haggis-aerospace/HaggisAero2021-22/renders/cbf.JPG

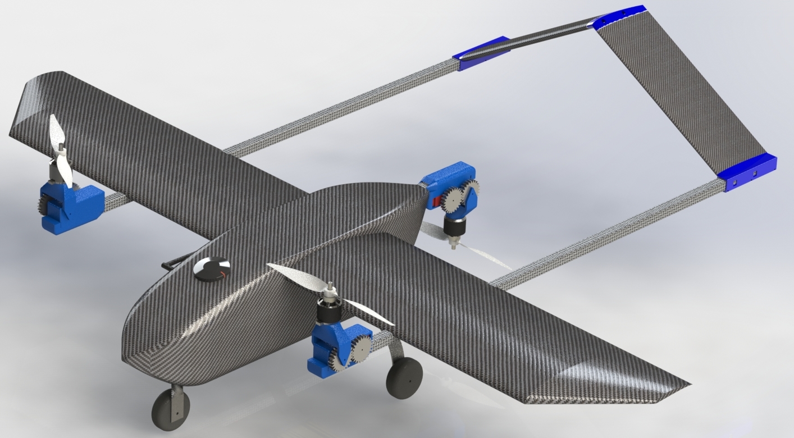
renders/cbf.JPG
