haggis-aerospace/HaggisAero2021-22/README.md

# HaggisAero2021-22
Haggis aerospace drone design repo used to share solidworks and other files

when moddeling create a new branch and when you think its good, tell the admin to check it and try to merge it with the main. DO NOT PUSH STRAIGHT TO MAIN if your not sure its not gonna break stuff.
