haggis-aerospace/HaggisAero2021-22/Finalised challenge documents/team 25-pdr-submission-form.pdf

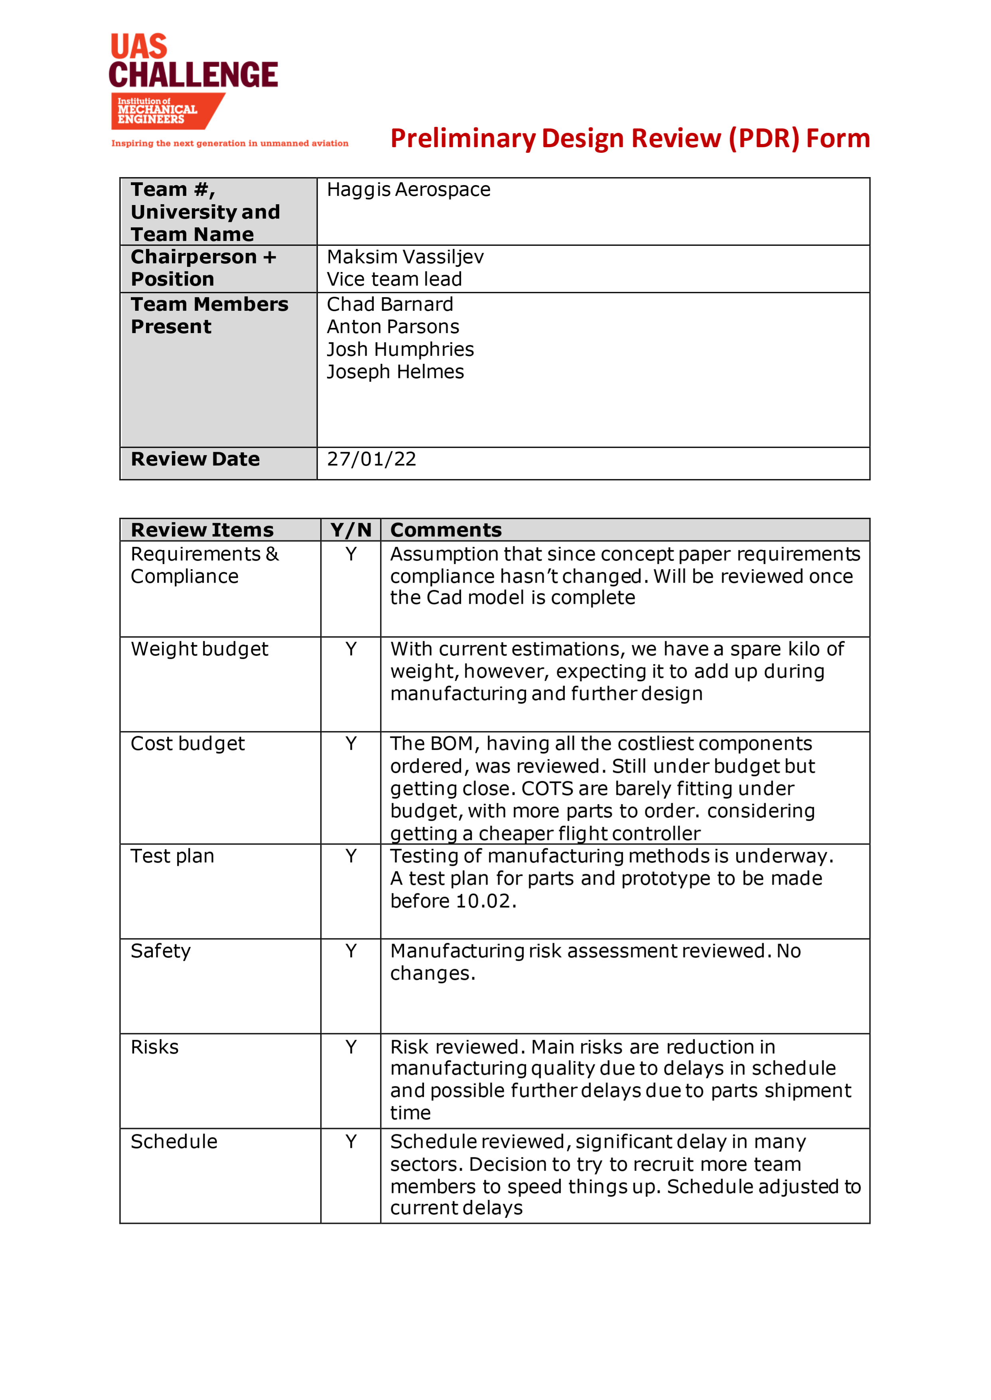
[picture p17: page 1]
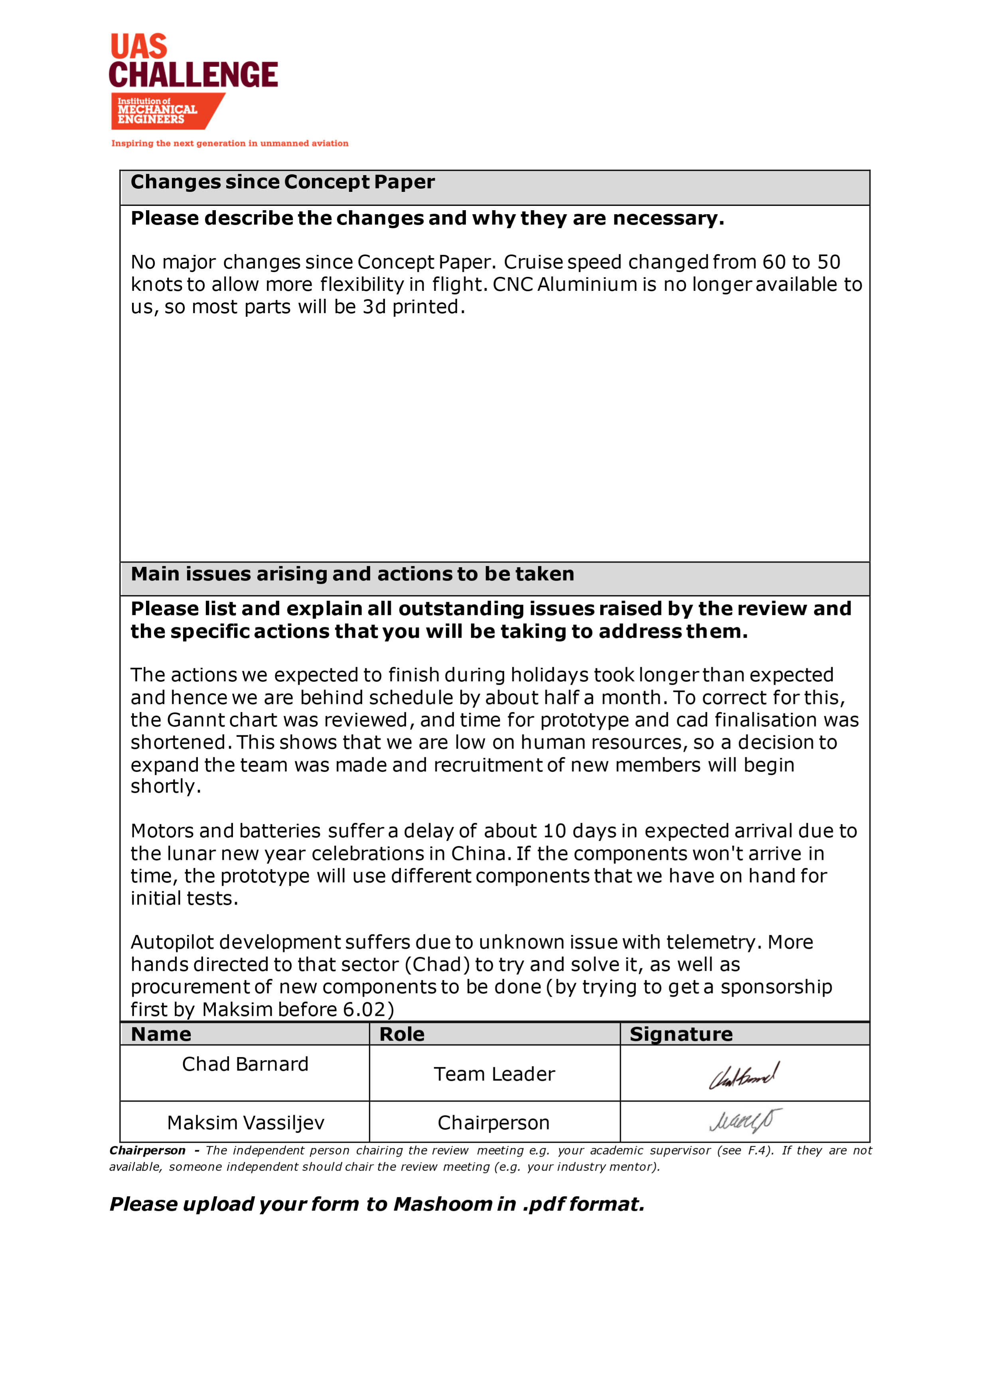
[picture p18: page 2]
