haggis-aerospace/HaggisAero2021-22/CAD/Tail/side.pdf

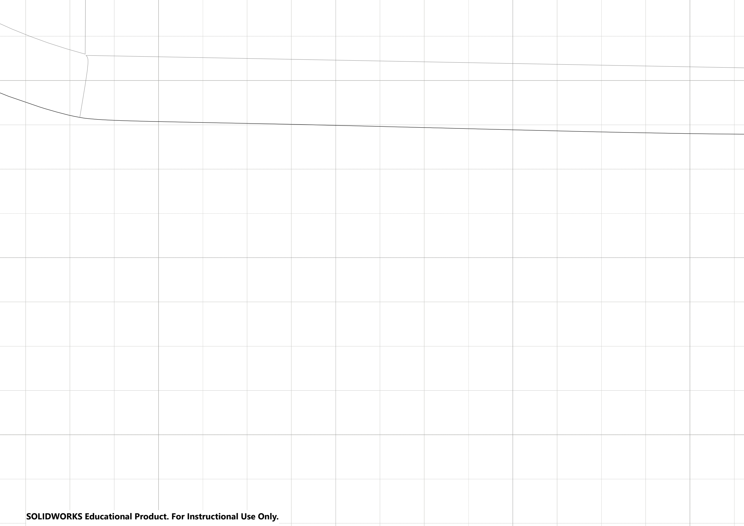
[picture p19: figure]

SOLIDWORKS Educational Product. For Instructional Use Only.
