haggis-aerospace/HaggisAero2021-22/renders/drawn.JPG

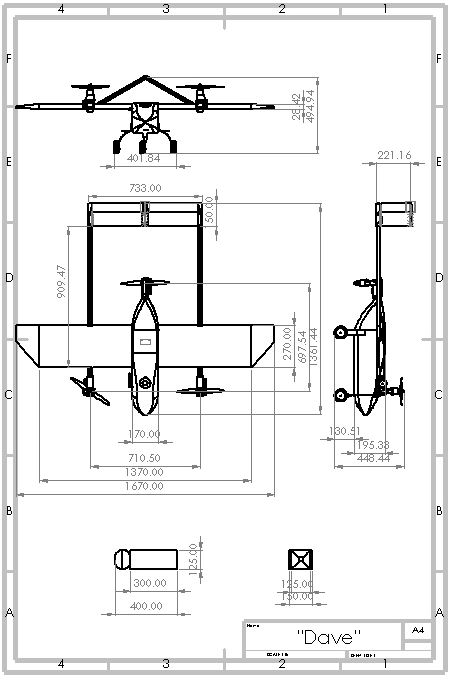
renders/drawn.JPG
