haggis-aerospace/HaggisAero2021-22/simulations/wing.png

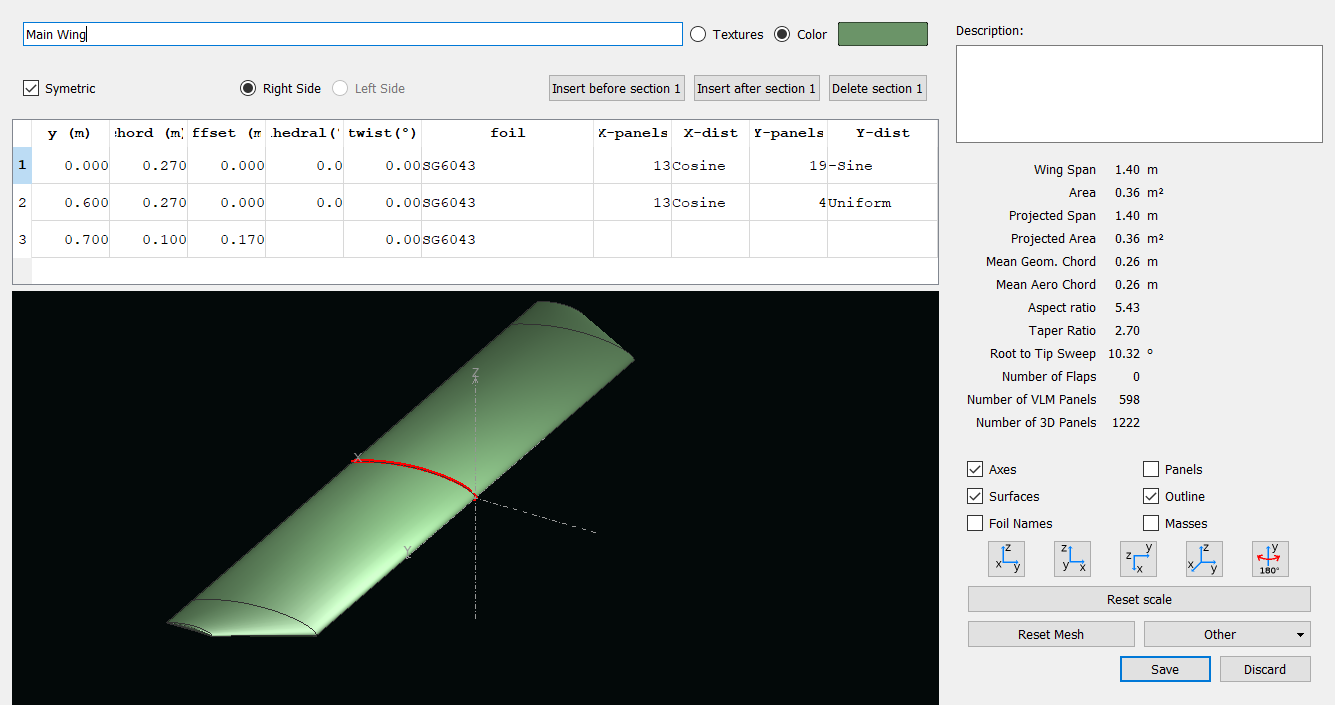
simulations/wing.png
