haggis-aerospace/HaggisAero2021-22/CAD/Motor rotator 2/Motor rotator assembly 3.SLDASM

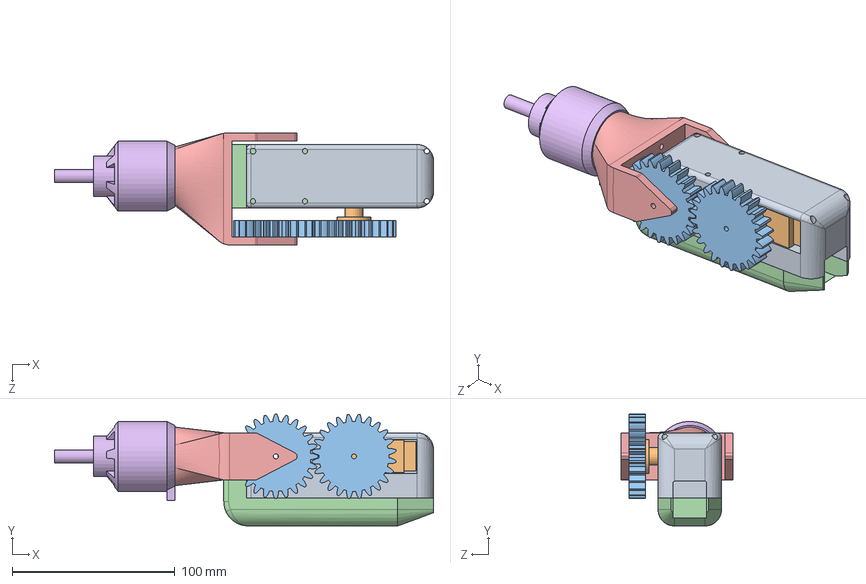
[picture p22: CAD file, 2022-06-10]
CAD/Motor rotator 2/Motor rotator assembly 3.SLDASM
232.9 x 68.7 x 68.7 mm
Rotator Base 2
Servo futaba
spur gear_iso x 2
Rotator bottom
Fork 3
Motor Tmotor mn3520-11 400kv
