haggis-aerospace/HaggisAero2021-22/CAD/Motor rotator/Motor Rotator Assembly.SLDASM

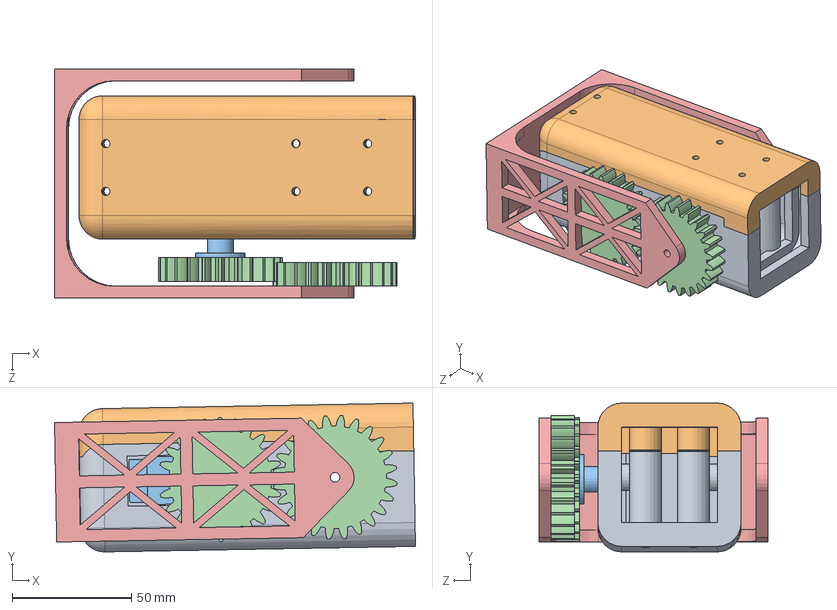
[picture p23: CAD file, 2022-03-11]
CAD/Motor rotator/Motor Rotator Assembly.SLDASM
151.1 x 62.3 x 96.0 mm
Rotator Base
Rotator Lid
Servo futaba
spur gear_iso x 2
Fork
