haggis-aerospace/HaggisAero2021-22/manufacturing/Wing/main wing stencil.SLDPRT

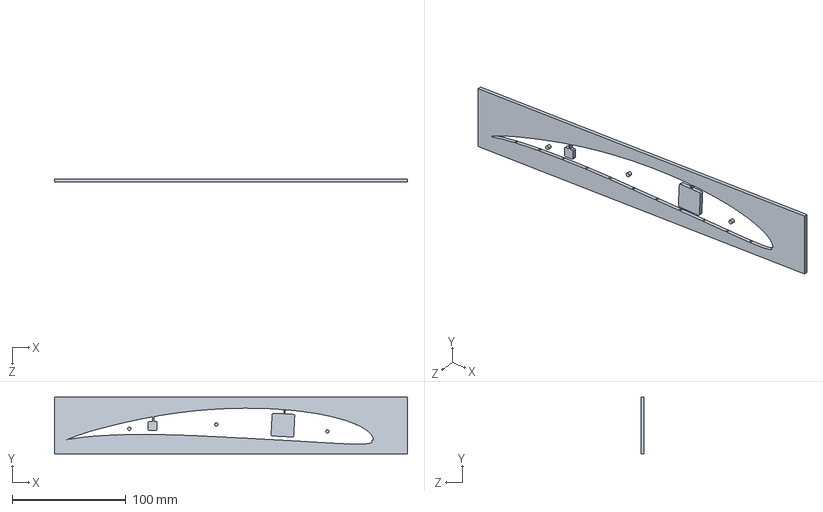
[picture p24: CAD file, 2022-06-06]
manufacturing/Wing/main wing stencil.SLDPRT
310.0 x 50.0 x 3.00 mm
