haggis-aerospace/HaggisAero2021-22/CAD/Fuselage/3dp parts/main spar side holder.SLDPRT

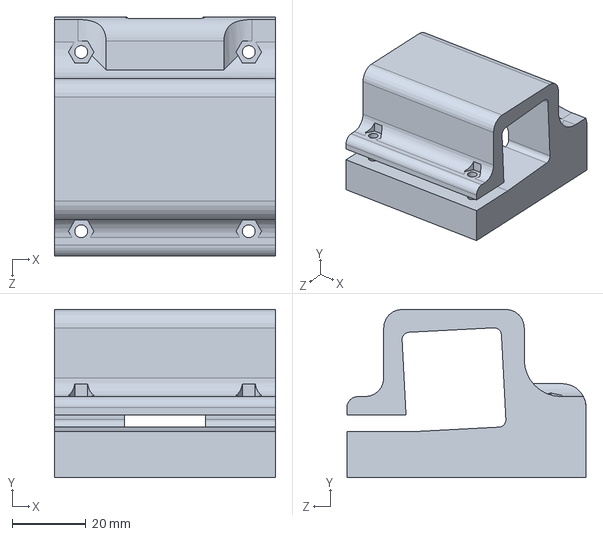
[picture p25: CAD file, 2022-04-14]
CAD/Fuselage/3dp parts/main spar side holder.SLDPRT
60.0 x 45.7 x 65.0 mm
