haggis-aerospace/HaggisAero2021-22/CAD/Fuselage_Payload/Payload assy.SLDASM

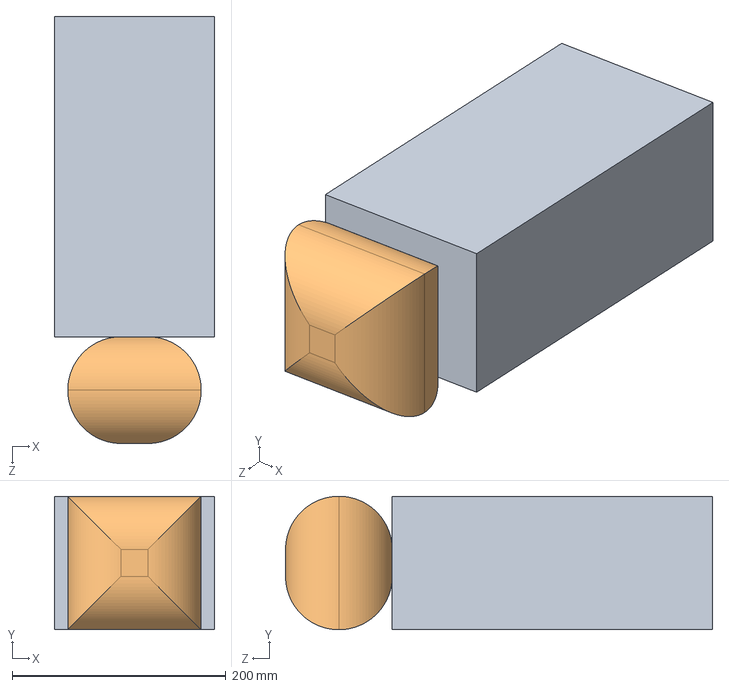
[picture p26: CAD file, 2022-04-14]
CAD/Fuselage_Payload/Payload assy.SLDASM
150.0 x 125.0 x 400.0 mm
Payload
PParachute
