haggis-aerospace/HaggisAero2021-22/CAD/landing gear/rear assy.SLDASM

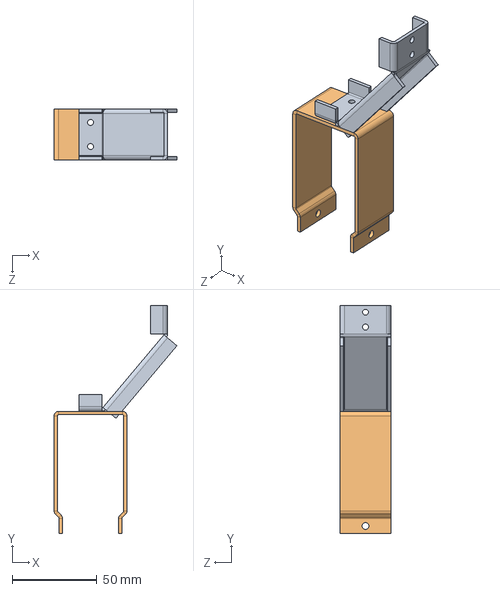
[picture p27: CAD file, 2022-06-29]
CAD/landing gear/rear assy.SLDASM
72.4 x 134.3 x 30.0 mm
rear gear base
rear U bracket
