haggis-aerospace/HaggisAero2021-22/CAD/Tail.SLDASM

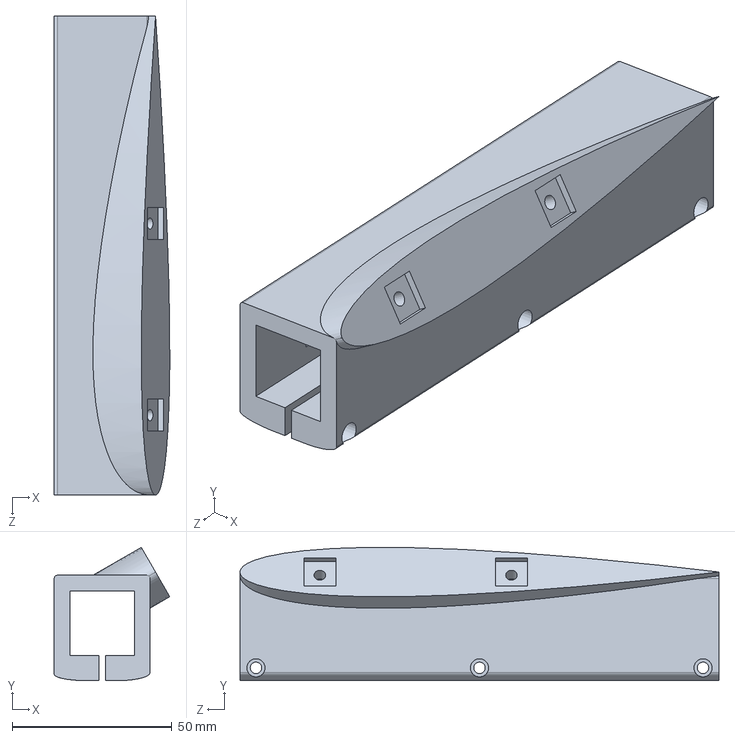
[picture p28: CAD file, 2022-04-14]
CAD/Tail.SLDASM
36.2 x 41.7 x 150.0 mm
