haggis-aerospace/HaggisAero2021-22/CAD/Wing/wing assembly.SLDASM

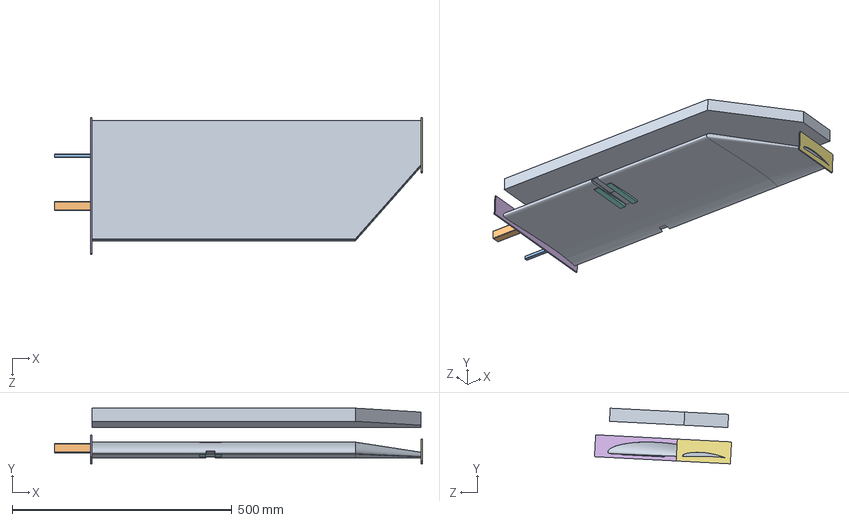
[picture p29: CAD file, 2022-06-21]
CAD/Wing/wing assembly.SLDASM
838.0 x 126.8 x 312.2 mm
wing spar large
wing spar small
MainFoil
battery 4s 2p
tail wing conector
