haggis-aerospace/HaggisAero2021-22/manufacturing/Endplates/Main Wing Endplate.SLDPRT

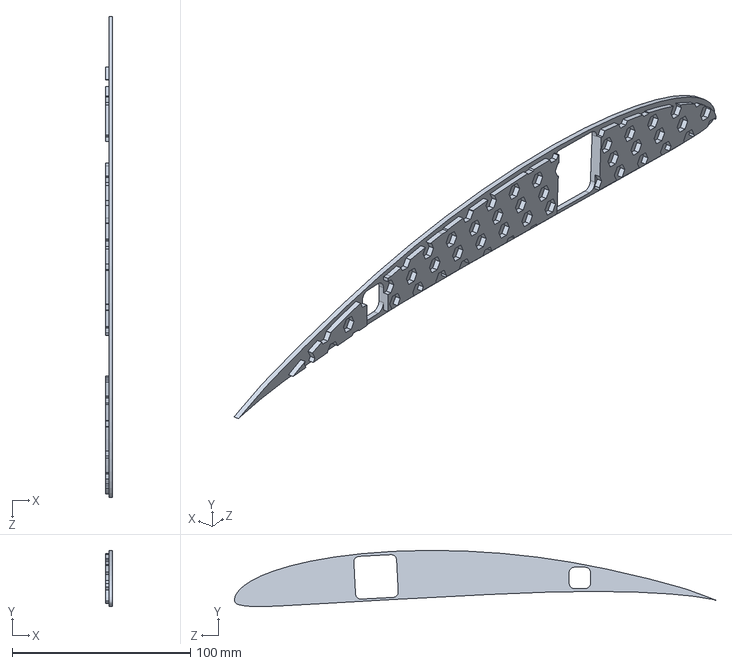
[picture p30: CAD file, 2022-06-18]
manufacturing/Endplates/Main Wing Endplate.SLDPRT
4.00 x 31.6 x 270.0 mm
