haggis-aerospace/HaggisAero2021-22/manufacturing/Wing/FAT main wing stencilS 3.DXF

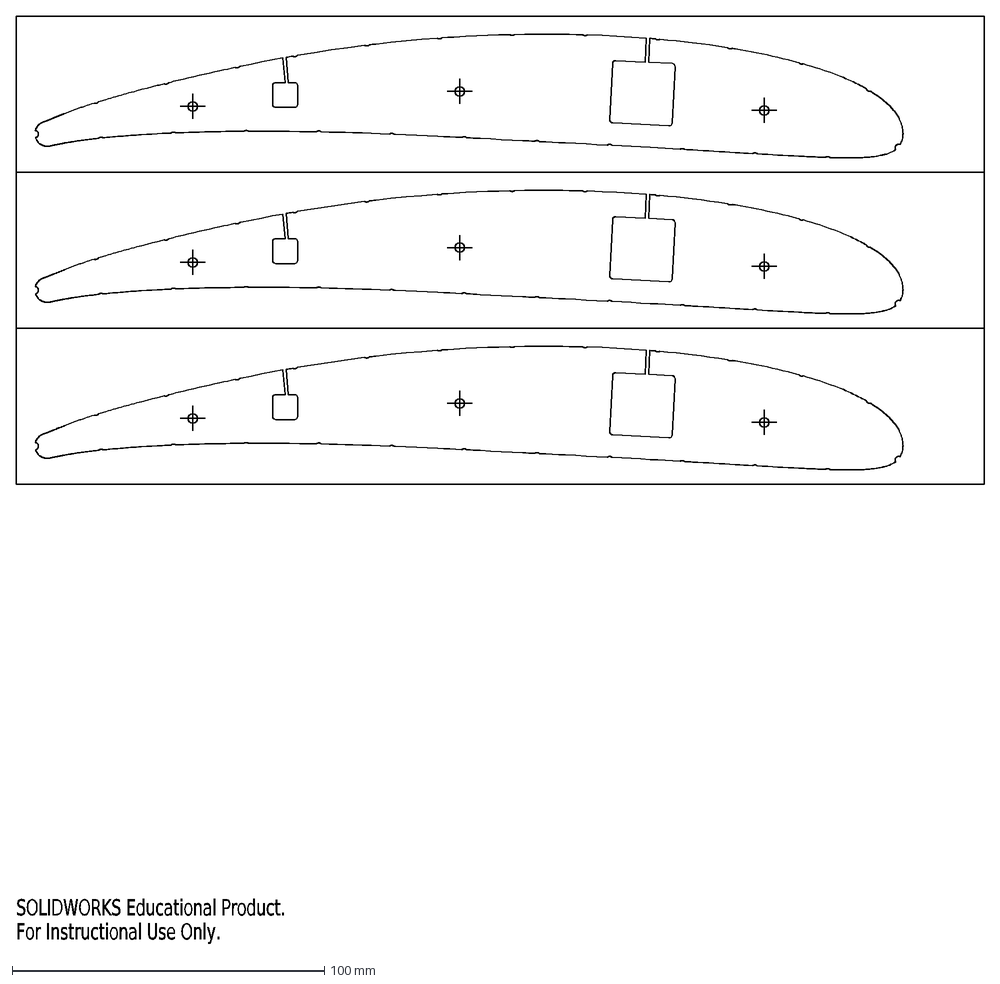
[picture p31: CAD file, 2022-06-06]
manufacturing/Wing/FAT main wing stencilS 3.DXF
SOLIDWORKS Educational Product.
For Instructional Use Only.
