haggis-aerospace/HaggisAero2021-22/Tail/tail assy.SLDASM

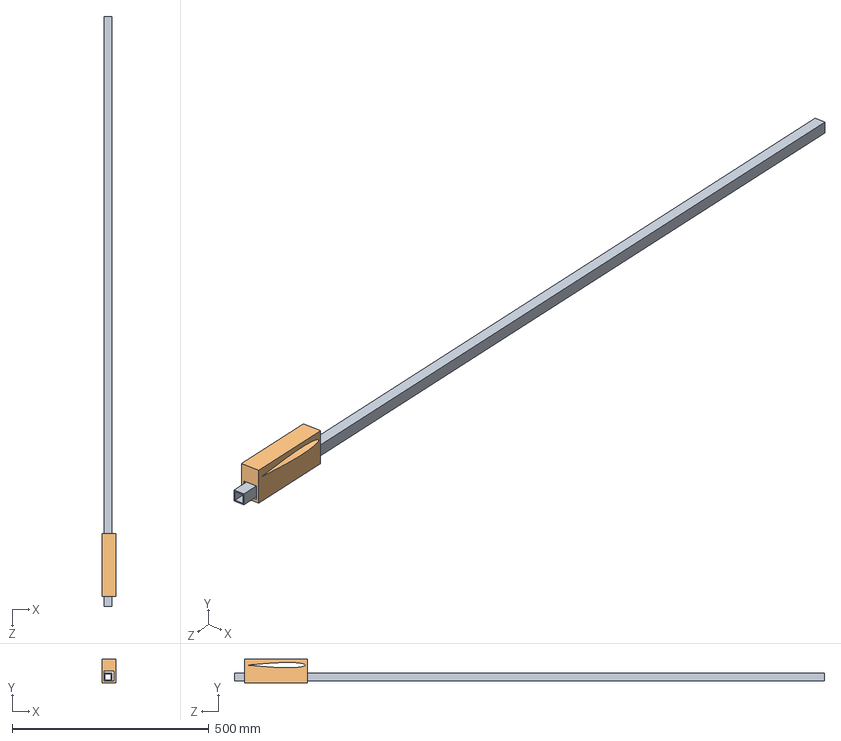
[picture p32: CAD file, 2023-02-27]
Tail/tail assy.SLDASM
35.0 x 60.3 x 1500.0 mm
tail spar
bracket^TAIL2023
