haggis-aerospace/HaggisAero2021-22/CAD/Motor mount/static motor mount assembly.SLDASM

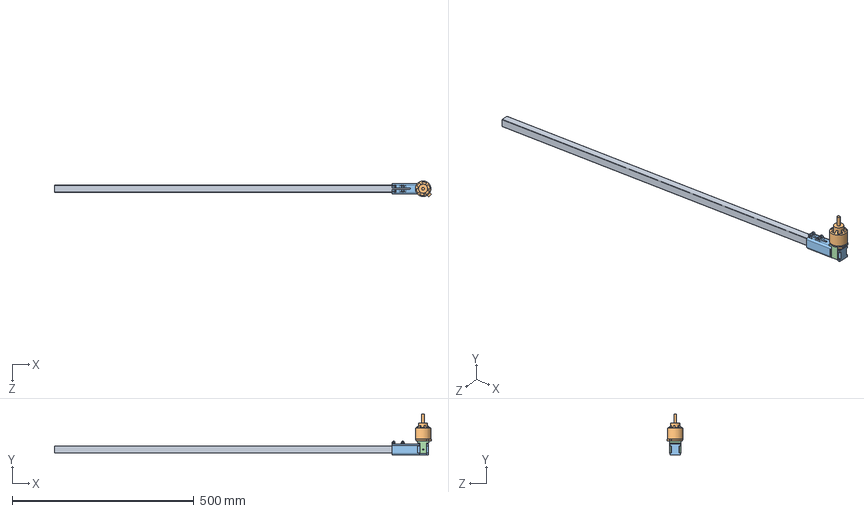
[picture p33: CAD file, 2022-06-07]
CAD/Motor mount/static motor mount assembly.SLDASM
1036.0 x 112.5 x 44.5 mm
tail booom
Motor Tmotor mn3520-11 400kv
base
motor plate
