haggis-aerospace/HaggisAero2021-22/CAD/Motor rotator 2/MirrorMotor rotator assembly 3.SLDASM

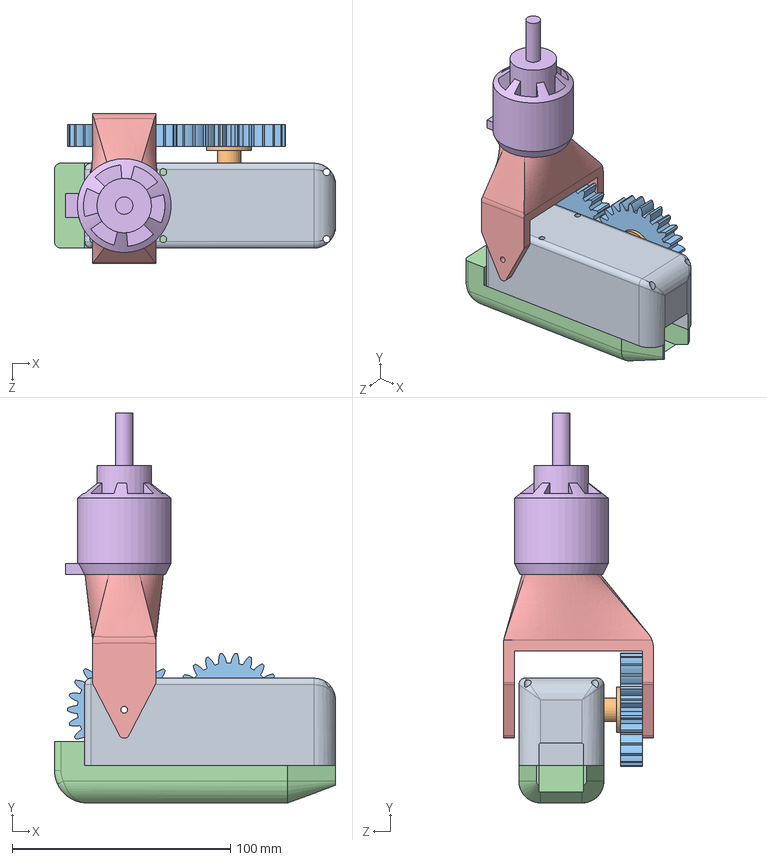
[picture p34: CAD file, 2022-04-14]
CAD/Motor rotator 2/MirrorMotor rotator assembly 3.SLDASM
128.9 x 178.8 x 68.7 mm
MirrorRotator Base 2
MirrorServo futaba
spur gear_iso x 2
MirrorRotator bottom
MirrorFork 3
MirrorMotor Tmotor mn3520-11 400kv
