haggis-aerospace/HaggisAero2021-22/manufacturing/stl's for 3 print/main spar side holder.STL

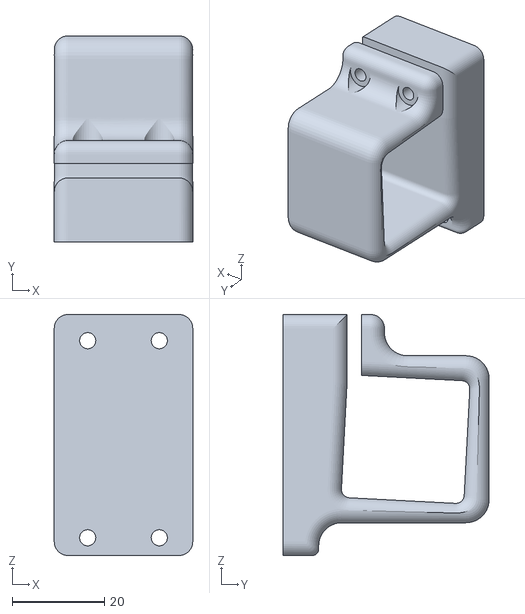
[picture p35: CAD file, 2022-03-09]
manufacturing/stl's for 3 print/main spar side holder.STL
30.0 x 44.7 x 52.2
