haggis-aerospace/HaggisAero2021-22/Tail/TAIL2023.SLDASM

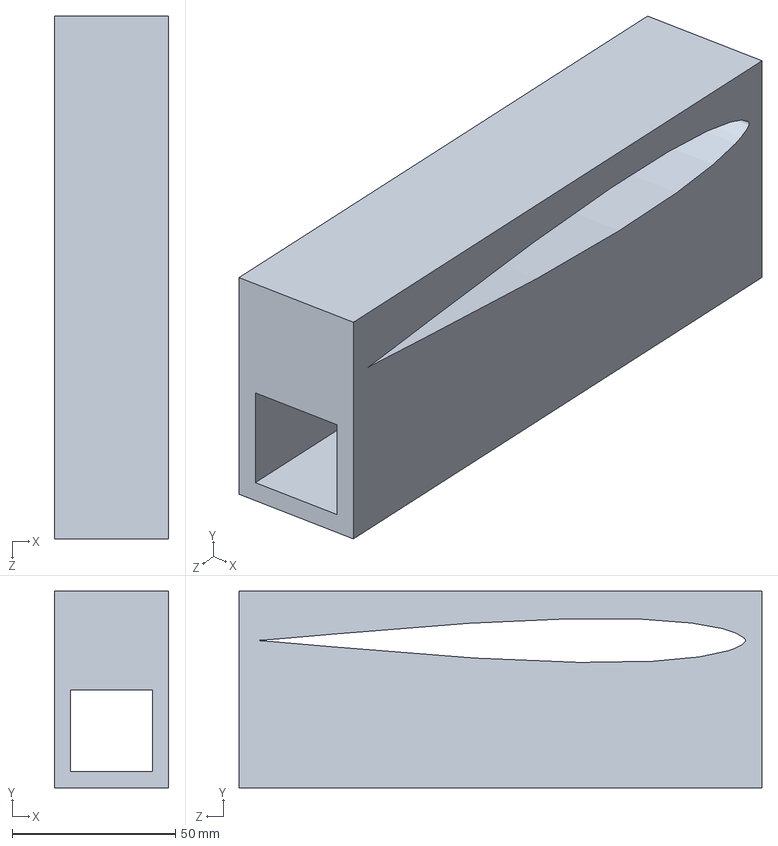
[picture p36: CAD file, 2023-02-27]
Tail/TAIL2023.SLDASM
35.0 x 60.3 x 160.0 mm
