haggis-aerospace/HaggisAero2021-22/CAD/Masterr assembly.SLDASM

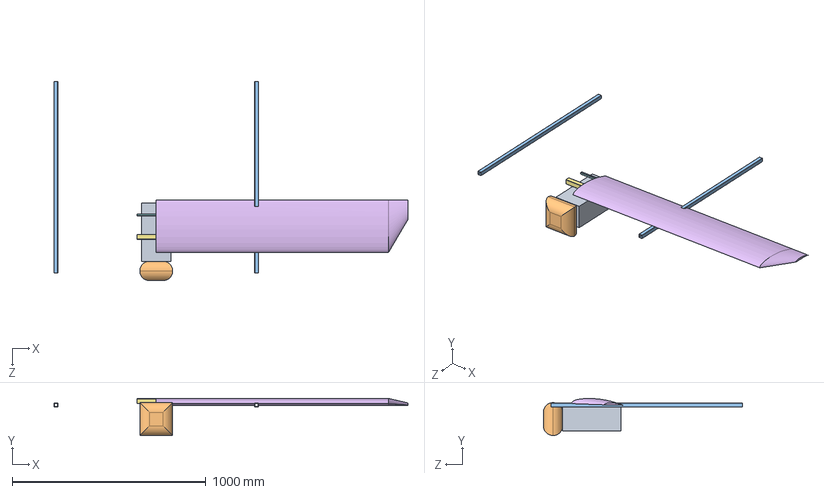
[picture p37: CAD file, 2022-01-28]
CAD/Masterr assembly.SLDASM
1828.0 x 191.2 x 1029.0 mm
Payload
PParachute
tail booom x 2
wing spar large
wing spar small
MainFoil
center spar connector
small center sparr connector
