haggis-aerospace/HaggisAero2021-22/CAD/Wing/MainFoil.SLDPRT

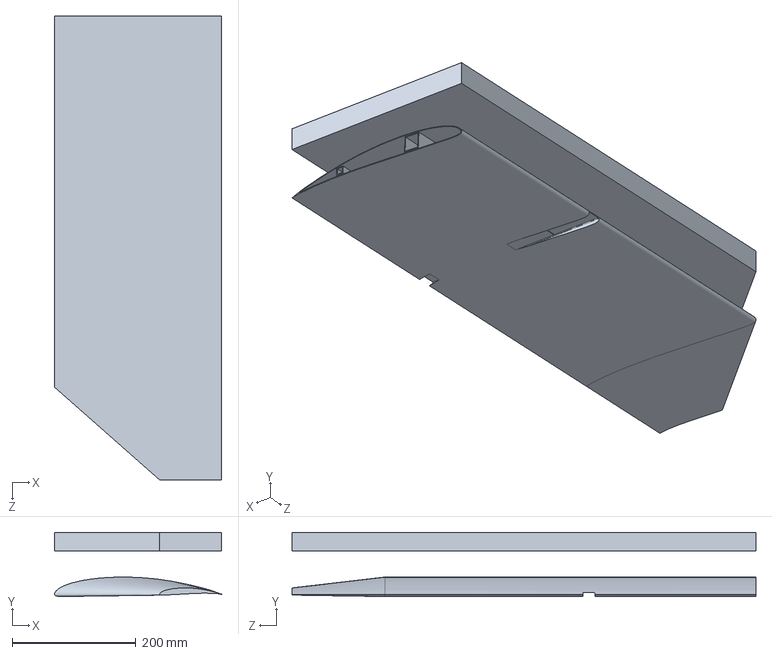
[picture p38: CAD file, 2022-06-21]
CAD/Wing/MainFoil.SLDPRT
270.0 x 103.7 x 750.0 mm
