haggis-aerospace/HaggisAero2021-22/manufacturing/Endplates/Assem1.SLDASM

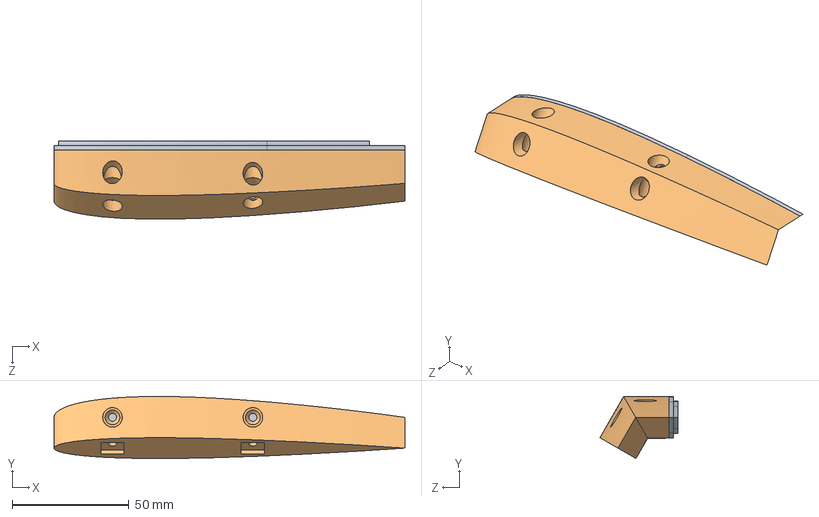
[picture p39: CAD file, 2022-06-18]
manufacturing/Endplates/Assem1.SLDASM
150.0 x 26.5 x 33.5 mm
Tail wing endplate
Tail_Top_Piece_V2
