haggis-aerospace/HaggisAero2021-22/manufacturing/fuselage mold/mould assy.SLDASM

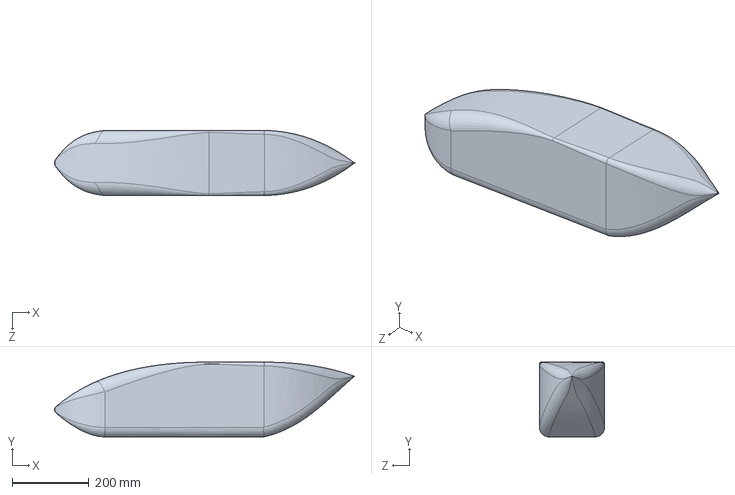
[picture p40: CAD file, 2022-02-09]
manufacturing/fuselage mold/mould assy.SLDASM
783.9 x 195.3 x 170.0 mm
