haggis-aerospace/HaggisAero2021-22/CAD/Electronics/rasbery pi/RaspberryPi.SLDASM

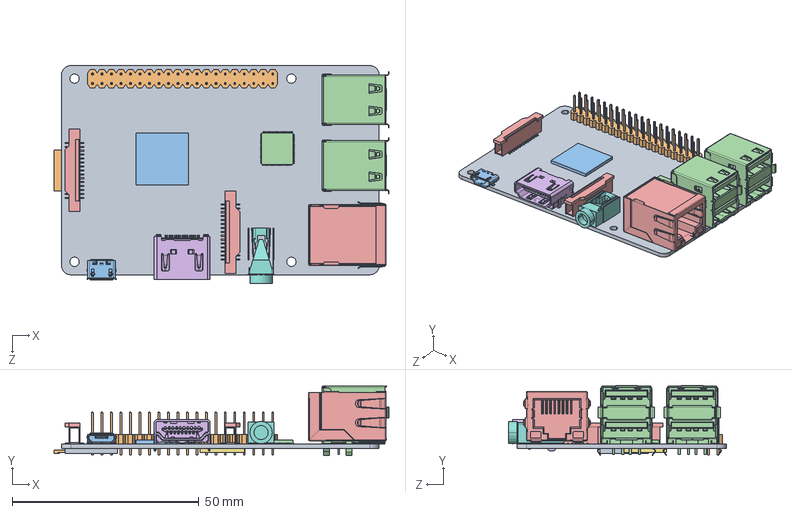
[picture p42: CAD file, 2022-02-02]
CAD/Electronics/rasbery pi/RaspberryPi.SLDASM
89.6 x 18.7 x 58.3 mm
Mainboard2
GPIO
Processor
GPU
CameraAssembly x 2
HDMI
RAM
Audio
MicroSDSocket
MicroSD
micro USB2
usb double x 2
RJ45-LED
