haggis-aerospace/HaggisAero2021-22/CAD/landing gear/assy of LG.SLDASM

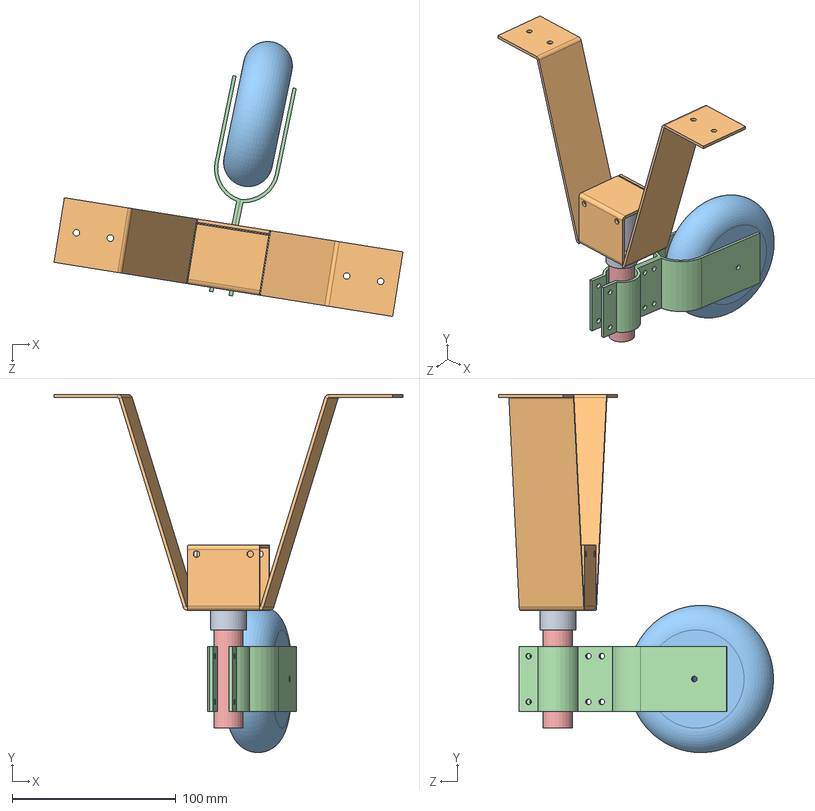
[picture p43: CAD file, 2022-06-29]
CAD/landing gear/assy of LG.SLDASM
213.4 x 219.0 x 168.1 mm
thick cf tube
front landing gear frame
wheel forn
lower part x 2
thin CF tube
