haggis-aerospace/HaggisAero2021-22/manufacturing/Wing/main wing stencil x1.DXF

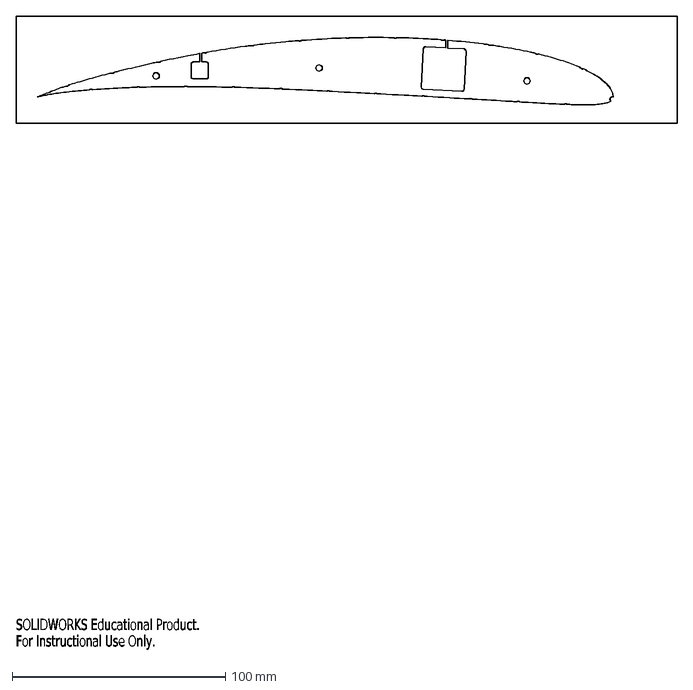
[picture p44: CAD file, 2022-06-06]
manufacturing/Wing/main wing stencil x1.DXF
SOLIDWORKS Educational Product.
For Instructional Use Only.
