haggis-aerospace/HaggisAero2021-22/CAD/rotating mtr mount/S45 ONYX STANDARD METAL GEAR SERVO.stp.SLDASM

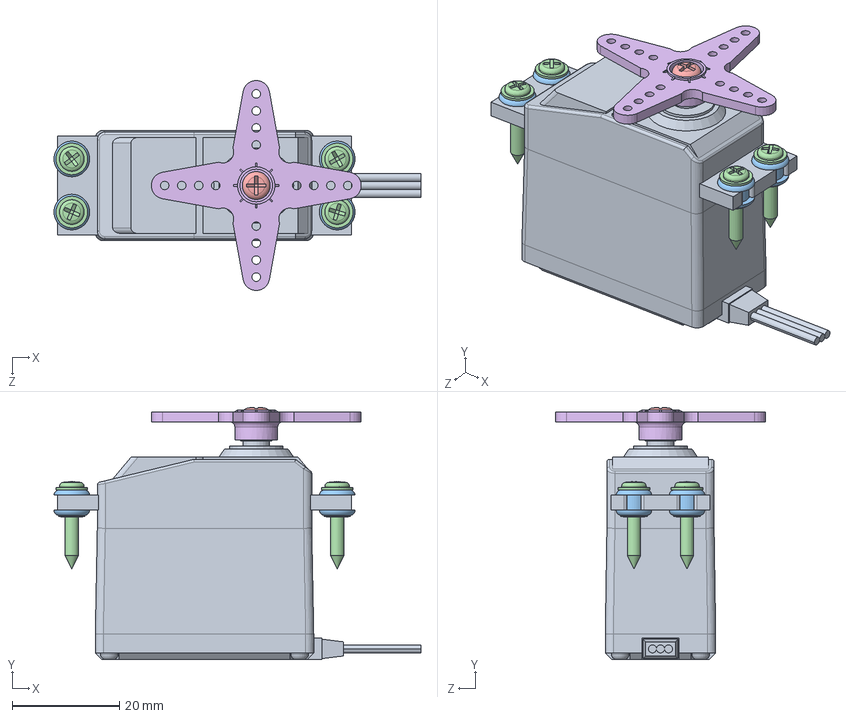
[picture p45: CAD file, 2022-06-10]
CAD/rotating mtr mount/S45 ONYX STANDARD METAL GEAR SERVO.stp.SLDASM
68.4 x 47.0 x 39.1 mm
S45 ONYX STANDARD METAL GEAR SERVO.stp
S45 ONYX STANDARD METAL GEAR SERVO (EYELET).stp x 4
S45 ONYX STANDARD METAL GEAR SERVO (GROMMET).stp x 4
S45 ONYX STANDARD METAL GEAR SERVO (SCREW).stp x 4
S45 ONYX STANDARD METAL GEAR SERVO (M3 SCREW).stp
4-PRONG SERVO ARM ONYX.stp
