haggis-aerospace/HaggisAero2021-22/manufacturing/Wing/FAT main and back wing stencils.DXF

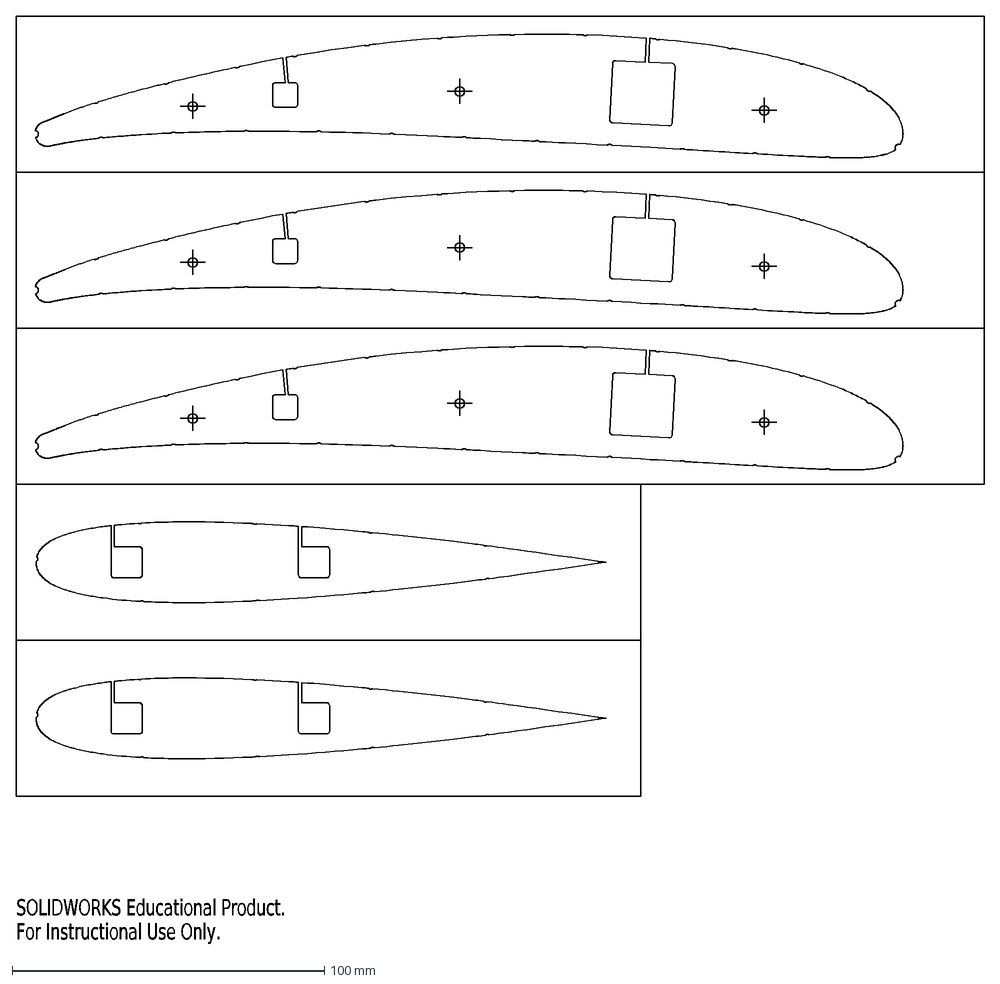
[picture p46: CAD file, 2022-06-06]
manufacturing/Wing/FAT main and back wing stencils.DXF
SOLIDWORKS Educational Product.
For Instructional Use Only.
