haggis-aerospace/HaggisAero2021-22/CAD/landing gear/assy lg v2.SLDASM

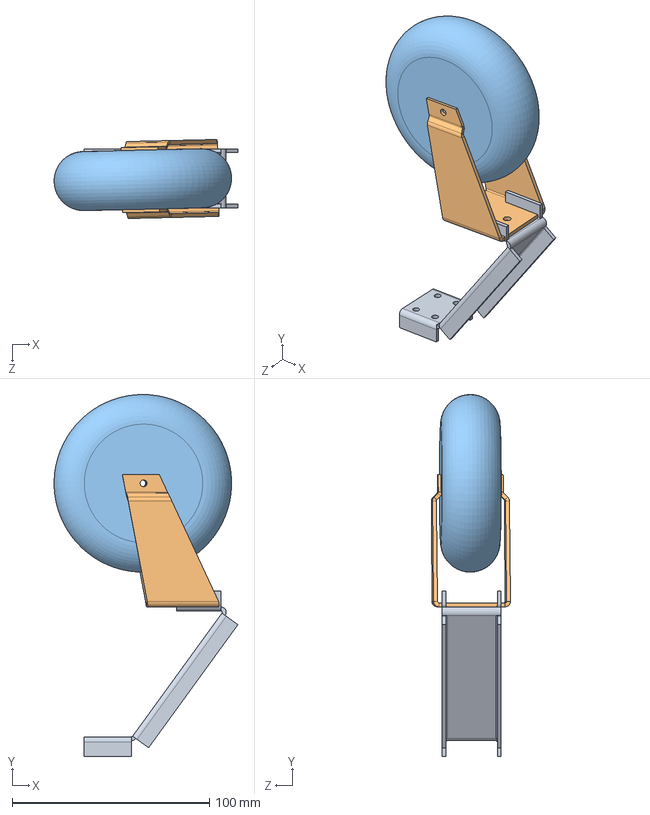
[picture p47: CAD file, 2022-06-29]
CAD/landing gear/assy lg v2.SLDASM
93.1 x 183.4 x 40.0 mm
base v2
v2 u bracket
wheel forn
