haggis-aerospace/HaggisAero2021-22/CAD/Fuselage/door assemblyV2.SLDASM

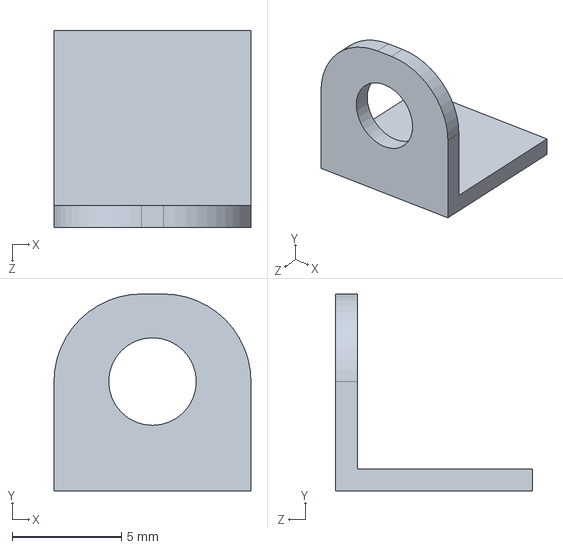
[picture p48: CAD file, 2022-02-09]
CAD/Fuselage/door assemblyV2.SLDASM
9.00 x 9.00 x 9.00 mm
