haggis-aerospace/HaggisAero2021-22/CAD/rotating mtr mount/motor mount assembly.SLDASM

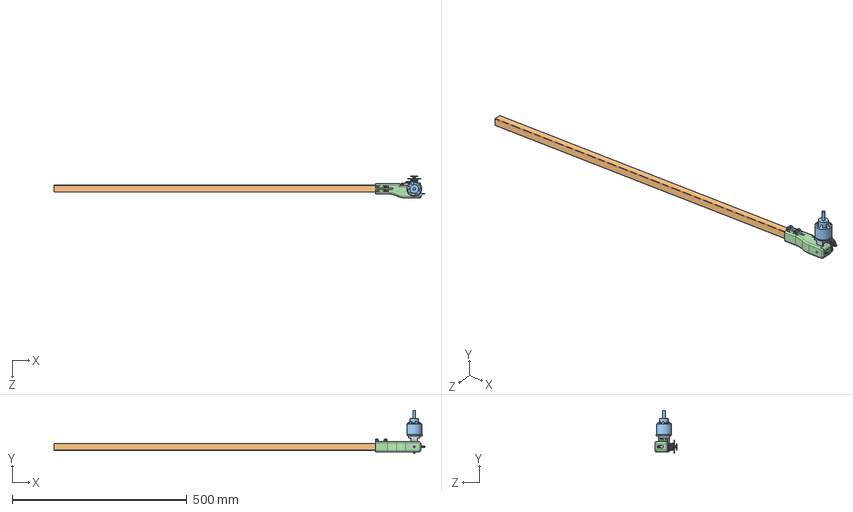
[picture p49: CAD file, 2022-06-10]
CAD/rotating mtr mount/motor mount assembly.SLDASM
1061.8 x 124.1 x 63.4 mm
tail booom
Motor Tmotor mn3520-11 400kv
rotaty base 2
motor plate
Servo futaba
S45 ONYX STANDARD METAL GEAR SERVO.stp
S45 ONYX STANDARD METAL GEAR SERVO (EYELET).stp x 4
S45 ONYX STANDARD METAL GEAR SERVO (GROMMET).stp x 4
S45 ONYX STANDARD METAL GEAR SERVO (SCREW).stp x 4
S45 ONYX STANDARD METAL GEAR SERVO (M3 SCREW).stp
4-PRONG SERVO ARM ONYX.stp
bolt m3 16mm
ROUND SERVO ARM ONYX 2
