haggis-aerospace/HaggisAero2021-22/CAD/Electronics/HERE GPS.SLDASM

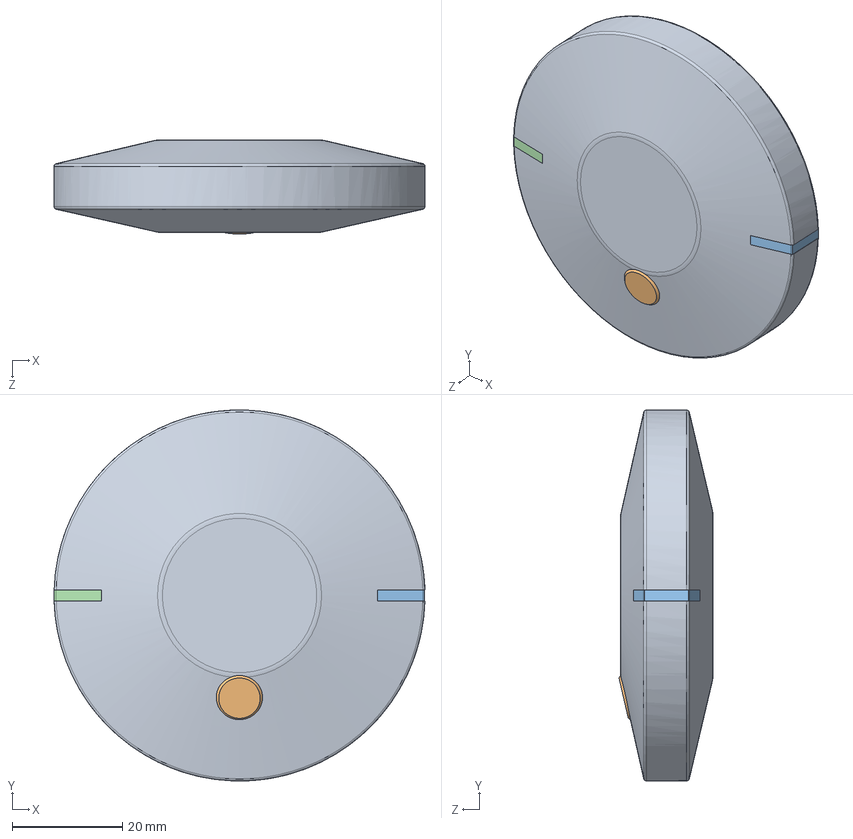
[picture p50: CAD file, 2022-02-02]
CAD/Electronics/HERE GPS.SLDASM
67.2 x 67.2 x 17.0 mm
Component1.iges
Component2.iges
Component3.iges
Component5.iges
