haggis-aerospace/HaggisAero2021-22/CAD/Electronics/rasbery pi/Raspberry Pi Enclosure - 10MSW.SLDASM

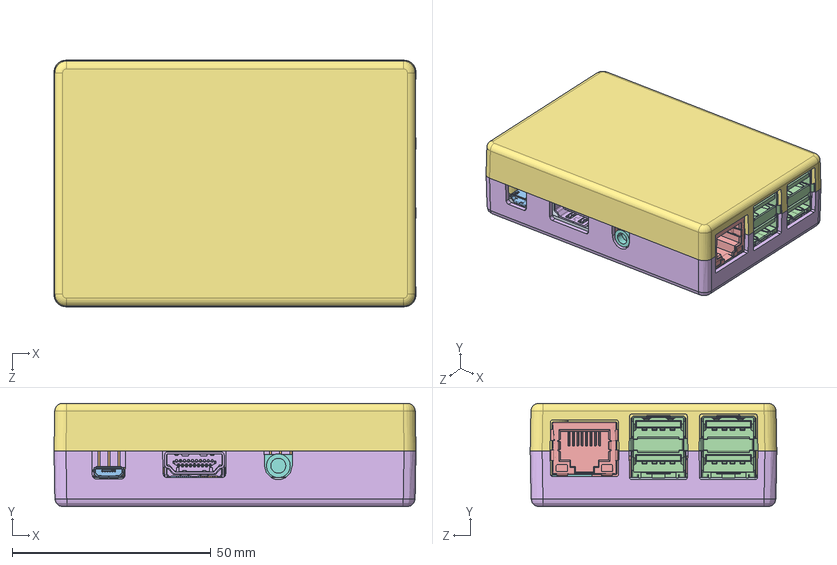
[picture p51: CAD file, 2022-02-02]
CAD/Electronics/rasbery pi/Raspberry Pi Enclosure - 10MSW.SLDASM
91.0 x 26.0 x 62.0 mm
Mainboard2^RaspberryPi(2)_RaspberryPi
GPIO^RaspberryPi(2)_RaspberryPi
Processor^RaspberryPi(2)_RaspberryPi
GPU^RaspberryPi(2)_RaspberryPi
CameraAssembly^RaspberryPi(2)_RaspberryPi x 2
HDMI^RaspberryPi(2)_RaspberryPi
RAM^RaspberryPi(2)_RaspberryPi
Audio^RaspberryPi(2)_RaspberryPi
MicroSDSocket^RaspberryPi(2)_RaspberryPi
MicroSD^RaspberryPi(2)_RaspberryPi
micro USB2^RaspberryPi(2)_RaspberryPi
usb double^RaspberryPi(2)_RaspberryPi x 2
RJ45-LED^RaspberryPi(2)_RaspberryPi
Enclosure Base
Enclosure Top
pan cross head_am x 4
