haggis-aerospace/HaggisAero2021-22/CAD/Electronics/Transmitter.SLDASM

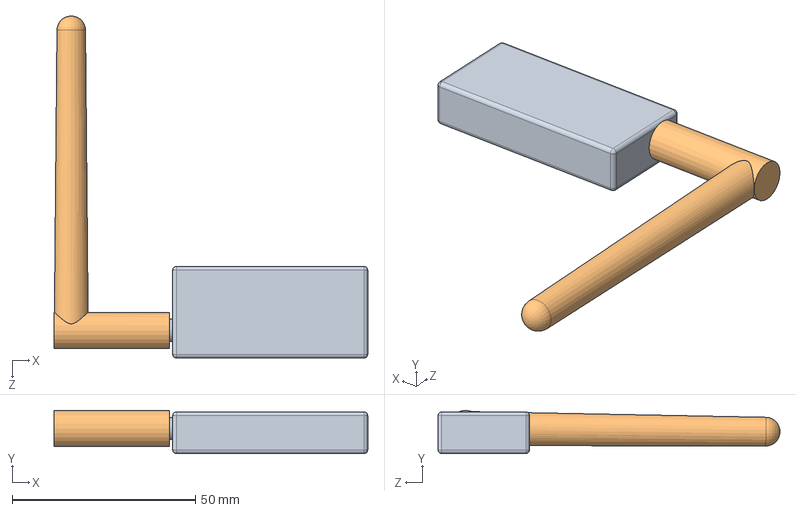
[picture p52: CAD file, 2022-02-02]
CAD/Electronics/Transmitter.SLDASM
85.7 x 11.8 x 93.4 mm
Transmitter Body
Transmitter Antenna
