haggis-aerospace/HaggisAero2021-22/CAD/Motor rotator 2/Motor rotator assembly 2.SLDASM

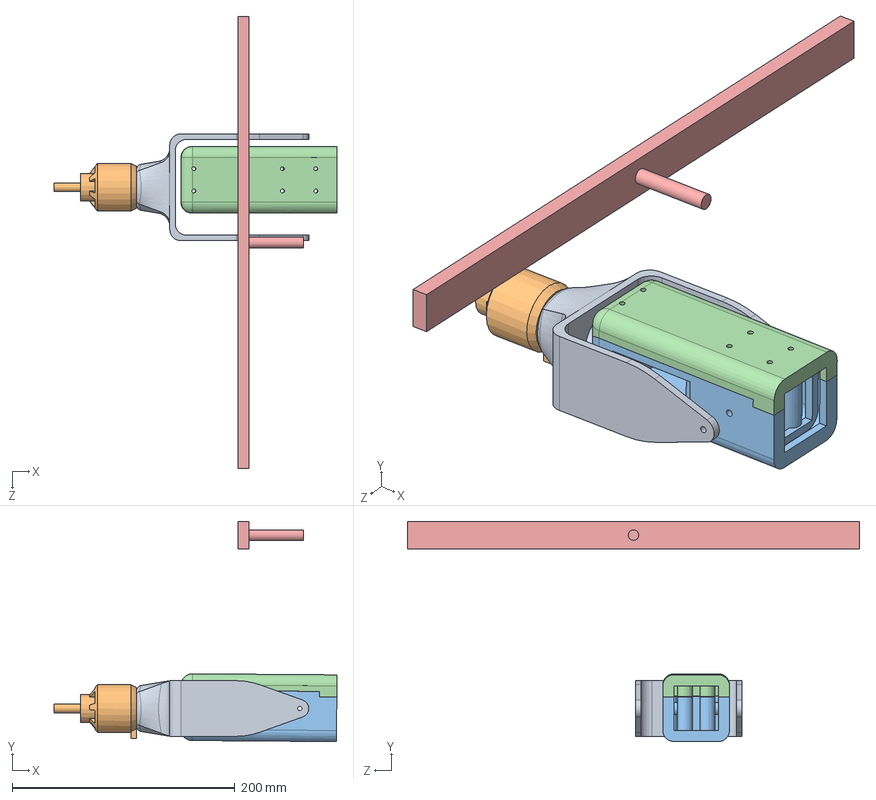
[picture p53: CAD file, 2022-03-11]
CAD/Motor rotator 2/Motor rotator assembly 2.SLDASM
254.4 x 197.9 x 406.4 mm
Fork 2
Motor Tmotor mn3520-11 400kv
Rotator Base
Rotator Lid
Mock Prop
