haggis-aerospace/HaggisAero2021-22/CAD/Fuselage/Fuselage assy.SLDASM

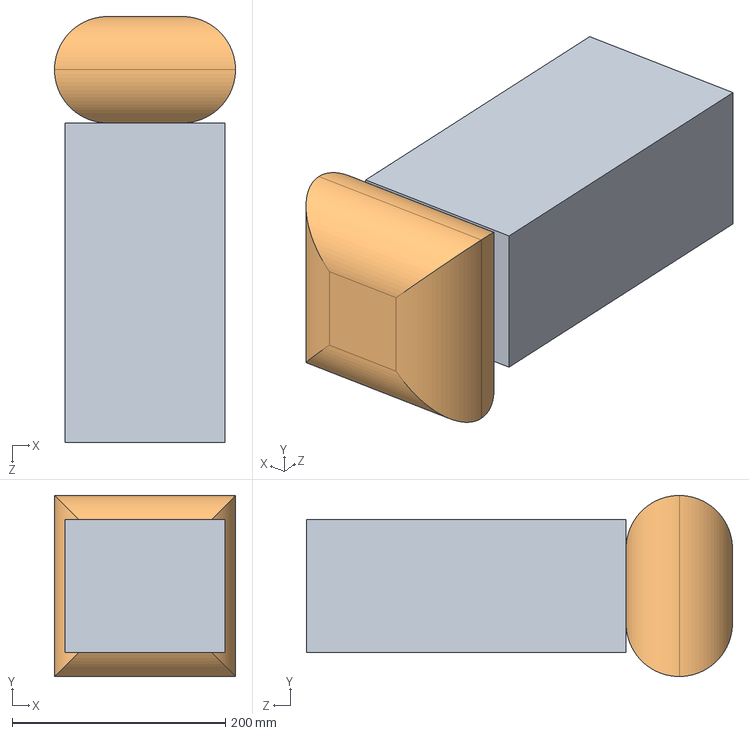
[picture p54: CAD file, 2022-01-03]
CAD/Fuselage/Fuselage assy.SLDASM
170.0 x 170.0 x 400.0 mm
payload
PParachute
