haggis-aerospace/HaggisAero2021-22/CAD/Electronics/battery 4s 2p.SLDPRT

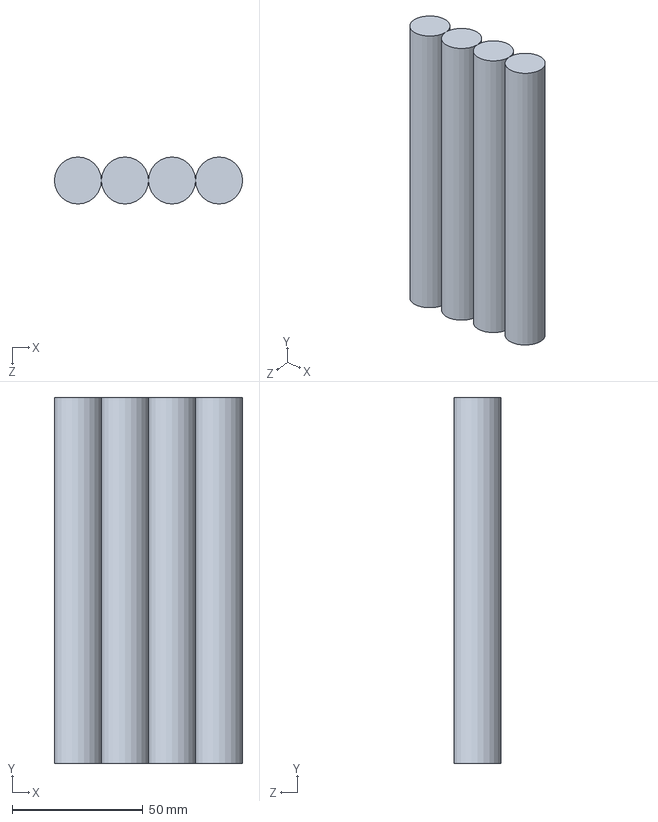
[picture p55: CAD file, 2022-04-14]
CAD/Electronics/battery 4s 2p.SLDPRT
72.0 x 140.0 x 18.0 mm
