haggis-aerospace/HaggisAero2021-22/CAD/Fuselage_Payload/Payload.SLDPRT

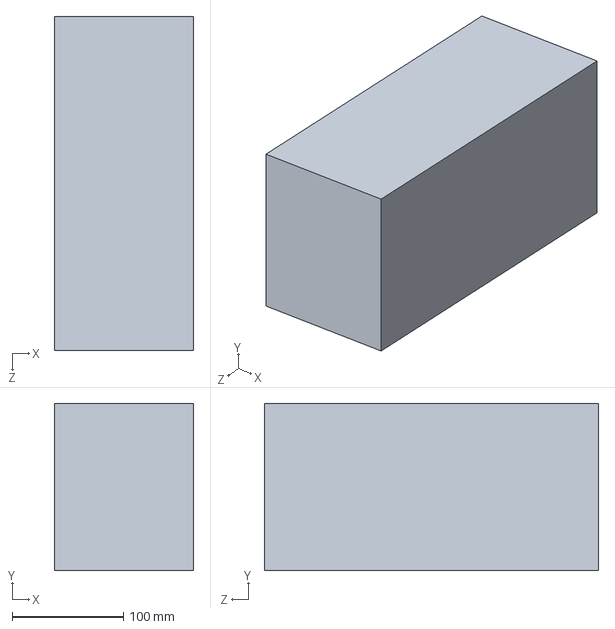
[picture p56: CAD file, 2022-04-14]
CAD/Fuselage_Payload/Payload.SLDPRT
125.0 x 150.0 x 300.0 mm
