haggis-aerospace/HaggisAero2021-22/CAD/general/tail booom.SLDPRT

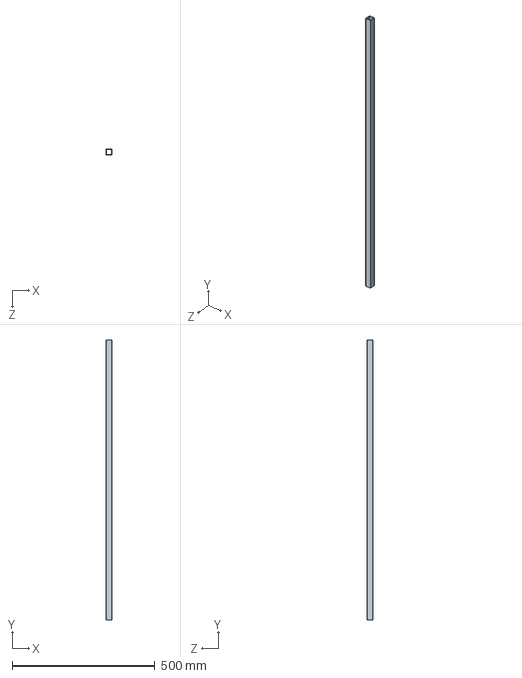
[picture p57: CAD file, 2022-02-02]
CAD/general/tail booom.SLDPRT
20.0 x 980.0 x 20.0 mm
