haggis-aerospace/HaggisAero2021-22/CAD/landing gear/lower part.SLDPRT

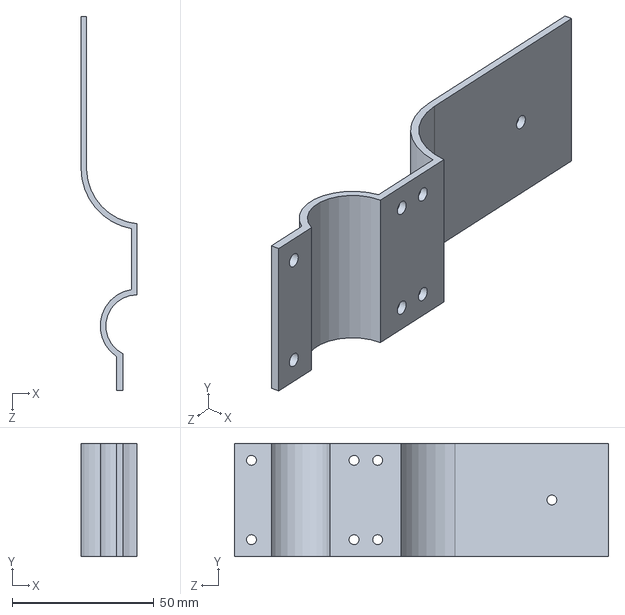
[picture p58: CAD file, 2022-06-29]
CAD/landing gear/lower part.SLDPRT
19.8 x 40.0 x 132.1 mm
