haggis-aerospace/HaggisAero2021-22/CAD/Motor mount/base.SLDPRT

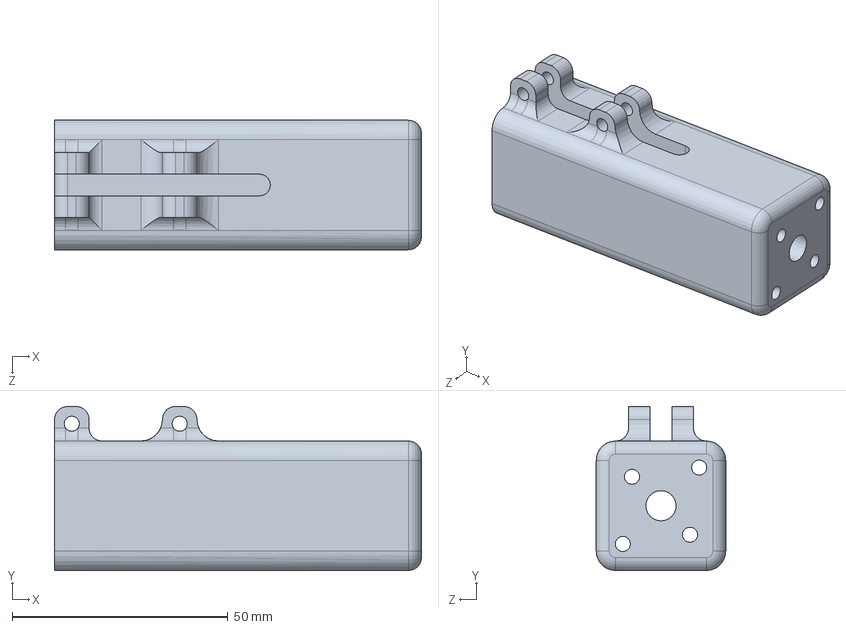
[picture p59: CAD file, 2022-06-29]
CAD/Motor mount/base.SLDPRT
85.0 x 38.0 x 30.0 mm
