haggis-aerospace/HaggisAero2021-22/CAD/Part3.SLDPRT

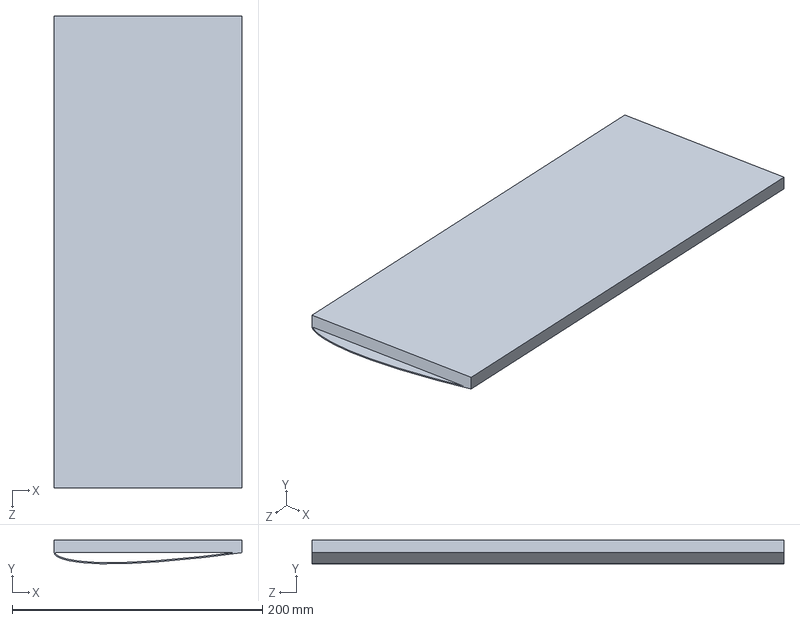
[picture p60: CAD file, 2022-06-21]
CAD/Part3.SLDPRT
150.0 x 18.8 x 377.3 mm
