haggis-aerospace/HaggisAero2021-22/CAD/rotating mtr mount/ROUND SERVO ARM ONYX.stp

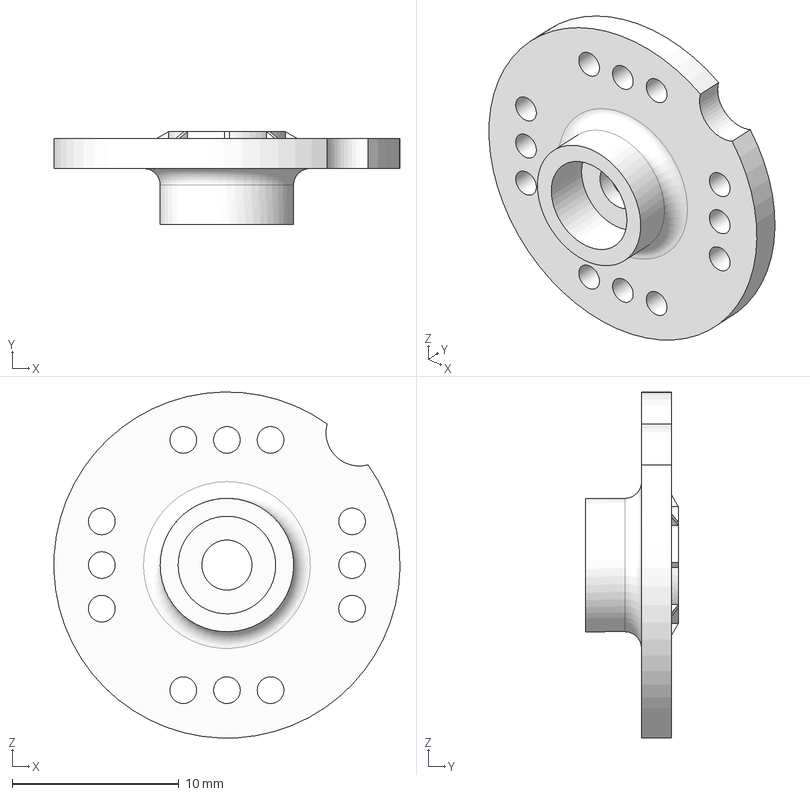
[picture p61: CAD file, 2022-06-10]
CAD/rotating mtr mount/ROUND SERVO ARM ONYX.stp
20.7 x 5.56 x 20.7 mm
