haggis-aerospace/HaggisAero2021-22/CAD/simulations/drag estimate.SLDPRT

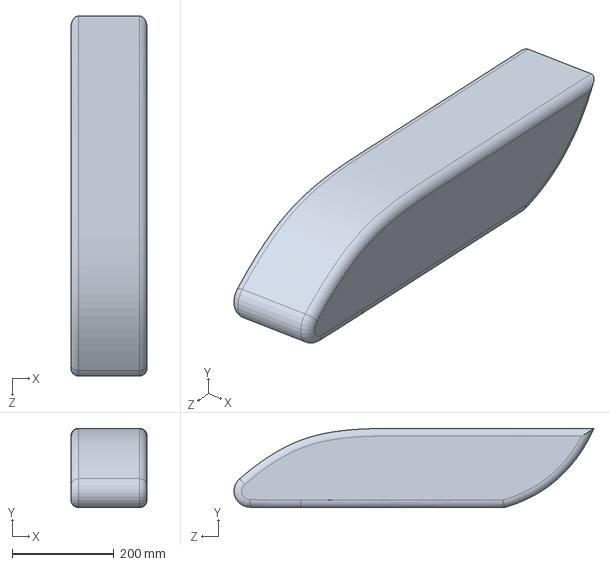
[picture p62: CAD file, 2022-02-02]
CAD/simulations/drag estimate.SLDPRT
150.0 x 156.0 x 708.9 mm
