haggis-aerospace/HaggisAero2021-22/CAD/STLFiles/Fork 3.STL

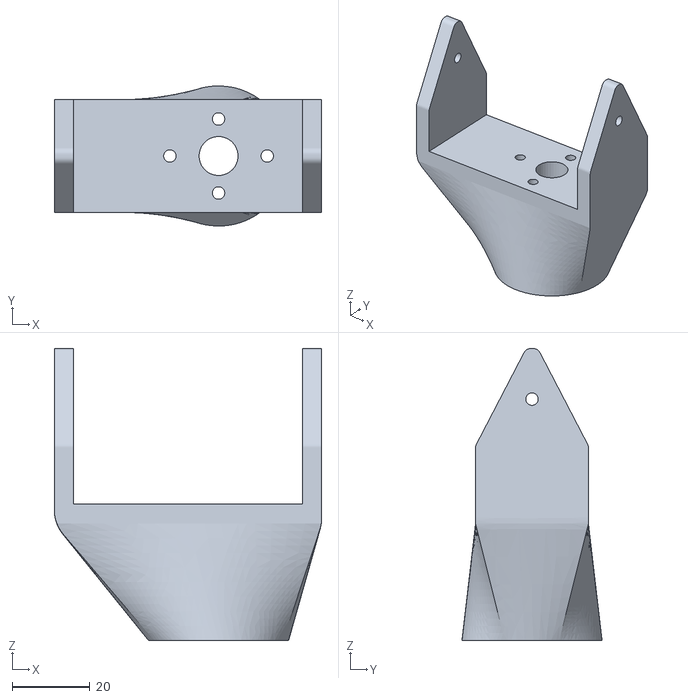
[picture p63: CAD file, 2022-04-07]
CAD/STLFiles/Fork 3.STL
68.7 x 36.0 x 75.0
