haggis-aerospace/HaggisAero2021-22/CAD/Wing/Small spar tail connector.SLDPRT

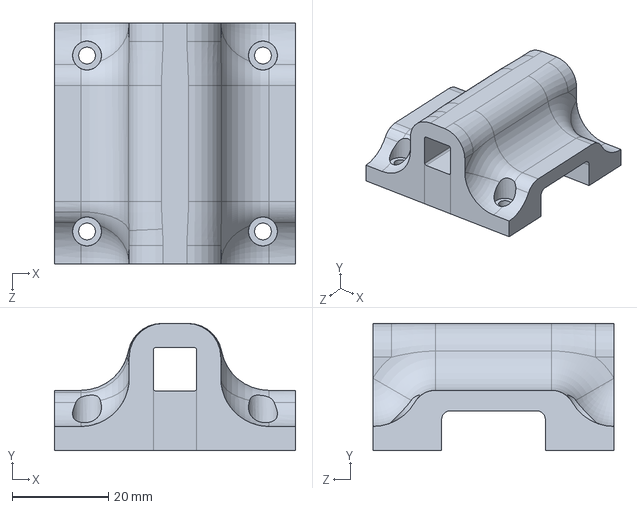
[picture p64: CAD file, 2022-06-21]
CAD/Wing/Small spar tail connector.SLDPRT
50.0 x 26.4 x 50.0 mm
