haggis-aerospace/HaggisAero2021-22/drone concept.SLDPRT

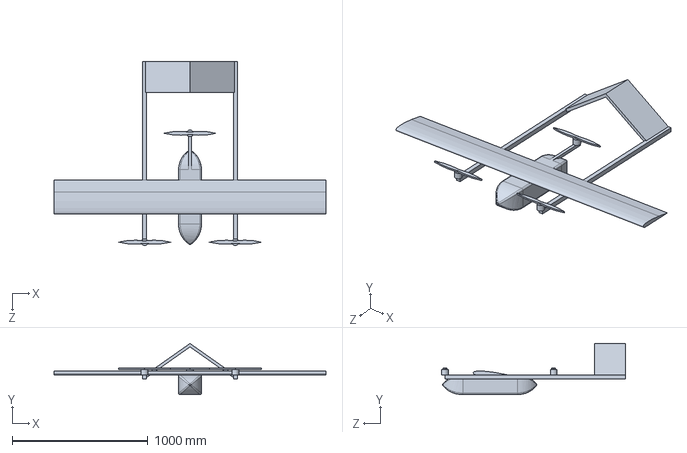
[picture p65: CAD file, 2022-02-02]
drone concept.SLDPRT
2000.0 x 375.6 x 1353.6 mm
