haggis-aerospace/HaggisAero2021-22/manufacturing/Endplates/Wing-Tip connector.SLDPRT

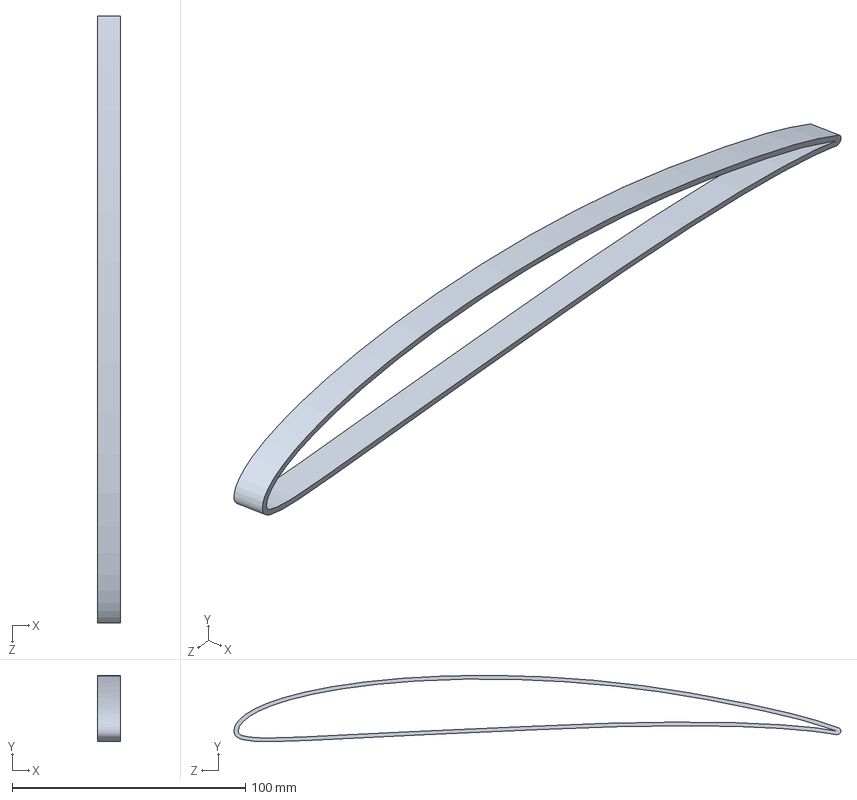
[picture p66: CAD file, 2022-06-19]
manufacturing/Endplates/Wing-Tip connector.SLDPRT
10.00 x 28.4 x 260.3 mm
