haggis-aerospace/HaggisAero2021-22/manufacturing/fuselage mold/fuselage Mould.SLDPRT

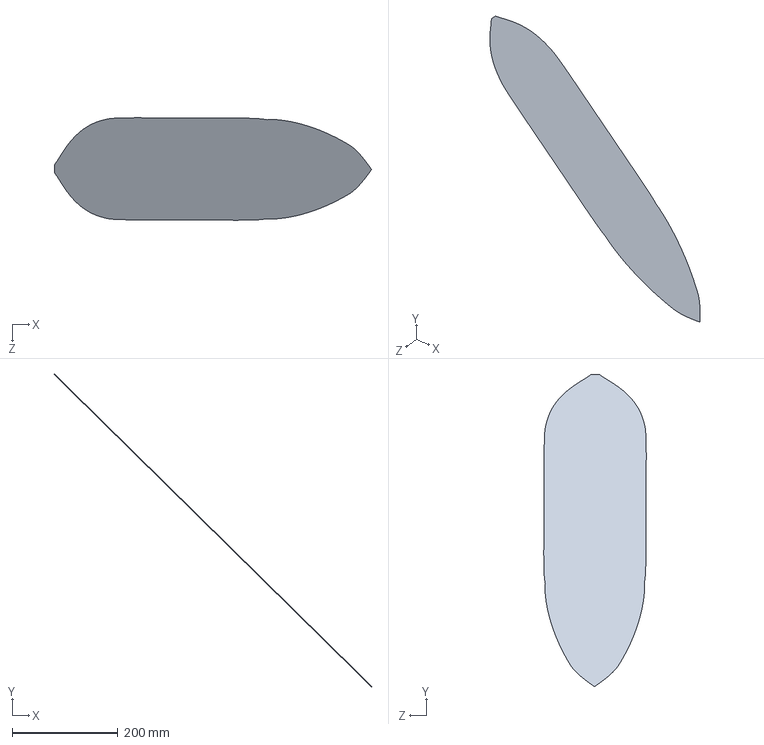
[picture p67: CAD file, 2022-06-14]
manufacturing/fuselage mold/fuselage Mould.SLDPRT
599.2 x 589.9 x 193.8 mm
