haggis-aerospace/HaggisAero2021-22/manufacturing/stl's for 3 print/rotaty mtr mount/rotaty base 2.SLDPRT

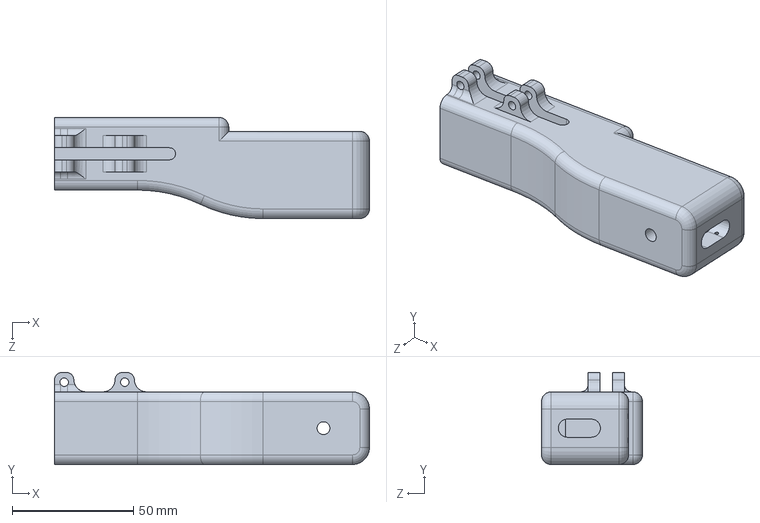
[picture p68: CAD file, 2022-06-10]
manufacturing/stl's for 3 print/rotaty mtr mount/rotaty base 2.SLDPRT
130.1 x 38.0 x 41.8 mm
