haggis-aerospace/HaggisAero2021-22/manufacturing/stl's for 3 print/static mtr mount/base.STL

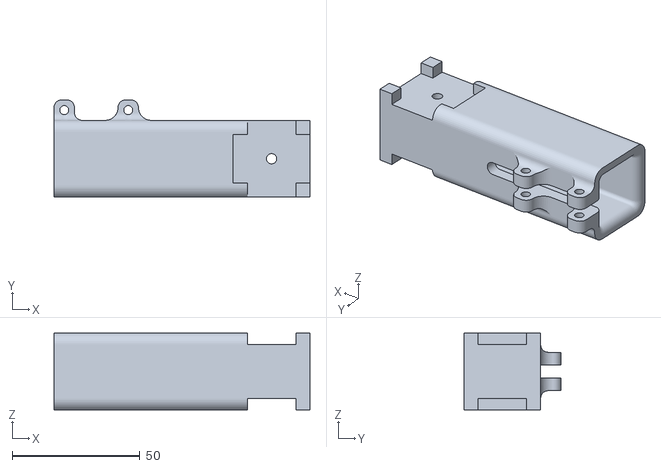
[picture p69: CAD file, 2022-06-07]
manufacturing/stl's for 3 print/static mtr mount/base.STL
100.0 x 38.0 x 30.0
