haggis-aerospace/HaggisAero2021-22/manufacturing/stl's for 3 print/Wing plates.3mf

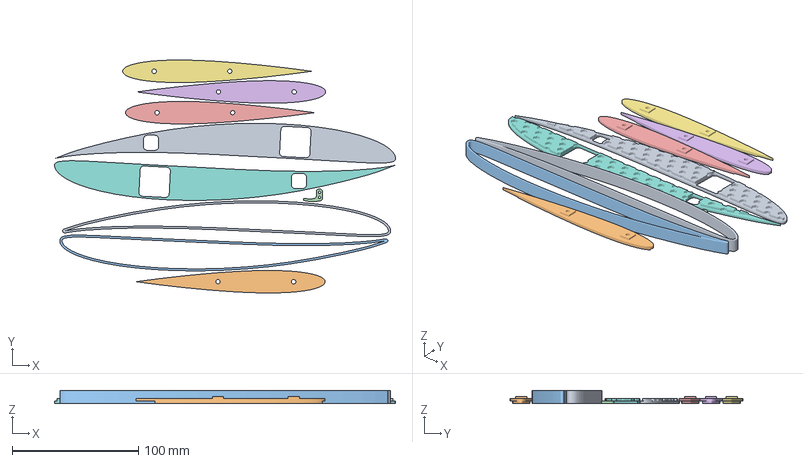
[picture p70: CAD file, 2022-06-20]
manufacturing/stl's for 3 print/Wing plates.3mf
270.5 x 184.8 x 10.00 mm
Main Wing Endplate.STL
Tail wing endplate.STL
Wing-Tip connector.STL
release mech hook.STL
Tail wing endplate.STL(1)
Tail wing endplate.STL(2)
Tail wing endplate.STL(3)
Main Wing Endplate.STL(1)
Wing-Tip connector.STL(1)
