haggis-aerospace/HaggisAero2021-22/manufacturing/stl's for 3 print/wing-tail connector/tail wing conector top.STL

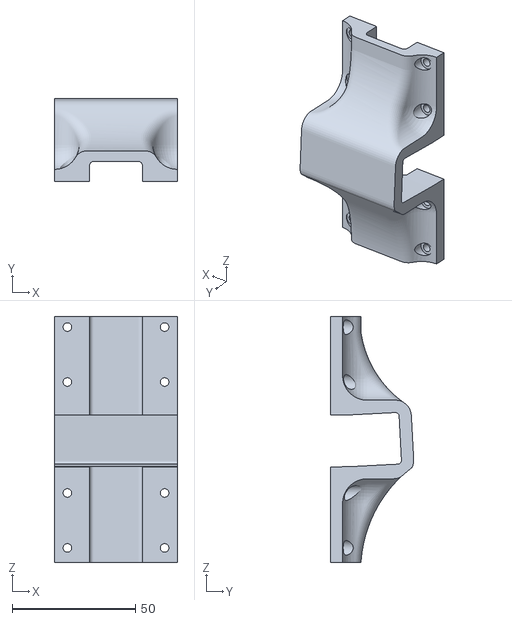
[picture p71: CAD file, 2022-06-14]
manufacturing/stl's for 3 print/wing-tail connector/tail wing conector top.STL
50.0 x 33.9 x 100.0
