haggis-aerospace/HaggisAero2021-22/Tail/tail spar.SLDPRT

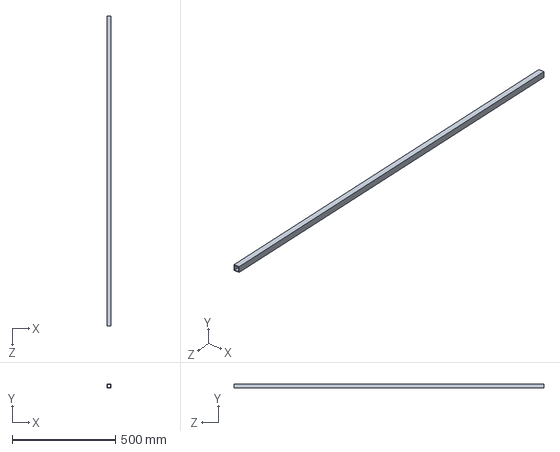
[picture p72: CAD file, 2023-02-27]
Tail/tail spar.SLDPRT
20.0 x 20.0 x 1500.0 mm
