haggis-aerospace/HaggisAero2021-22/CAD/Electronics/battery 2s 4p llooong.SLDPRT

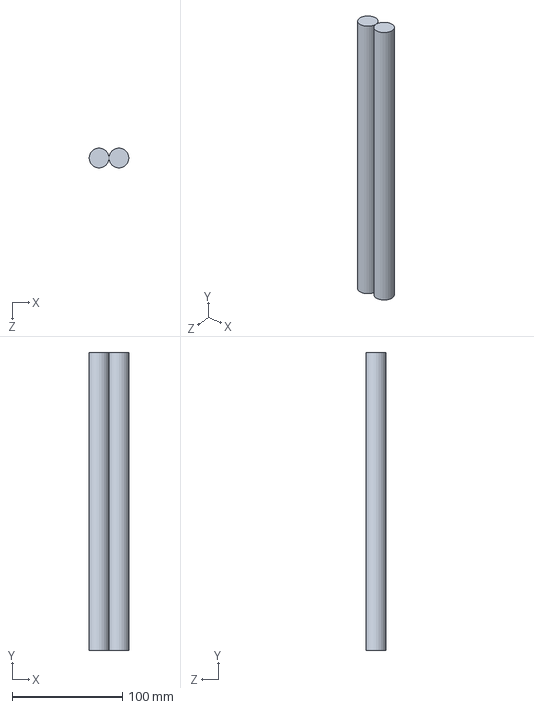
[picture p73: CAD file, 2022-04-07]
CAD/Electronics/battery 2s 4p llooong.SLDPRT
36.0 x 270.0 x 18.0 mm
