haggis-aerospace/HaggisAero2021-22/CAD/Motor mount/motor plate.SLDPRT

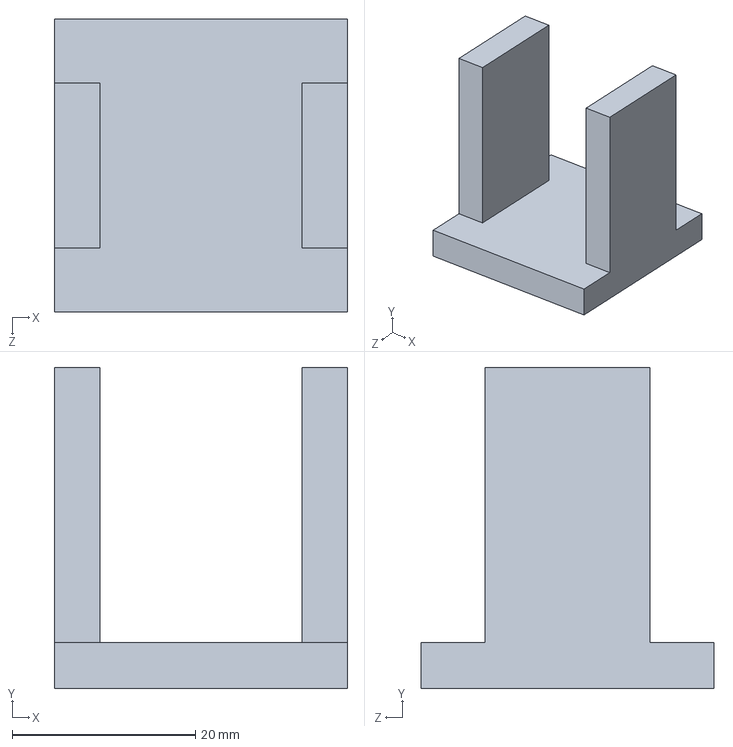
[picture p74: CAD file, 2022-06-10]
CAD/Motor mount/motor plate.SLDPRT
32.0 x 35.0 x 32.0 mm
