haggis-aerospace/HaggisAero2021-22/CAD/Motor rotator/Mock Prop.SLDPRT

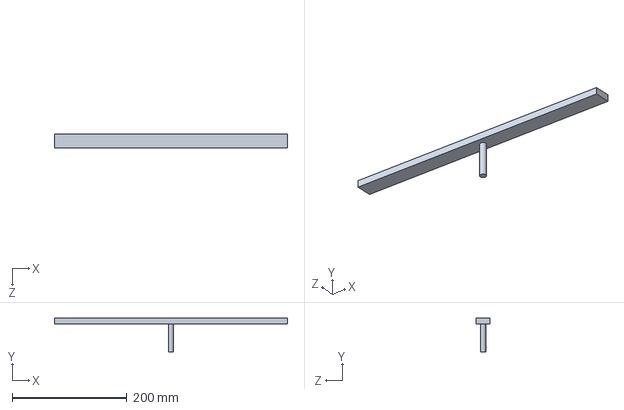
[picture p75: CAD file, 2022-03-11]
CAD/Motor rotator/Mock Prop.SLDPRT
406.4 x 59.0 x 25.0 mm
