haggis-aerospace/HaggisAero2021-22/manufacturing/fuselage mold/rear left 4of4.SLDPRT

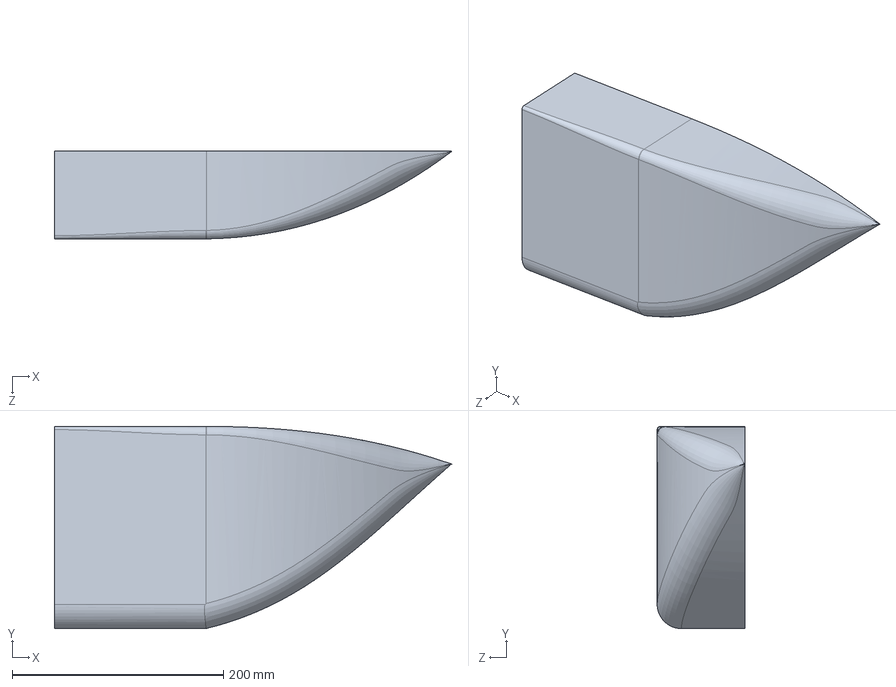
[picture p76: CAD file, 2022-02-09]
manufacturing/fuselage mold/rear left 4of4.SLDPRT
375.7 x 191.3 x 83.0 mm
