haggis-aerospace/HaggisAero2021-22/manufacturing/stl's for 3 print/release mech hook.STL

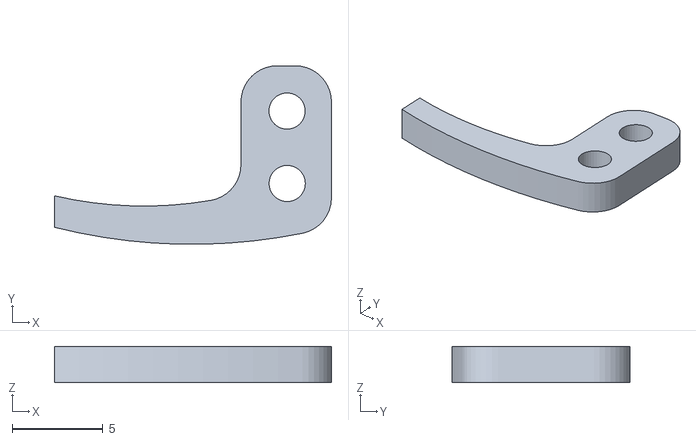
[picture p77: CAD file, 2022-06-20]
manufacturing/stl's for 3 print/release mech hook.STL
15.3 x 9.85 x 2.00
