haggis-aerospace/HaggisAero2021-22/manufacturing/stl's for 3 print/rotaty mtr mount/motor plate.STL

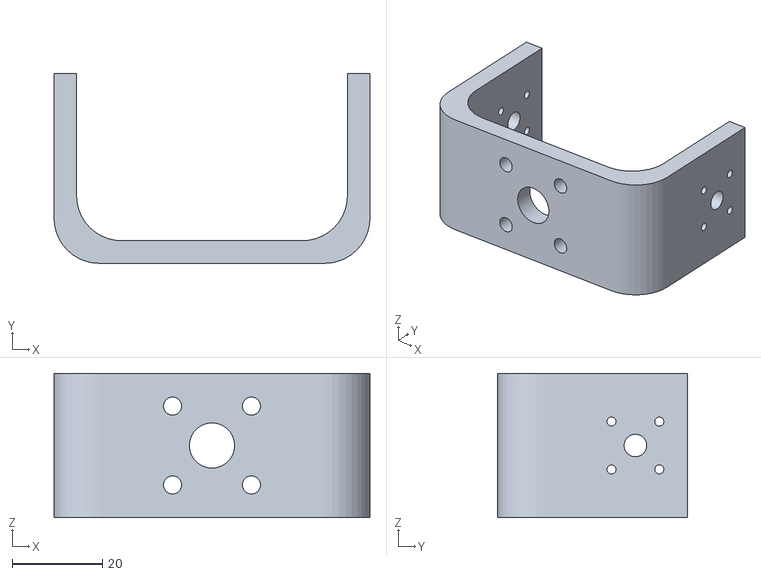
[picture p78: CAD file, 2022-06-10]
manufacturing/stl's for 3 print/rotaty mtr mount/motor plate.STL
70.0 x 42.0 x 32.0
