haggis-aerospace/HaggisAero2021-22/manufacturing/stl's for 3 print/static mtr mount/motor plate.STL

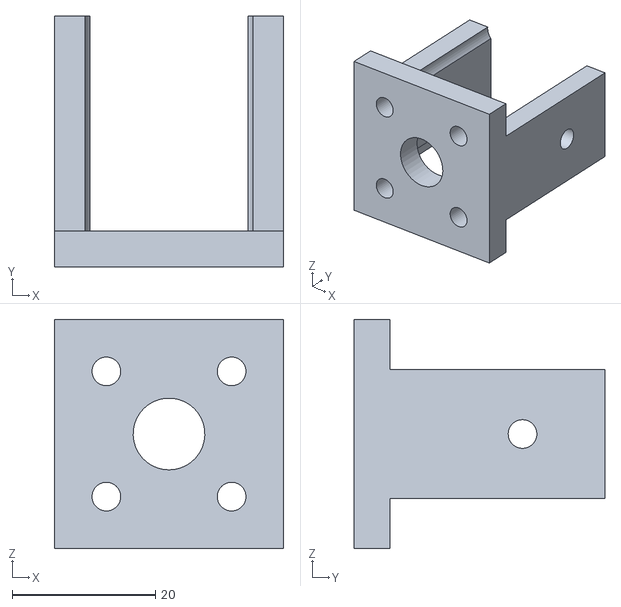
[picture p79: CAD file, 2022-06-06]
manufacturing/stl's for 3 print/static mtr mount/motor plate.STL
32.0 x 35.0 x 32.0
