haggis-aerospace/HaggisAero2021-22/manufacturing/stl's for 3 print/wing-tail connector/tail-wing connector bottom.STL

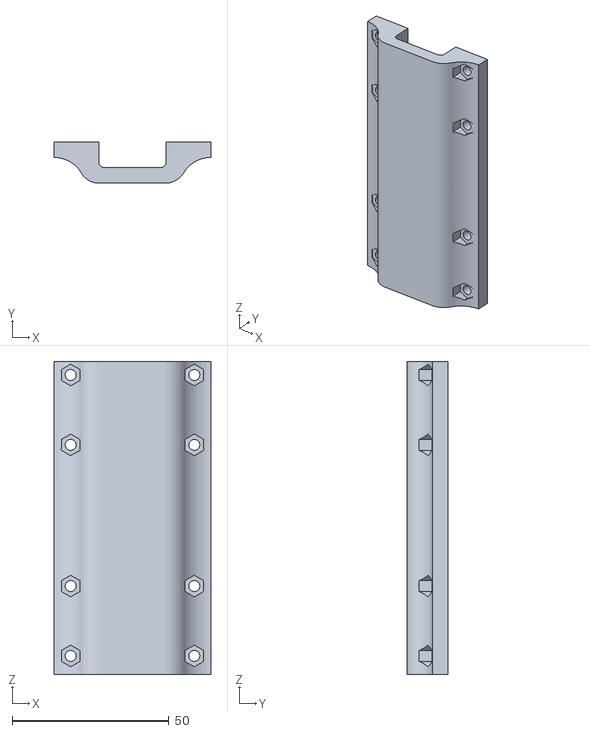
[picture p80: CAD file, 2022-06-14]
manufacturing/stl's for 3 print/wing-tail connector/tail-wing connector bottom.STL
50.0 x 13.2 x 100.0
