haggis-aerospace/HaggisAero2021-22/CAD/Fuselage_Payload/PParachute.SLDPRT

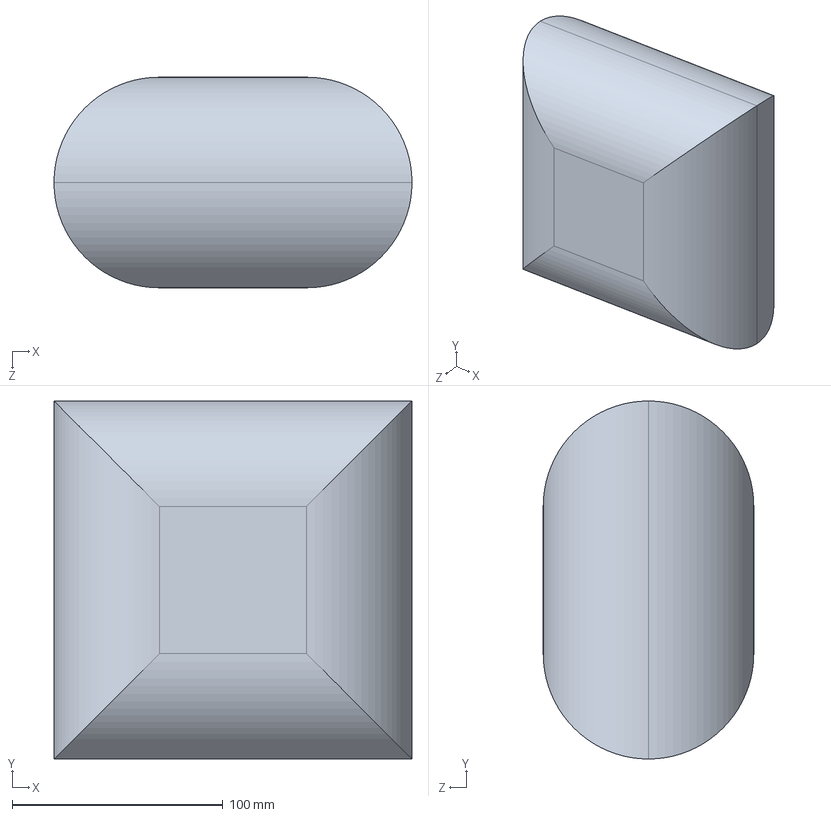
[picture p81: CAD file, 2022-02-02]
CAD/Fuselage_Payload/PParachute.SLDPRT
170.0 x 170.0 x 100.0 mm
