haggis-aerospace/HaggisAero2021-22/CAD/landing gear/v2 u bracket.SLDPRT

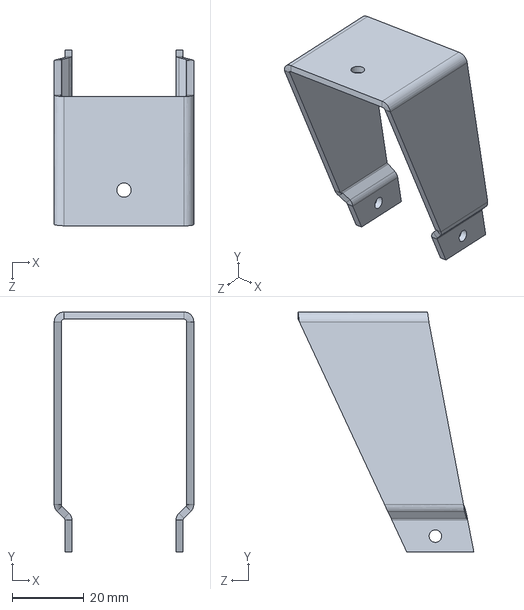
[picture p82: CAD file, 2022-06-29]
CAD/landing gear/v2 u bracket.SLDPRT
39.0 x 67.0 x 49.1 mm
