haggis-aerospace/HaggisAero2021-22/CAD/Motor rotator/Rotator Base.SLDPRT

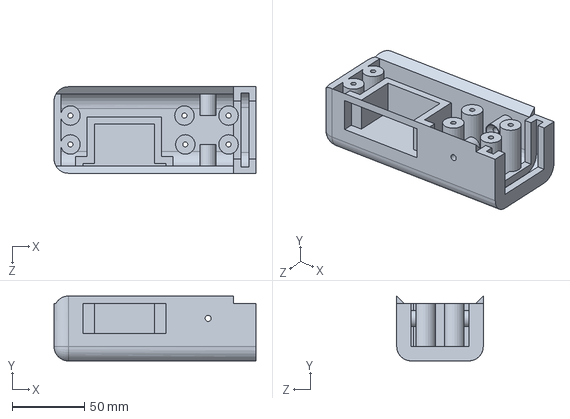
[picture p83: CAD file, 2022-03-11]
CAD/Motor rotator/Rotator Base.SLDPRT
140.0 x 45.0 x 60.0 mm
