haggis-aerospace/HaggisAero2021-22/CAD/STLFiles/Tail_Top_Piece_V2.STL

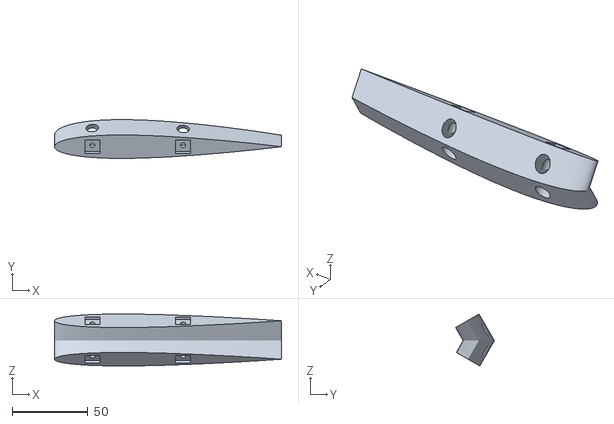
[picture p84: CAD file, 2022-04-07]
CAD/STLFiles/Tail_Top_Piece_V2.STL
150.0 x 25.6 x 34.3
