haggis-aerospace/HaggisAero2021-22/CAD/Tail/small spar tail-wing connector insert upper.SLDPRT

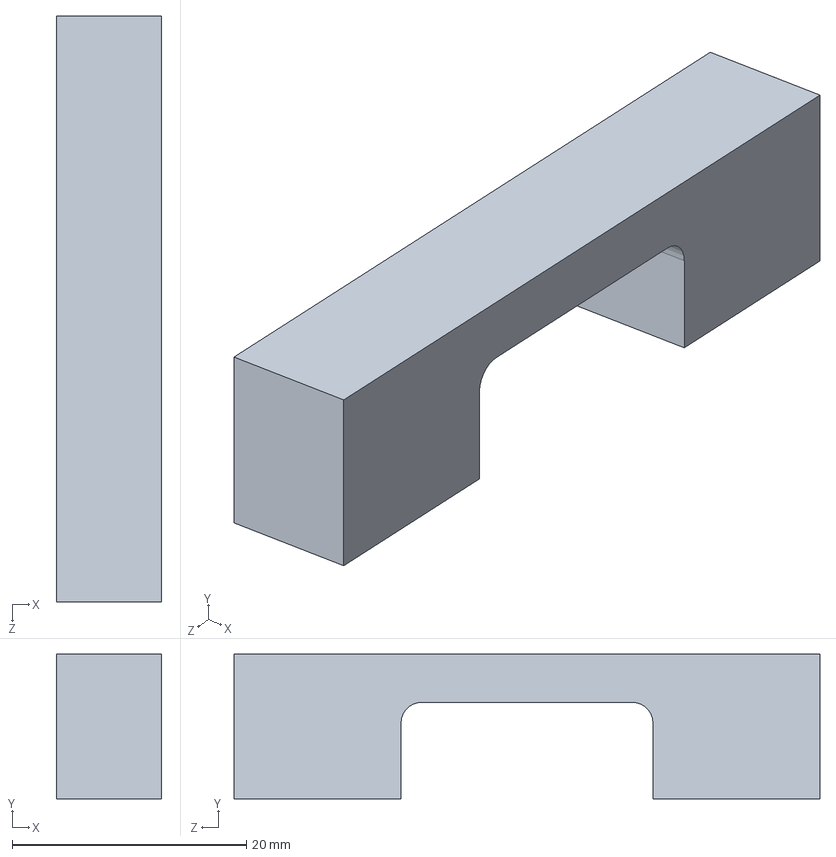
[picture p85: CAD file, 2022-06-21]
CAD/Tail/small spar tail-wing connector insert upper.SLDPRT
9.00 x 12.4 x 50.0 mm
