haggis-aerospace/HaggisAero2021-22/manufacturing/Endplates/Tail wing endplate.SLDPRT

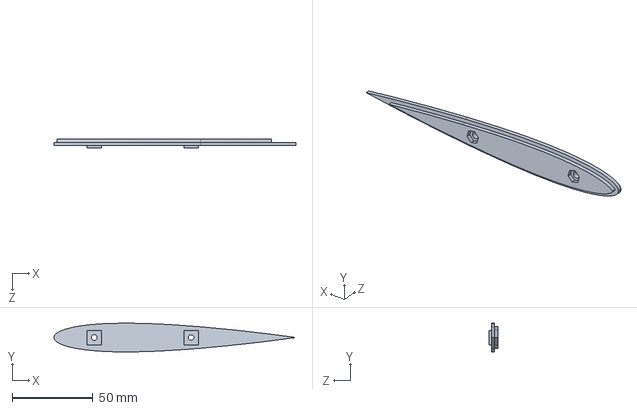
[picture p86: CAD file, 2022-06-18]
manufacturing/Endplates/Tail wing endplate.SLDPRT
150.0 x 17.9 x 5.50 mm
