haggis-aerospace/HaggisAero2021-22/CAD/Electronics/VGA.SLDPRT

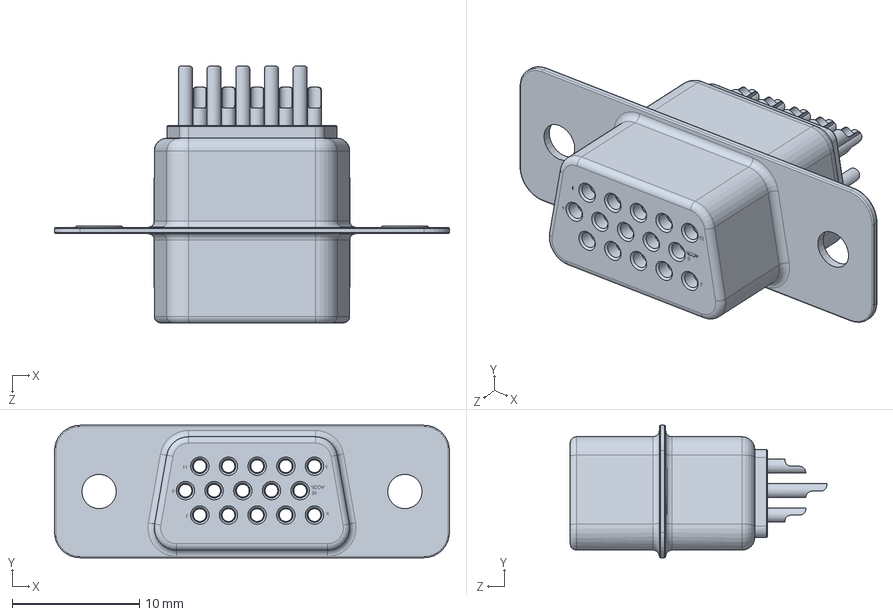
[picture p87: CAD file, 2022-03-15]
CAD/Electronics/VGA.SLDPRT
31.0 x 10.4 x 20.1 mm
