haggis-aerospace/HaggisAero2021-22/CAD/Fuselage_Payload/fuselage - Copy.SLDPRT

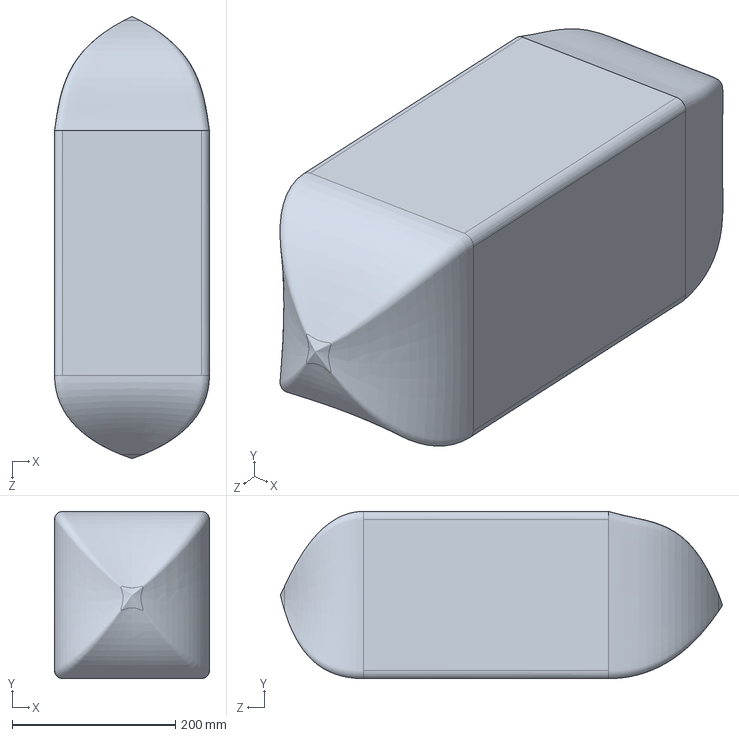
[picture p88: CAD file, 2021-11-09]
CAD/Fuselage_Payload/fuselage - Copy.SLDPRT
190.0 x 205.0 x 542.0 mm
