haggis-aerospace/HaggisAero2021-22/CAD/landing gear/thick cf tube.SLDPRT

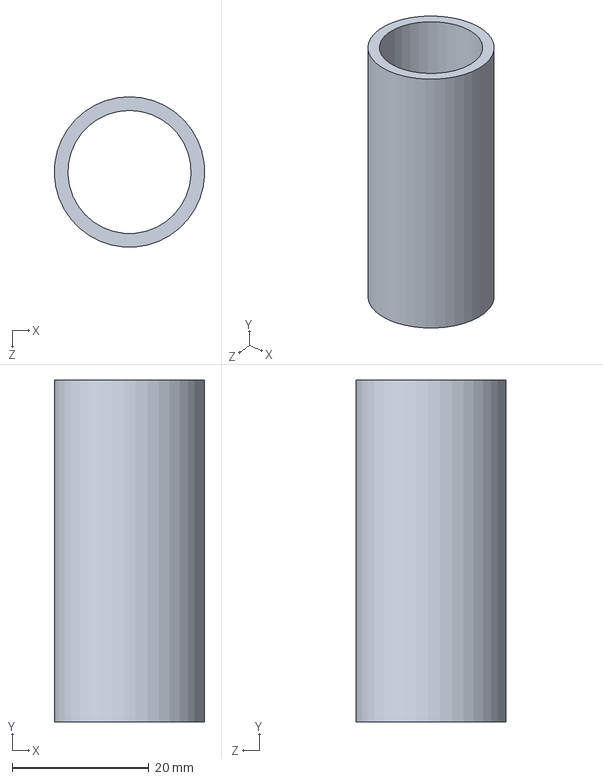
[picture p89: CAD file, 2022-06-29]
CAD/landing gear/thick cf tube.SLDPRT
22.0 x 50.0 x 22.0 mm
