haggis-aerospace/HaggisAero2021-22/CAD/Motor rotator/Rotator Lid.SLDPRT

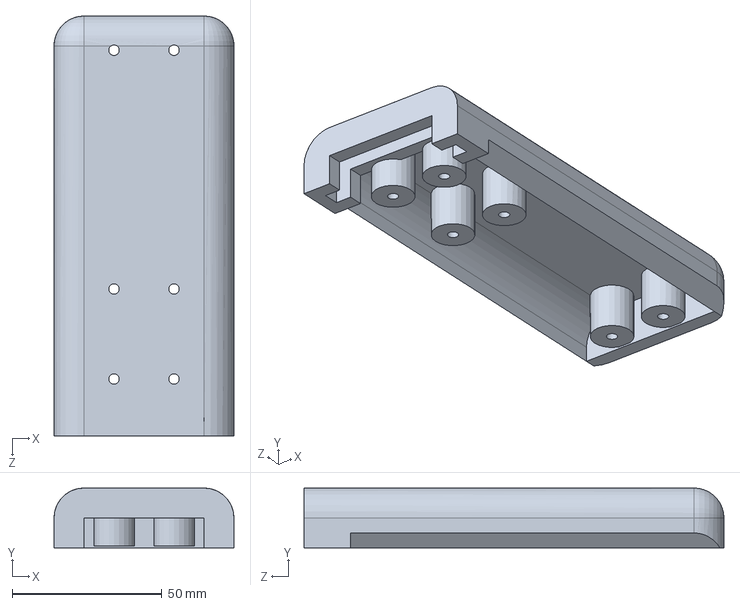
[picture p90: CAD file, 2022-03-11]
CAD/Motor rotator/Rotator Lid.SLDPRT
60.0 x 20.0 x 140.0 mm
