haggis-aerospace/HaggisAero2021-22/CAD/STLFiles/spur gear_iso.STL

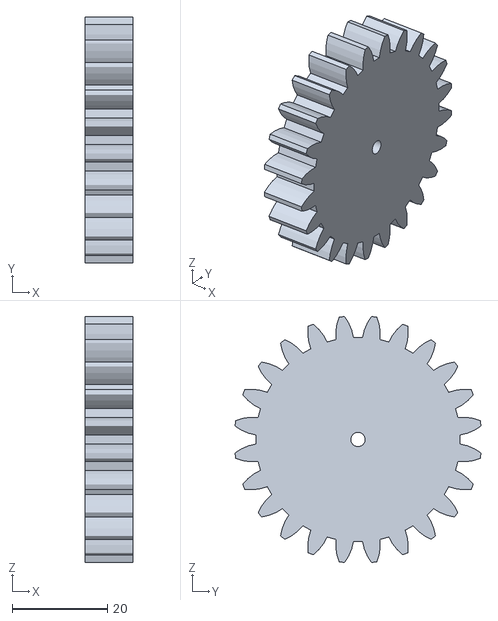
[picture p91: CAD file, 2022-04-07]
CAD/STLFiles/spur gear_iso.STL
10.0 x 51.7 x 51.7
