haggis-aerospace/HaggisAero2021-22/CAD/Tail/small spar tail-wing connector lower.SLDPRT

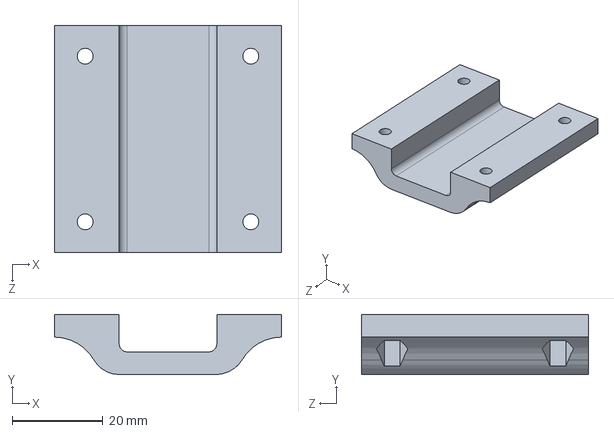
[picture p92: CAD file, 2022-06-21]
CAD/Tail/small spar tail-wing connector lower.SLDPRT
50.0 x 13.2 x 50.0 mm
