haggis-aerospace/HaggisAero2021-22/CAD/Electronics/Transmitter Antenna.SLDPRT

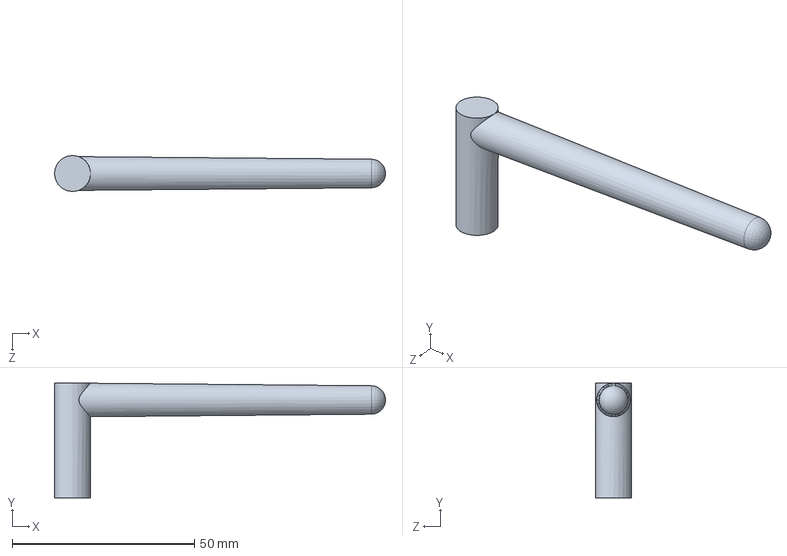
[picture p93: CAD file, 2022-03-15]
CAD/Electronics/Transmitter Antenna.SLDPRT
90.8 x 31.6 x 9.90 mm
