haggis-aerospace/HaggisAero2021-22/CAD/Fuselage/3dp parts/Tail plus Secondary spar midle holder.SLDPRT

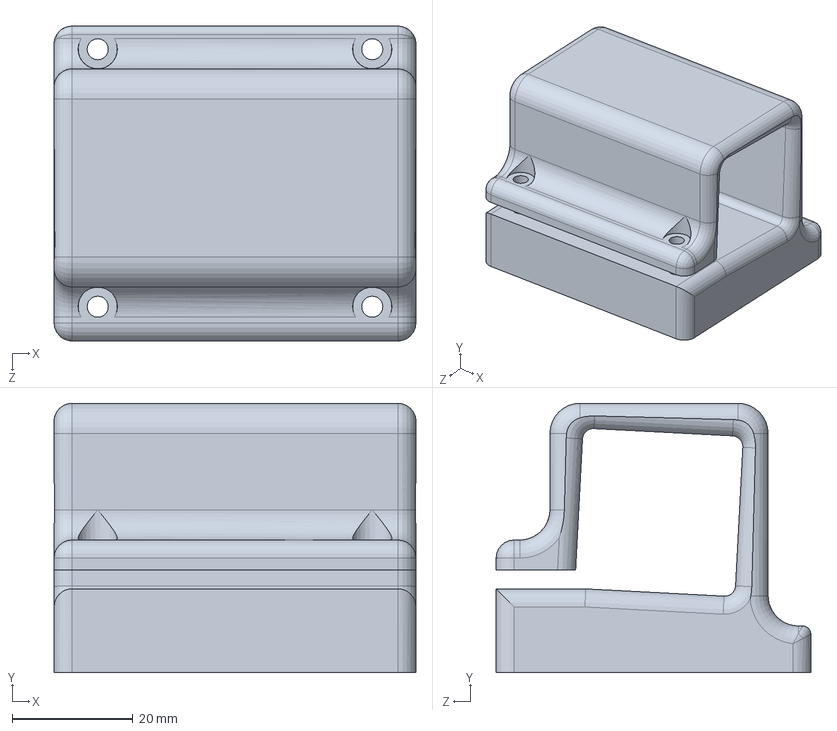
[picture p94: CAD file, 2022-03-09]
CAD/Fuselage/3dp parts/Tail plus Secondary spar midle holder.SLDPRT
60.0 x 44.7 x 52.2 mm
