haggis-aerospace/HaggisAero2021-22/CAD/Fuselage/Tail motor spar.SLDPRT

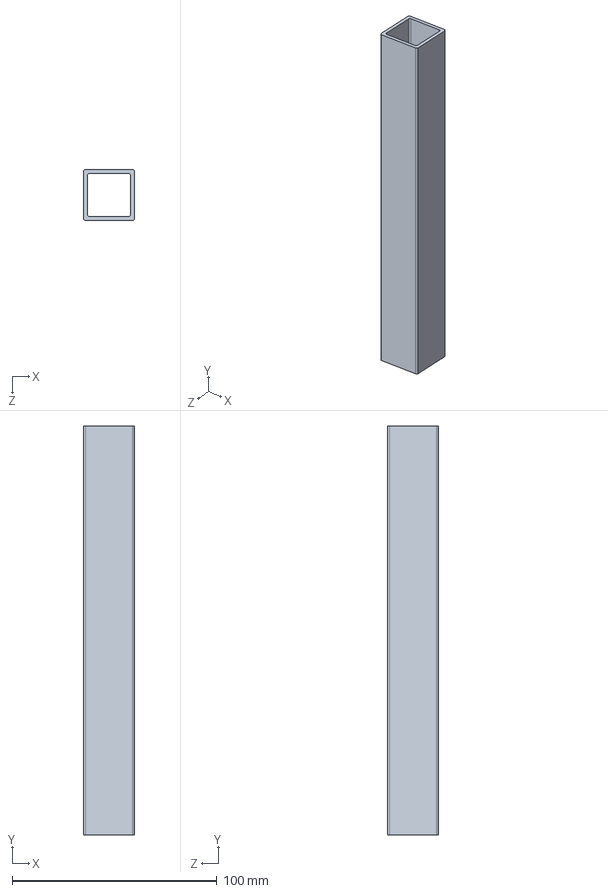
[picture p95: CAD file, 2022-03-15]
CAD/Fuselage/Tail motor spar.SLDPRT
25.0 x 200.0 x 25.0 mm
