haggis-aerospace/HaggisAero2021-22/CAD/Motor rotator 2/Rotator bottom.SLDPRT

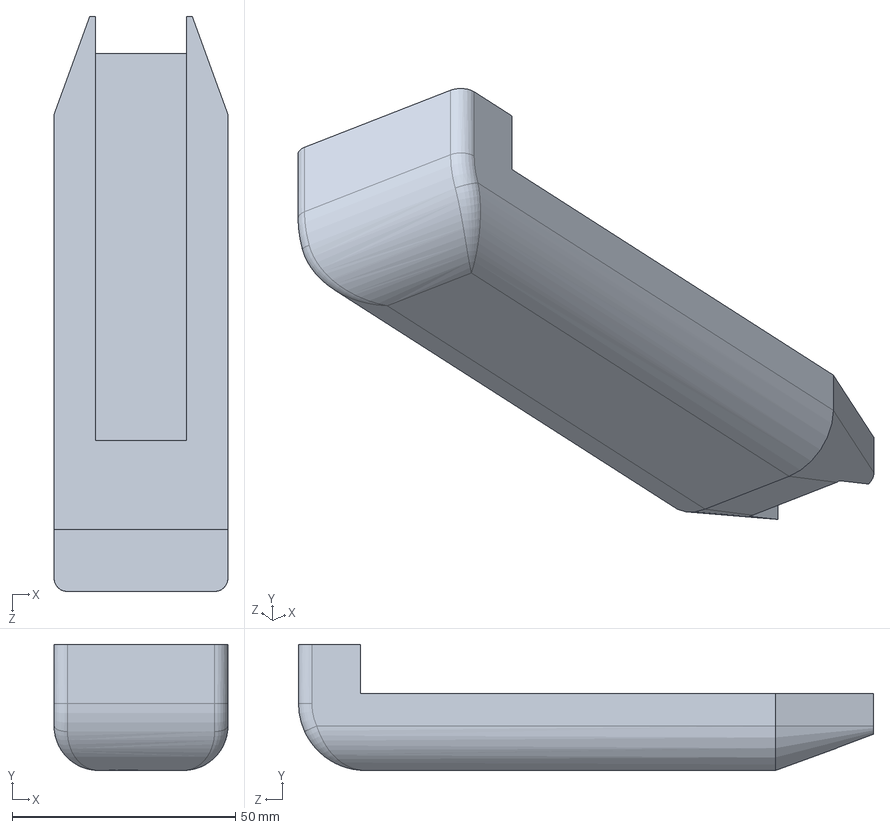
[picture p96: CAD file, 2022-04-14]
CAD/Motor rotator 2/Rotator bottom.SLDPRT
39.0 x 28.2 x 128.9 mm
