haggis-aerospace/HaggisAero2021-22/CAD/Motor rotator/Fork.SLDPRT

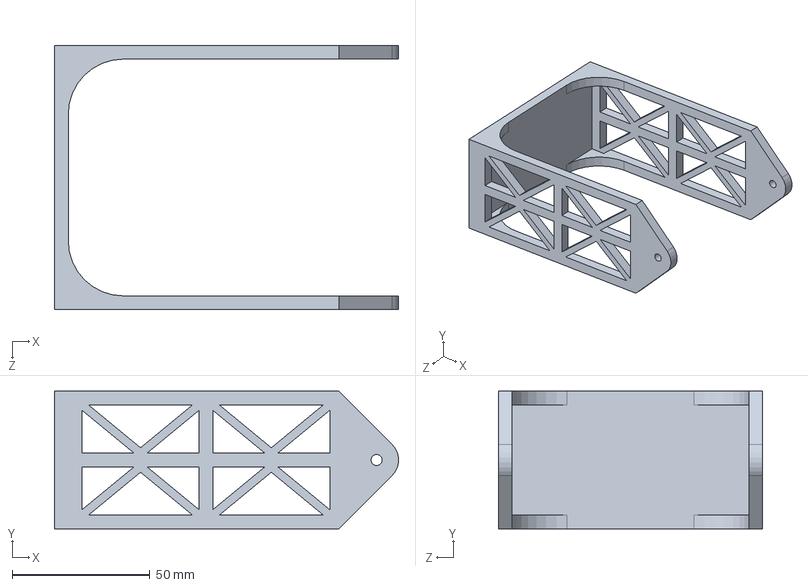
[picture p97: CAD file, 2022-03-11]
CAD/Motor rotator/Fork.SLDPRT
124.9 x 50.0 x 96.0 mm
