haggis-aerospace/HaggisAero2021-22/CAD/Tail/small spar tail-wing connector upper.SLDPRT

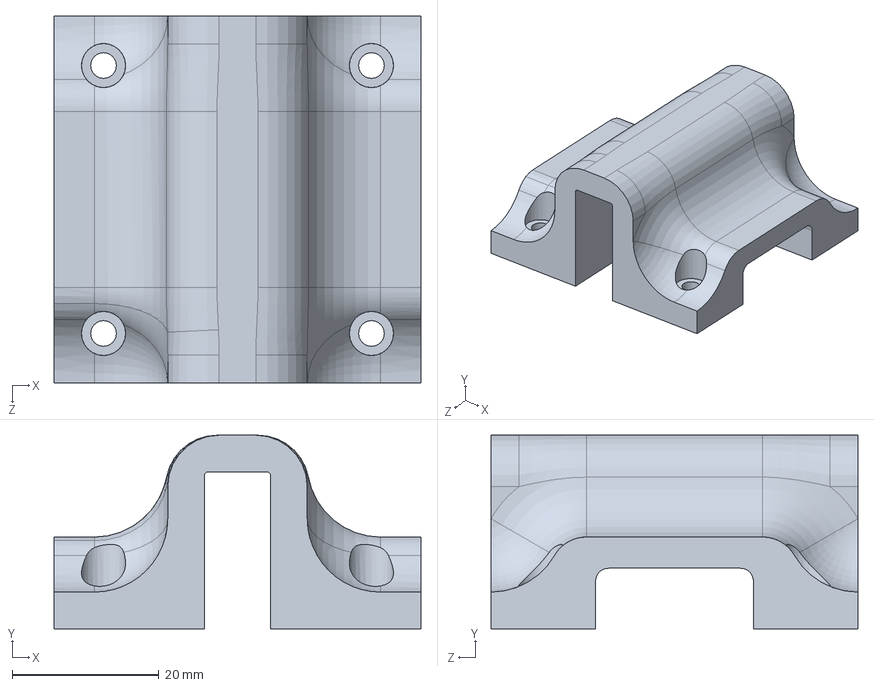
[picture p98: CAD file, 2022-06-21]
CAD/Tail/small spar tail-wing connector upper.SLDPRT
50.0 x 26.4 x 50.0 mm
