haggis-aerospace/HaggisAero2021-22/manufacturing/Endplates/UMS5_Wing face plate.3mf

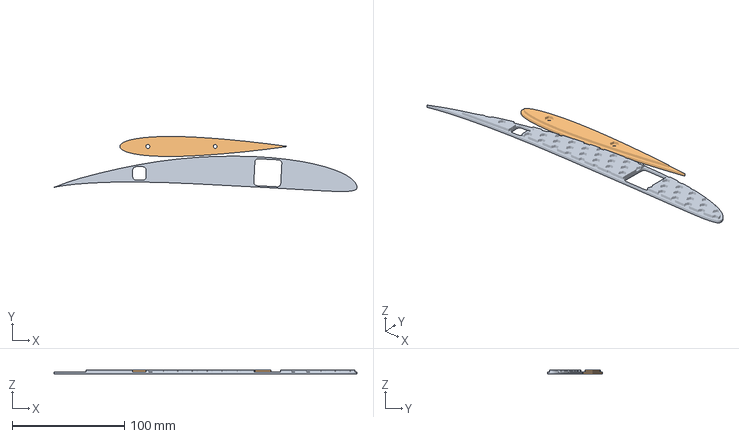
[picture p99: CAD file, 2022-06-18]
manufacturing/Endplates/UMS5_Wing face plate.3mf
270.0 x 49.1 x 4.00 mm
Part1^Masterr assembly.STL
Tail wing endplate.STL
