haggis-aerospace/HaggisAero2021-22/manufacturing/fuselage mold/Mould die.SLDPRT

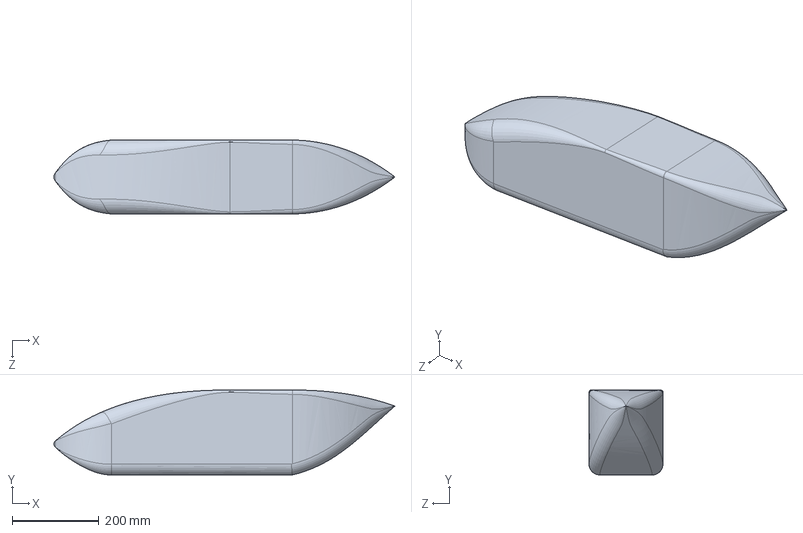
[picture p100: CAD file, 2022-02-09]
manufacturing/fuselage mold/Mould die.SLDPRT
783.9 x 195.3 x 170.0 mm
