haggis-aerospace/HaggisAero2021-22/CAD/Electronics/XT60E-M.SLDPRT

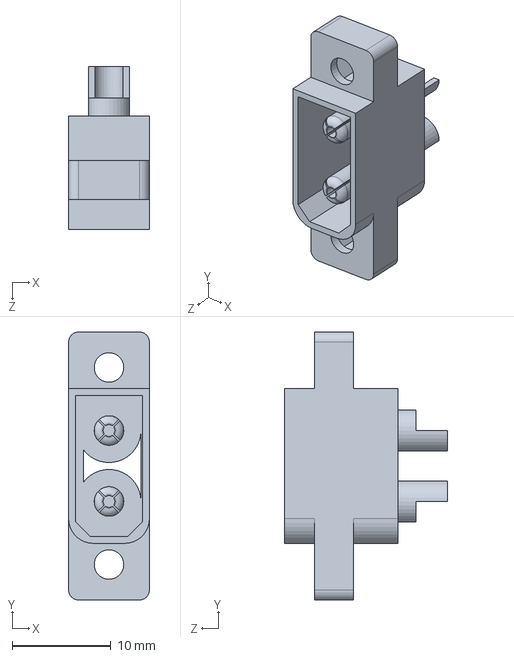
[picture p101: CAD file, 2022-03-15]
CAD/Electronics/XT60E-M.SLDPRT
8.20 x 27.2 x 16.5 mm
