haggis-aerospace/HaggisAero2021-22/CAD/landing gear/rear gear base.SLDPRT

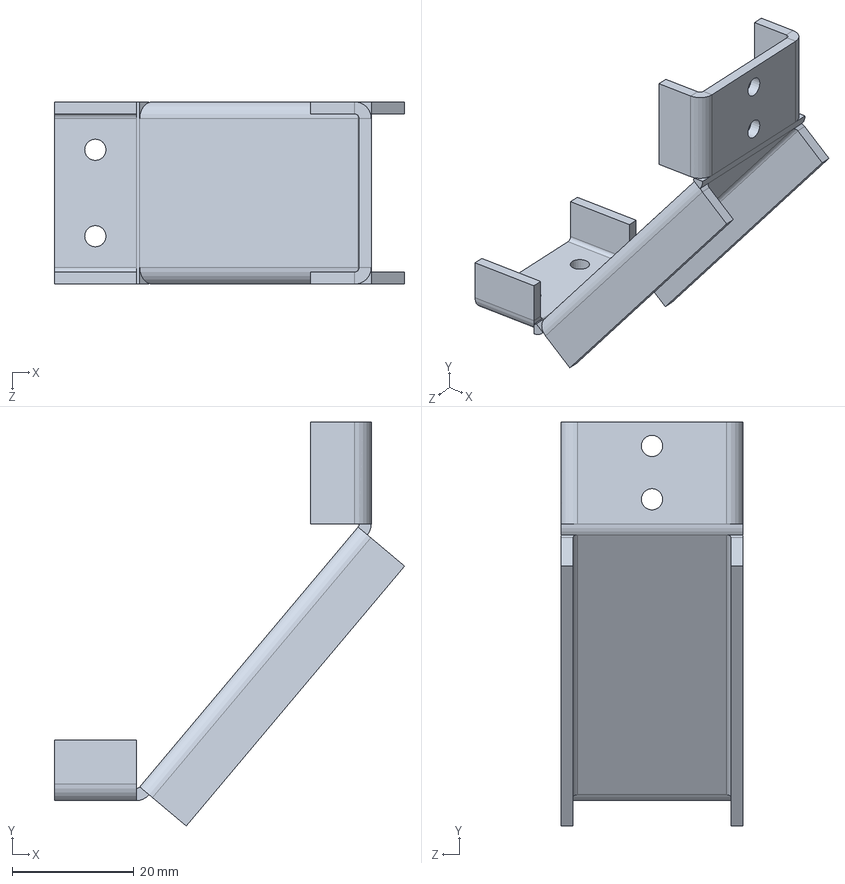
[picture p102: CAD file, 2022-06-29]
CAD/landing gear/rear gear base.SLDPRT
57.6 x 66.5 x 30.0 mm
