haggis-aerospace/HaggisAero2021-22/CAD/STLFiles/secondary spar side holder.STL

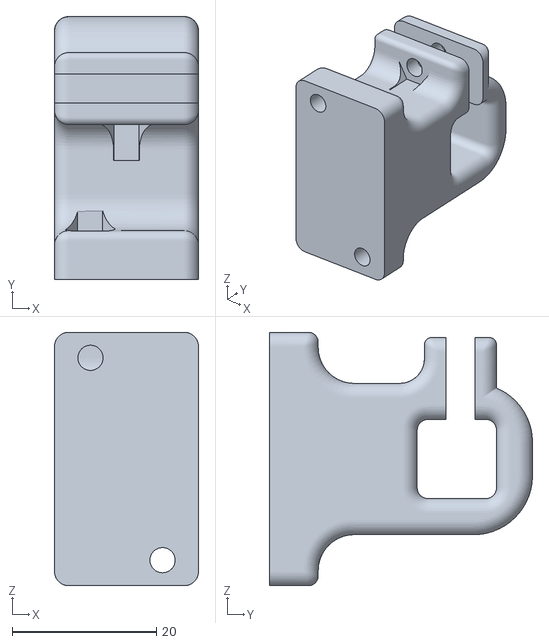
[picture p103: CAD file, 2022-04-07]
CAD/STLFiles/secondary spar side holder.STL
20.0 x 36.5 x 35.2
