haggis-aerospace/HaggisAero2021-22/manufacturing/fuselage mold/front right 2of4.SLDPRT

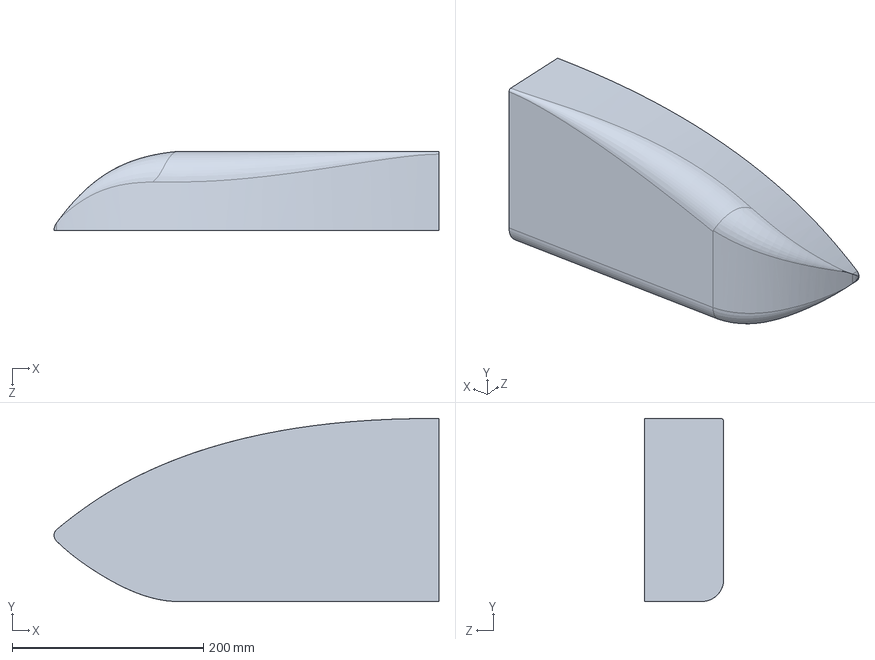
[picture p104: CAD file, 2022-02-09]
manufacturing/fuselage mold/front right 2of4.SLDPRT
402.4 x 191.3 x 83.0 mm
