haggis-aerospace/HaggisAero2021-22/manufacturing/Wing/FAT back stencil.SLDPRT

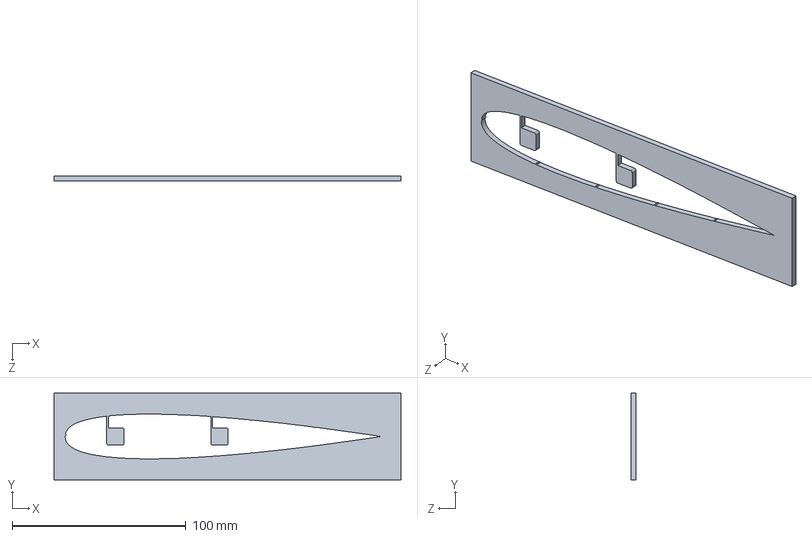
[picture p105: CAD file, 2022-06-06]
manufacturing/Wing/FAT back stencil.SLDPRT
200.0 x 50.0 x 3.00 mm
