haggis-aerospace/HaggisAero2021-22/CAD/Electronics/rasbery pi/Enclosure Top .sldprt

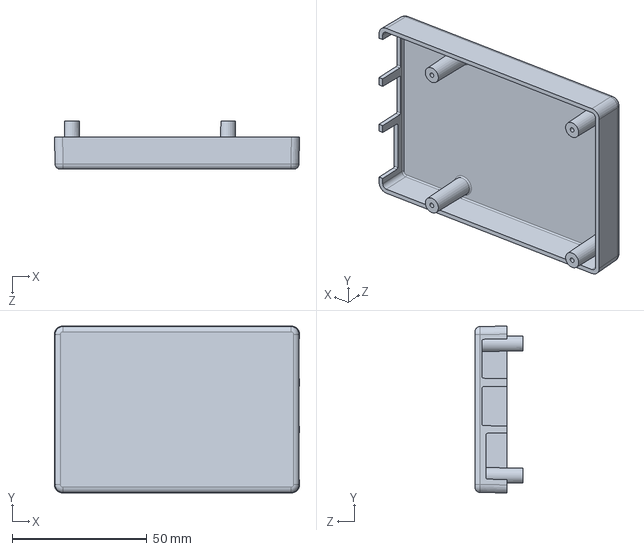
[picture p106: CAD file, 2022-02-02]
CAD/Electronics/rasbery pi/Enclosure Top .sldprt
91.0 x 62.0 x 18.0 mm
