haggis-aerospace/HaggisAero2021-22/CAD/Electronics/release mech hook.SLDPRT

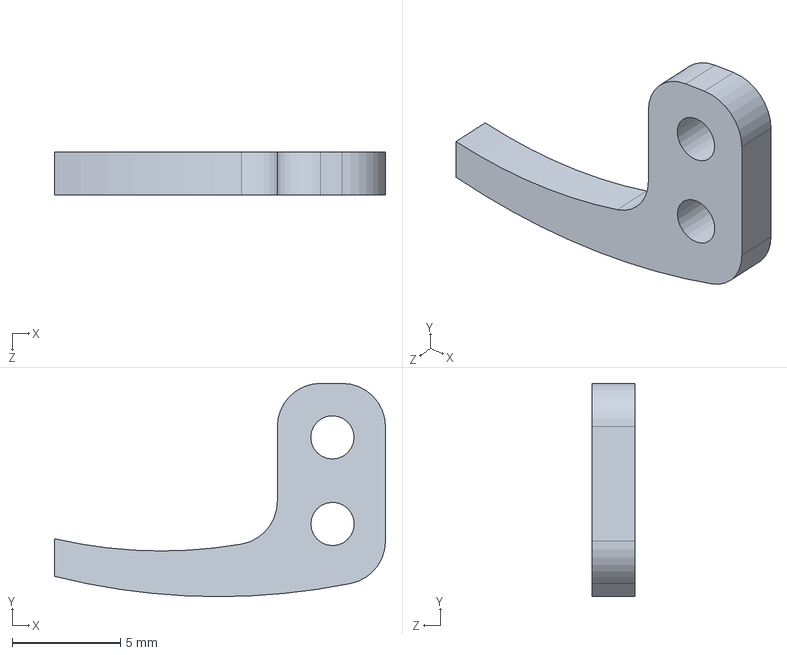
[picture p107: CAD file, 2022-02-02]
CAD/Electronics/release mech hook.SLDPRT
15.3 x 9.85 x 2.00 mm
