haggis-aerospace/HaggisAero2021-22/CAD/Fuselage/fuselage shell.SLDPRT

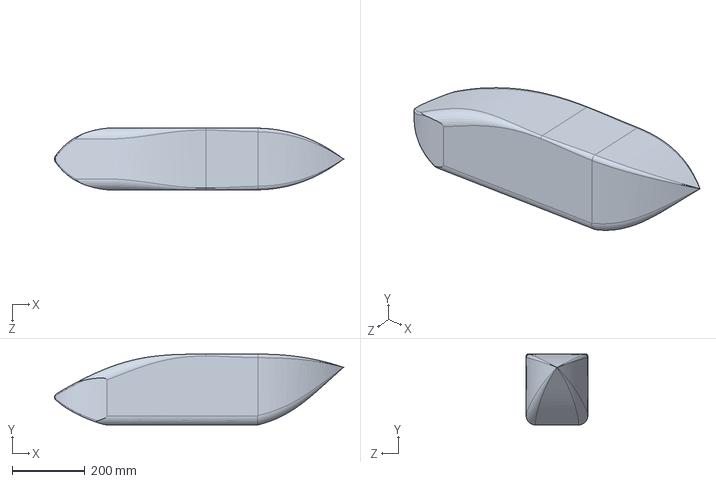
[picture p108: CAD file, 2022-03-15]
CAD/Fuselage/fuselage shell.SLDPRT
796.8 x 195.3 x 170.0 mm
