haggis-aerospace/HaggisAero2021-22/CAD/landing gear/rear U bracket.SLDPRT

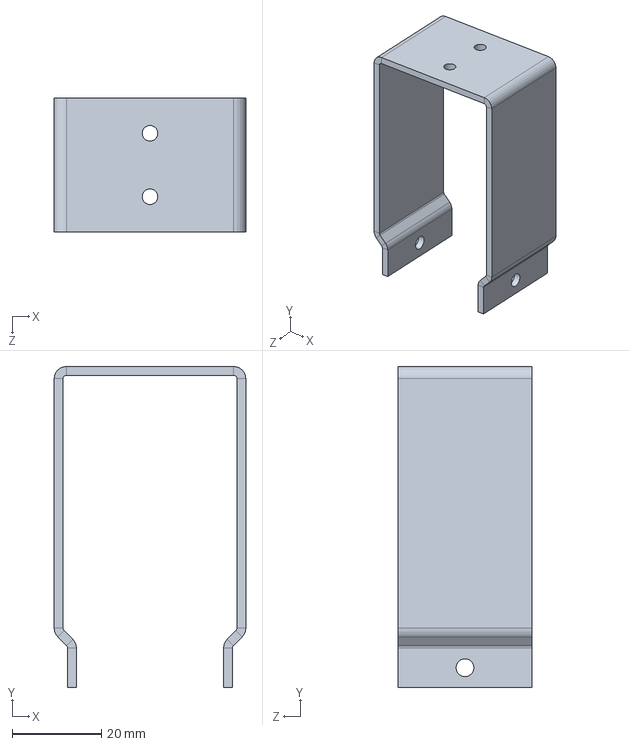
[picture p109: CAD file, 2022-06-29]
CAD/landing gear/rear U bracket.SLDPRT
43.0 x 72.0 x 30.0 mm
