haggis-aerospace/HaggisAero2021-22/CAD/Electronics/Pixhawk2.1 CUBE with Edison carrier.SLDPRT

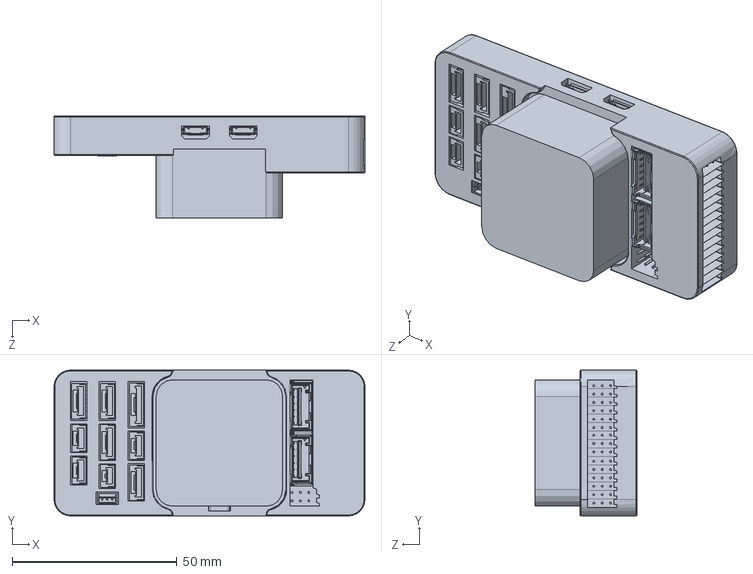
[picture p110: CAD file, 2022-02-02]
CAD/Electronics/Pixhawk2.1 CUBE with Edison carrier.SLDPRT
94.2 x 44.2 x 30.9 mm
