haggis-aerospace/HaggisAero2021-22/CAD/Fuselage/reference latch.SLDPRT

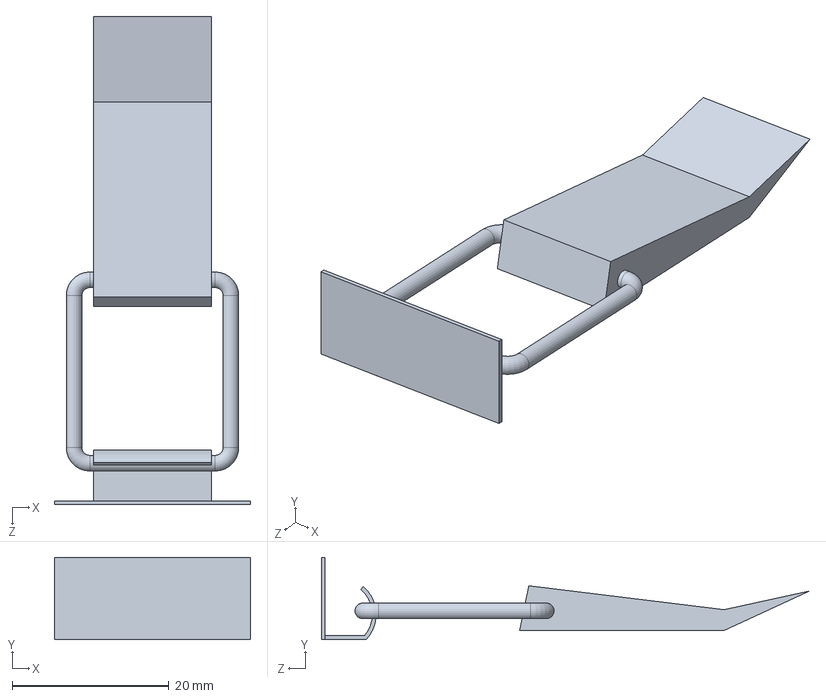
[picture p111: CAD file, 2022-03-15]
CAD/Fuselage/reference latch.SLDPRT
25.0 x 10.5 x 62.3 mm
