haggis-aerospace/HaggisAero2021-22/CAD/landing gear/useless part.SLDPRT

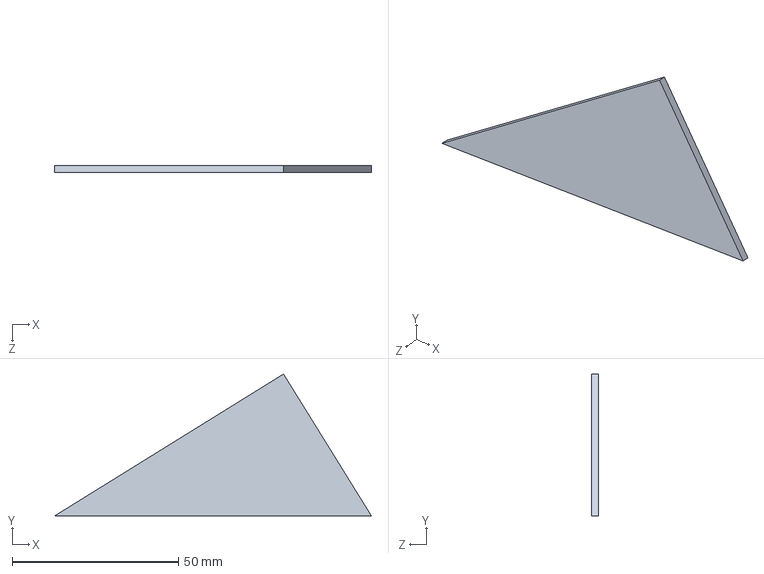
[picture p112: CAD file, 2022-06-29]
CAD/landing gear/useless part.SLDPRT
95.3 x 42.7 x 2.00 mm
