haggis-aerospace/HaggisAero2021-22/CAD/Motor rotator 2/Motor Tmotor mn3520-11 400kv.SLDPRT

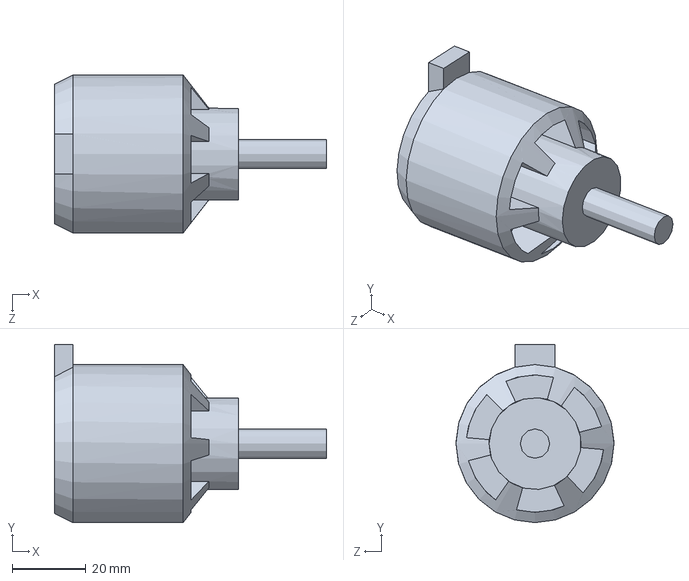
[picture p113: CAD file, 2022-04-14]
CAD/Motor rotator 2/Motor Tmotor mn3520-11 400kv.SLDPRT
74.0 x 48.5 x 43.0 mm
