haggis-aerospace/HaggisAero2021-22/CAD/STLFiles/Rotator Base 2.STL

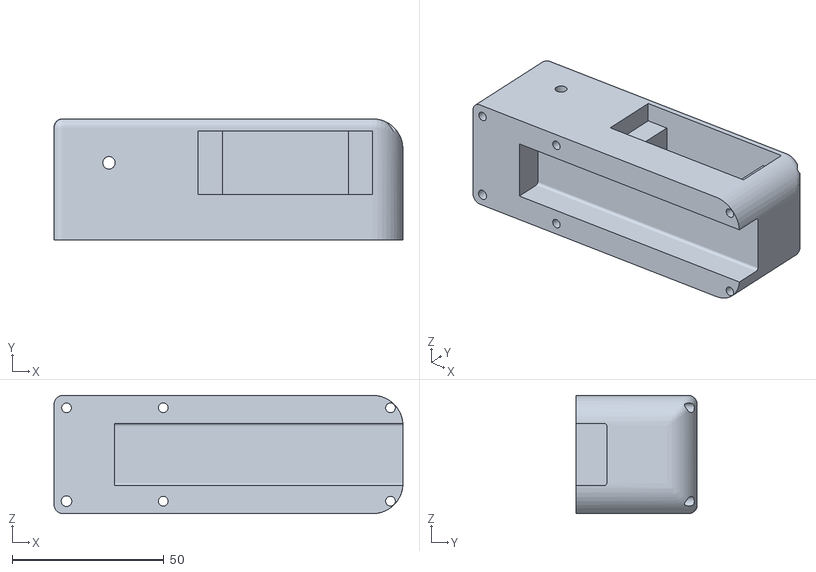
[picture p114: CAD file, 2022-04-07]
CAD/STLFiles/Rotator Base 2.STL
115.0 x 40.0 x 39.0
