haggis-aerospace/HaggisAero2021-22/CAD/Tail/Tail airfoil.SLDPRT

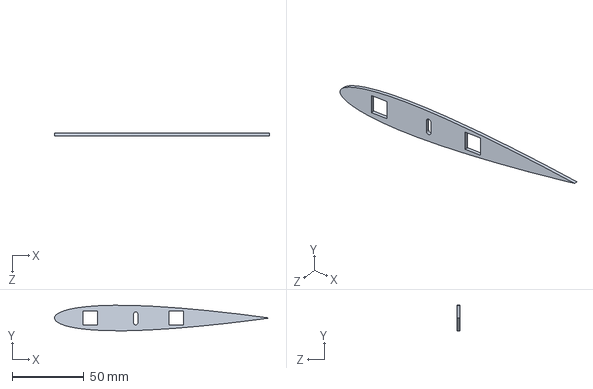
[picture p115: CAD file, 2022-03-10]
CAD/Tail/Tail airfoil.SLDPRT
150.0 x 17.8 x 2.00 mm
