haggis-aerospace/HaggisAero2021-22/manufacturing/Wing/2nd sheet.DXF

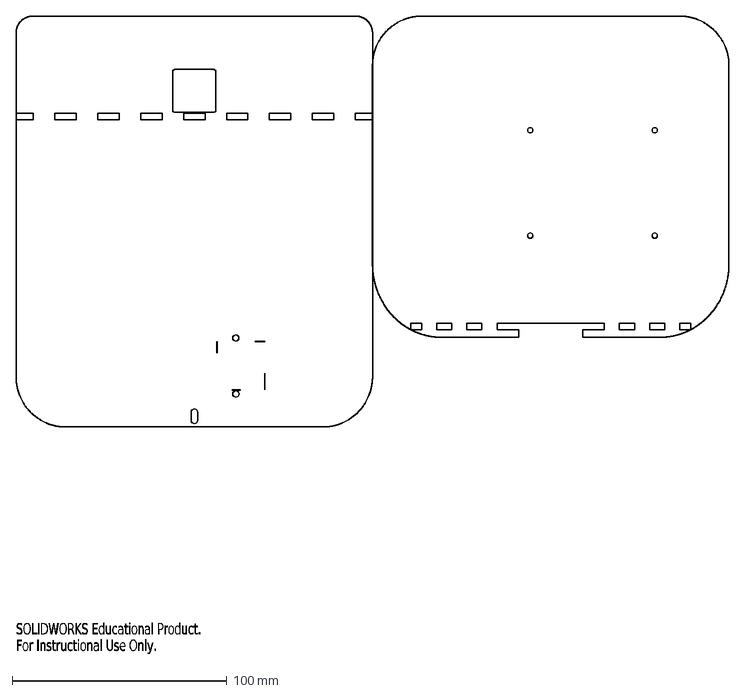
[picture p116: CAD file, 2022-04-07]
manufacturing/Wing/2nd sheet.DXF
SOLIDWORKS Educational Product.
For Instructional Use Only.
