haggis-aerospace/HaggisAero2021-22/CAD/Electronics/rasbery pi/Enclosure Base - 10MSW.sldprt

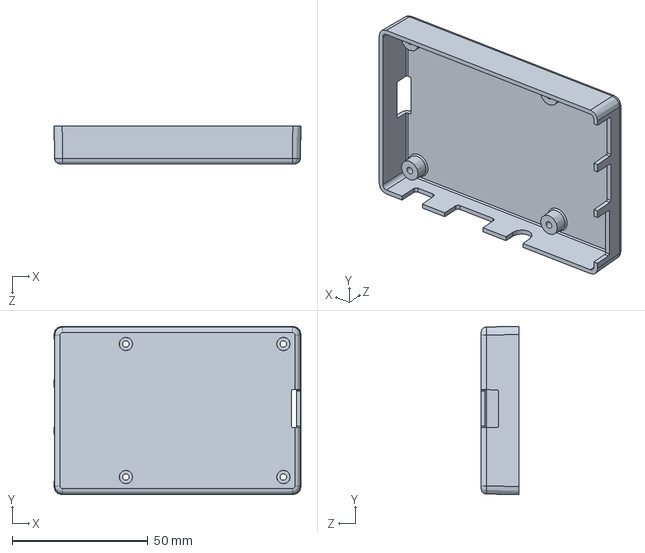
[picture p117: CAD file, 2022-02-02]
CAD/Electronics/rasbery pi/Enclosure Base - 10MSW.sldprt
91.0 x 62.0 x 14.0 mm
