haggis-aerospace/HaggisAero2021-22/CAD/Electronics/release mech connecting rod.SLDPRT

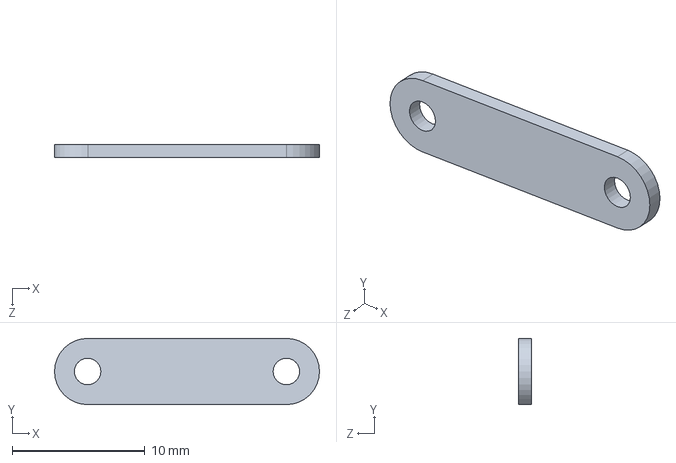
[picture p118: CAD file, 2022-02-02]
CAD/Electronics/release mech connecting rod.SLDPRT
20.0 x 5.00 x 1.00 mm
