haggis-aerospace/HaggisAero2021-22/CAD/Fuselage/temporary front landing gear.SLDPRT

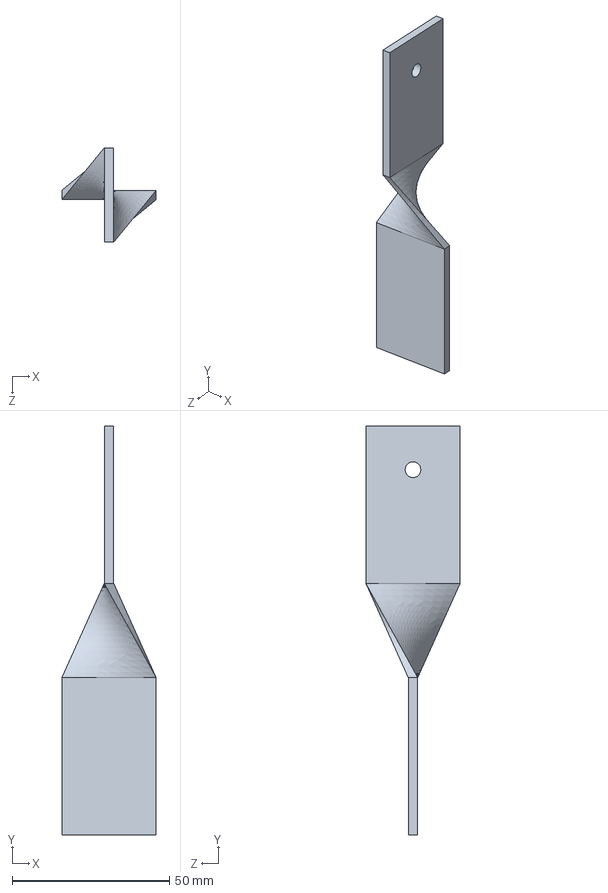
[picture p119: CAD file, 2022-03-15]
CAD/Fuselage/temporary front landing gear.SLDPRT
30.0 x 130.0 x 30.0 mm
