haggis-aerospace/HaggisAero2021-22/CAD/rotating mtr mount/rotaty base.SLDPRT

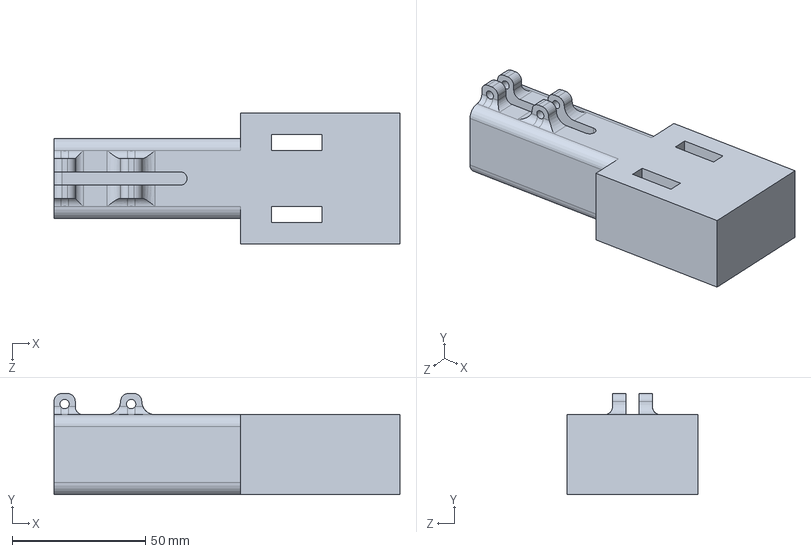
[picture p120: CAD file, 2022-06-10]
CAD/rotating mtr mount/rotaty base.SLDPRT
130.0 x 38.0 x 49.4 mm
