haggis-aerospace/HaggisAero2021-22/CAD/STLFiles/MirrorTail_Mount_M3_Recessions_Added.STL

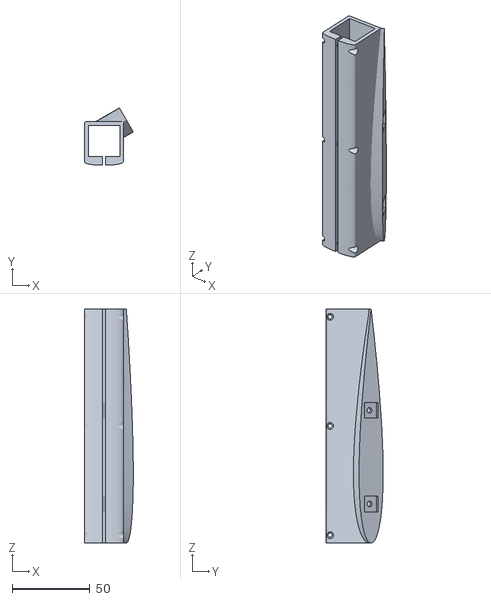
[picture p121: CAD file, 2022-04-07]
CAD/STLFiles/MirrorTail_Mount_M3_Recessions_Added.STL
31.2 x 36.7 x 150.0
