haggis-aerospace/HaggisAero2021-22/CAD/Tail/Spar_inserts.SLDPRT

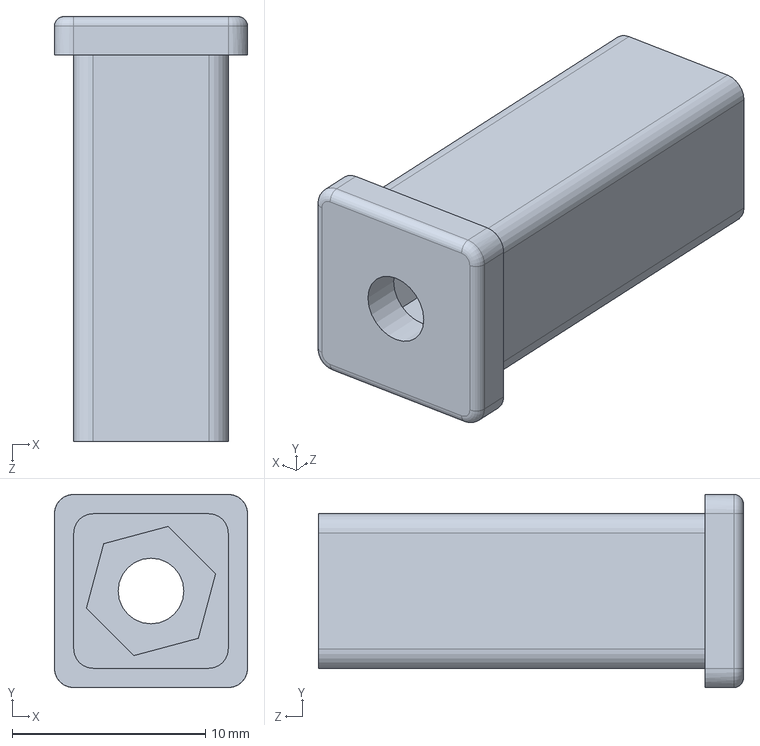
[picture p122: CAD file, 2022-03-10]
CAD/Tail/Spar_inserts.SLDPRT
10.0 x 10.0 x 22.0 mm
