haggis-aerospace/HaggisAero2021-22/manufacturing/Wing/1st sheet.DXF

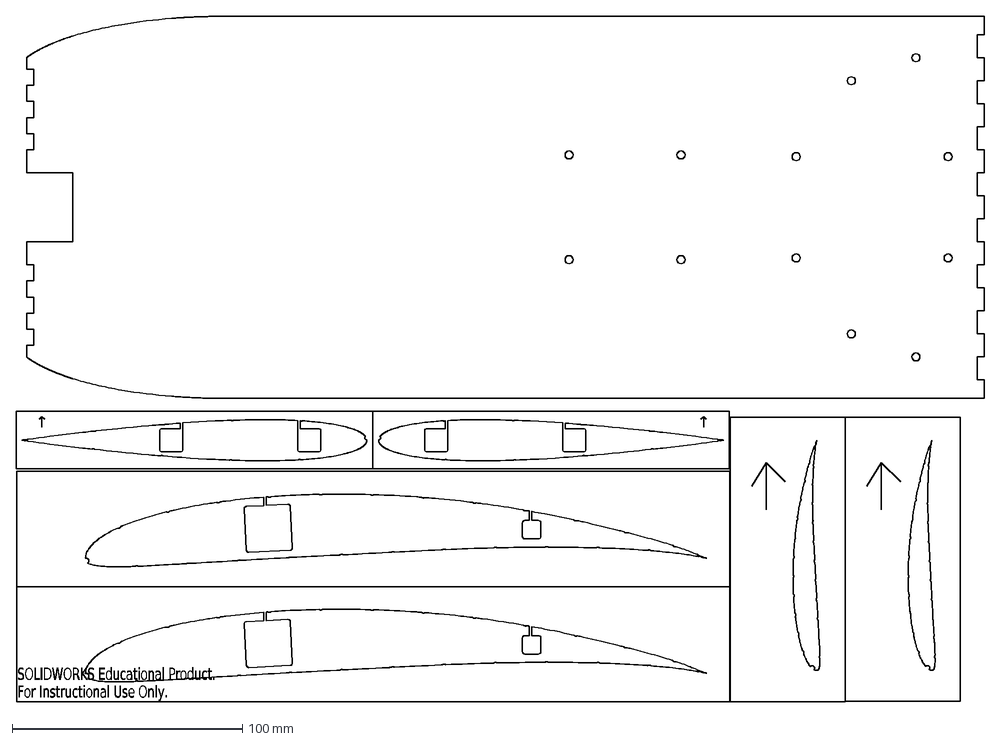
[picture p123: CAD file, 2022-04-07]
manufacturing/Wing/1st sheet.DXF
SOLIDWORKS Educational Product.
For Instructional Use Only.
