haggis-aerospace/HaggisAero2021-22/CAD/Electronics/Transmitter Body.SLDPRT

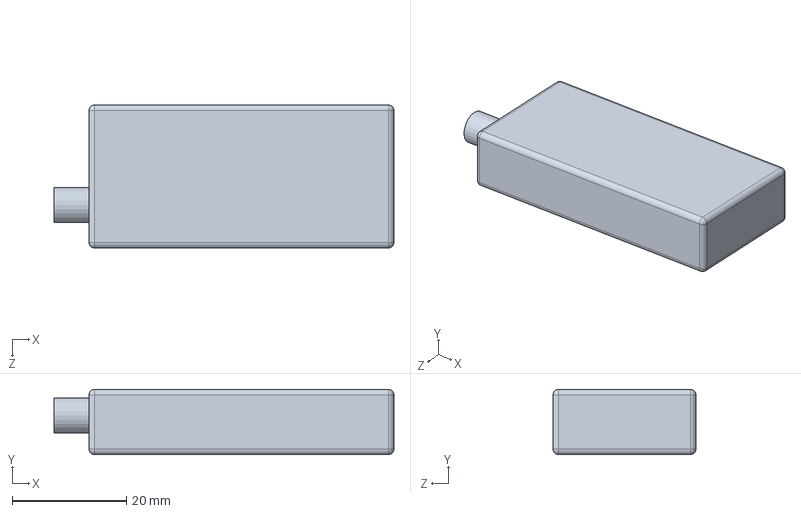
[picture p124: CAD file, 2022-02-02]
CAD/Electronics/Transmitter Body.SLDPRT
59.4 x 11.4 x 25.0 mm
