haggis-aerospace/HaggisAero2021-22/CAD/landing gear/thin CF tube.SLDPRT

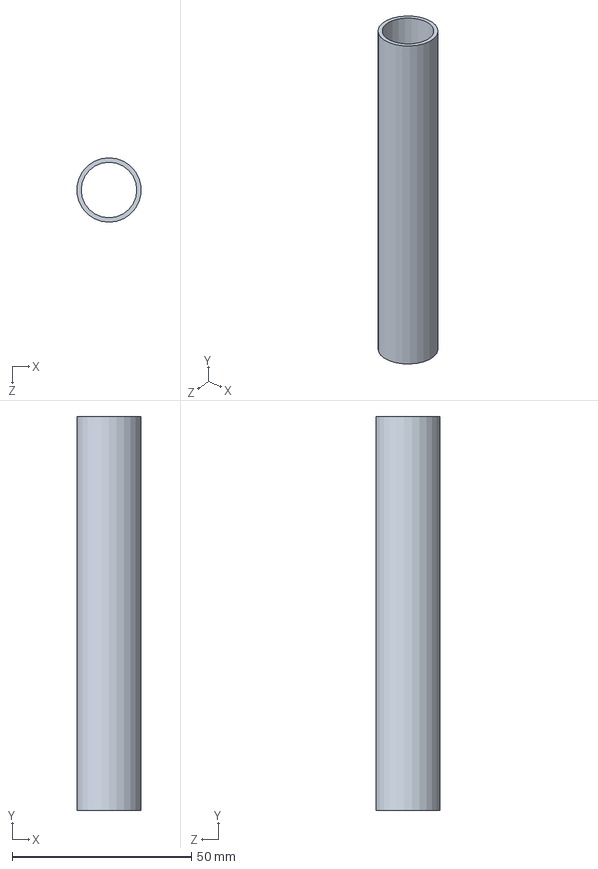
[picture p125: CAD file, 2022-06-29]
CAD/landing gear/thin CF tube.SLDPRT
17.9 x 110.0 x 18.0 mm
