haggis-aerospace/HaggisAero2021-22/CAD/Tail/Tail airfoil cutout.SLDPRT

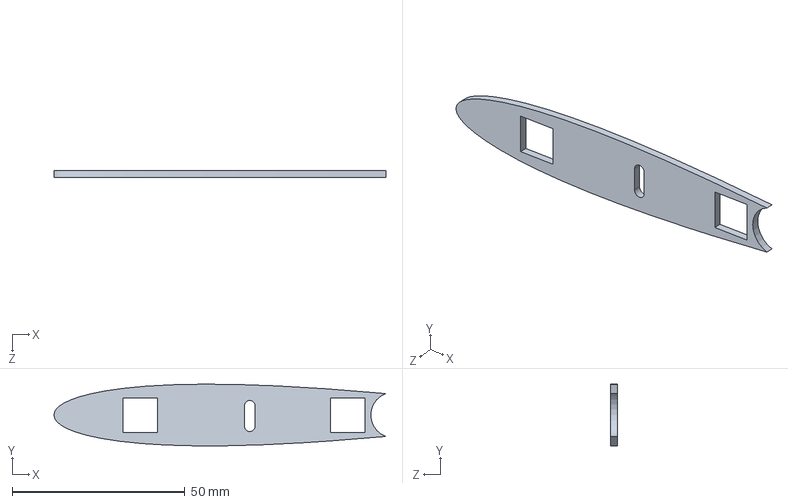
[picture p126: CAD file, 2022-03-10]
CAD/Tail/Tail airfoil cutout.SLDPRT
96.1 x 17.9 x 2.00 mm
