haggis-aerospace/HaggisAero2021-22/(list of files, cad)

Other CAD files:
CAD/Motor rotator 2/MirroredMotor rotator assembly 3.SLDASM
CAD/Electronics/rasbery pi/CameraAssembly.sldprt
CAD/MirrorTail.SLDASM
CAD/Wing/Mirrored wing assembly.SLDASM
manufacturing/Wing/main wing stencil x3.DWG
CAD/STLFiles/main spar side holder.STL
CAD/Wing/Mirrored MainFoil.SLDPRT
CAD/Electronics/rasbery pi/Mainboard2.sldprt
CAD/Wing/Mirrored main wing stencil.SLDPRT
CAD/Wing/MirrorMainFoil.SLDPRT
CAD/Wing/Mirrorwing assembly.SLDASM
CAD/Electronics/rasbery pi/usb double.sldprt
CAD/Fuselage/front landing gear.SLDPRT
CAD/Tail/MirrorTail_Mount_M3_Recessions_Added.SLDPRT
CAD/Electronics/rasbery pi/MicroSDSocket.sldprt
CAD/Fuselage/Top plate.SLDPRT
CAD/rotating mtr mount/ROUND SERVO ARM ONYX.stp.SLDPRT
CAD/Tail/Tail_Mount_M3_Recessions_Added.SLDPRT
CAD/Electronics/battery 2s 4p.SLDPRT
CAD/Fuselage/3dp parts/Mirrorsecondary spar side holder.SLDPRT
CAD/Fuselage/fuselage front plate.SLDPRT
CAD/rotating mtr mount/4-PRONG SERVO ARM ONYX.stp.SLDPRT
manufacturing/fuselage mold/rear right 3of4.SLDPRT
CAD/Electronics/rasbery pi/MicroSD.sldprt
CAD/Fuselage/3dp parts/secondary spar side holder.SLDPRT
CAD/Fuselage/fuselage rear plate.SLDPRT
CAD/Motor rotator 2/MirroredFork 3.SLDPRT
CAD/rotating mtr mount/rotaty base 2.SLDPRT
CAD/Electronics/rasbery pi/micro USB2.sldprt
CAD/Fuselage/Mirrortemporary landing gear rear.SLDPRT
CAD/Motor rotator 2/MirroredMotor Tmotor mn3520-11 400kv.SLDPRT
CAD/Tail/tail-wing connector lower.SLDPRT
CAD/Wing/Mirrored tail wing conector.SLDPRT
CAD/Motor rotator 2/MirrorFork 3.SLDPRT
CAD/STLFiles/Rotator bottom.STL
CAD/Tail/Tail_Top_Piece_V2.SLDPRT
CAD/Wing/tail wing conector.SLDPRT
manufacturing/fuselage mold/front left 1of4.SLDPRT
CAD/rotating mtr mount/ROUND SERVO ARM ONYX 2.SLDPRT
CAD/Motor rotator 2/MirrorRotator Base 2.SLDPRT
CAD/Wing/Mirrored wing spar small.SLDPRT
CAD/Fuselage/Part1.SLDPRT
CAD/Motor rotator 2/MirroredServo futaba.SLDPRT
CAD/rotating mtr mount/S45 ONYX STANDARD METAL GEAR SERVO (EYELET).stp.SLDPRT
CAD/Wing/Mirrored Battery.SLDPRT
CAD/Electronics/9g servo.SLDPRT
CAD/Electronics/Battery.SLDPRT
CAD/Electronics/Buzzer.SLDPRT
CAD/Electronics/Towerpro Micro Servo 9g.SLDPRT
CAD/Electronics/camera.SLDPRT
CAD/Electronics/rasbery pi/Enclosure Base.sldprt
CAD/Electronics/rasbery pi/Enclosure Top - 10MSW.sldprt
CAD/Electronics/rasbery pi/GPIO.sldprt
CAD/Electronics/rasbery pi/GPU.sldprt
CAD/Electronics/rasbery pi/HDMI.sldprt
CAD/Electronics/rasbery pi/M2x10 Screw.SLDPRT
CAD/Electronics/rasbery pi/Processor.sldprt
CAD/Electronics/rasbery pi/RAM.sldprt
CAD/Electronics/rasbery pi/RJ45-LED.sldprt
CAD/Electronics/rasbery pi/RaspberryPi(2).sldasm
CAD/Electronics/reease pin.SLDPRT
CAD/Fuselage/3dp parts/main spar side holder - Copy.SLDPRT
CAD/Fuselage/Inner space of fuselage.SLDPRT
CAD/Fuselage/cargo door V2.SLDPRT
CAD/Fuselage/cargo door wood V2.SLDPRT
CAD/Fuselage/center spar connector.SLDPRT
CAD/Fuselage/door handle.SLDPRT
CAD/Fuselage/fuselage mould.SLDPRT
CAD/Fuselage/hinge part 1 v2.SLDPRT
CAD/Fuselage/hinge part 2 v2.SLDPRT
CAD/Fuselage/makeProjectedPlanarWire.x_t
CAD/Fuselage/payload bay bottom lid cover v2.sldprt
CAD/Fuselage/small center sparr connector.SLDPRT
CAD/Fuselage/temporary landing gear rear.SLDPRT
CAD/Fuselage/wheel.SLDPRT
CAD/Motor rotator 2/Fork 3.SLDPRT
CAD/Motor rotator 2/MirrorMotor Tmotor mn3520-11 400kv.SLDPRT
CAD/Motor rotator 2/MirrorRotator bottom.SLDPRT
CAD/Motor rotator 2/MirrorServo futaba.SLDPRT
CAD/Motor rotator 2/MirroredRotator Base 2.SLDPRT
CAD/Motor rotator 2/MirroredRotator bottom.SLDPRT
CAD/Motor rotator 2/Rotator Base 2.SLDPRT
CAD/Motor rotator 2/Spar.SLDPRT
CAD/Motor rotator 2/makeProjectedPlanarWire.x_t
CAD/Motor rotator 2/spur gear_iso.SLDPRT
CAD/STLFiles/main spar side holder - Copy.STL
CAD/Tail/Tail Spar.SLDPRT
CAD/Wing/Battery.SLDPRT
CAD/Wing/FoilInsert.SLDPRT
CAD/Wing/MirrorBattery.SLDPRT
CAD/Wing/Mirrored battery 4s 2p.SLDPRT
CAD/Wing/Mirrored wing spar large.SLDPRT
CAD/Wing/Mirrored wing tip stencil.SLDPRT
CAD/Wing/Mirrorwing spar large.SLDPRT
CAD/Wing/Mirrorwing spar small.SLDPRT
CAD/Wing/center spar connector.SLDPRT
CAD/Wing/makeProjectedPlanarWire.x_t
CAD/Wing/small center sparr connector.SLDPRT
CAD/Wing/wing spar large.SLDPRT
CAD/Wing/wing spar small.SLDPRT
CAD/fasteners/bolt m3 16mm.SLDPRT
CAD/fasteners/bolt m3 30mm.SLDPRT
CAD/fasteners/nut m3.SLDPRT
CAD/landing gear/base v2.SLDPRT
CAD/landing gear/front landing gear frame.SLDDRW
CAD/landing gear/front landing gear frame.SLDPRT
CAD/landing gear/lower part.SLDDRW
CAD/landing gear/v2 front.SLDDRW
CAD/landing gear/wheel forn.SLDPRT
CAD/makeProjectedPlanarWire.x_t
CAD/rotating mtr mount/APC 12x6 EP Prop.SLDPRT
CAD/rotating mtr mount/MirrorAPC 12x6 EP Prop.SLDPRT
CAD/rotating mtr mount/S45 ONYX STANDARD METAL GEAR SERVO (GROMMET).stp.SLDPRT
CAD/rotating mtr mount/S45 ONYX STANDARD METAL GEAR SERVO (M3 SCREW).stp.SLDPRT
CAD/rotating mtr mount/S45 ONYX STANDARD METAL GEAR SERVO (SCREW).stp.SLDPRT
CAD/rotating mtr mount/S45 ONYX STANDARD METAL GEAR SERVO.stp.SLDPRT
CAD/rotating mtr mount/Servo futaba.SLDPRT
CAD/rotating mtr mount/rotaty plate.SLDPRT
manufacturing/Endplates/Main Wing Endplate.STL
manufacturing/Endplates/Tail wing endplate.STL
manufacturing/Endplates/Wing-Tip connector.STL
manufacturing/Wing/1st sheet.SLDDRW
manufacturing/Wing/2nd sheet.SLDDRW
manufacturing/Wing/FAT main wing stencil.SLDDRW
manufacturing/Wing/back stencil.SLDPRT
manufacturing/Wing/main wing stencil x1.SLDDRW
manufacturing/Wing/main wing stencil x3.SLDDRW
manufacturing/Wing/wing tip stencil.SLDPRT
manufacturing/fuselage mold/front left 1of4.STL
manufacturing/fuselage mold/front right 2of4.STL
manufacturing/fuselage mold/fuselage Mould drawing.SLDDRW
manufacturing/fuselage mold/mould cutouts.SLDDRW
manufacturing/fuselage mold/rear left 4of4.STL
manufacturing/fuselage mold/rear right 3of4.STL
manufacturing/stl's for 3 print/rotaty mtr mount/rotaty base 2.STL
