haggis-aerospace/HaggisAero2021-22/manufacturing/fuselage mold/Drawing for the mold.JPG

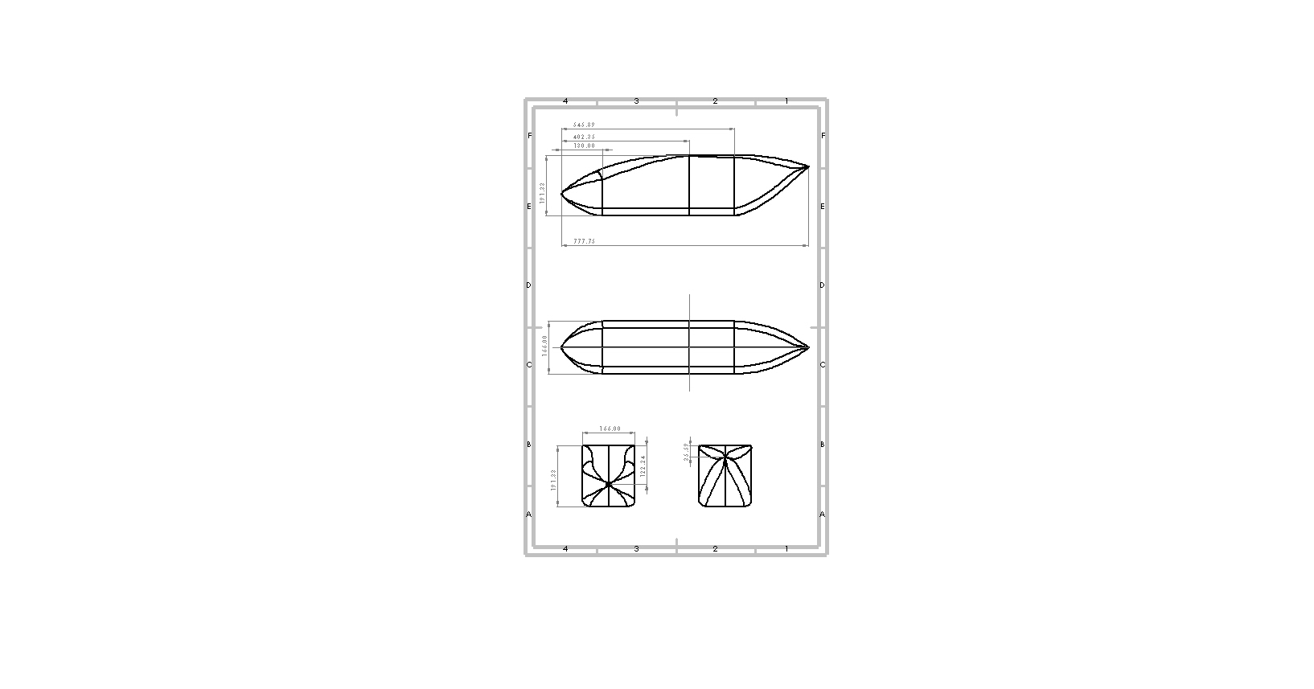
manufacturing/fuselage mold/Drawing for the mold.JPG
