haggis-aerospace/HaggisAero2021-22/manufacturing/fuselage mold/fuselage Mould drawing for print A1.JPG

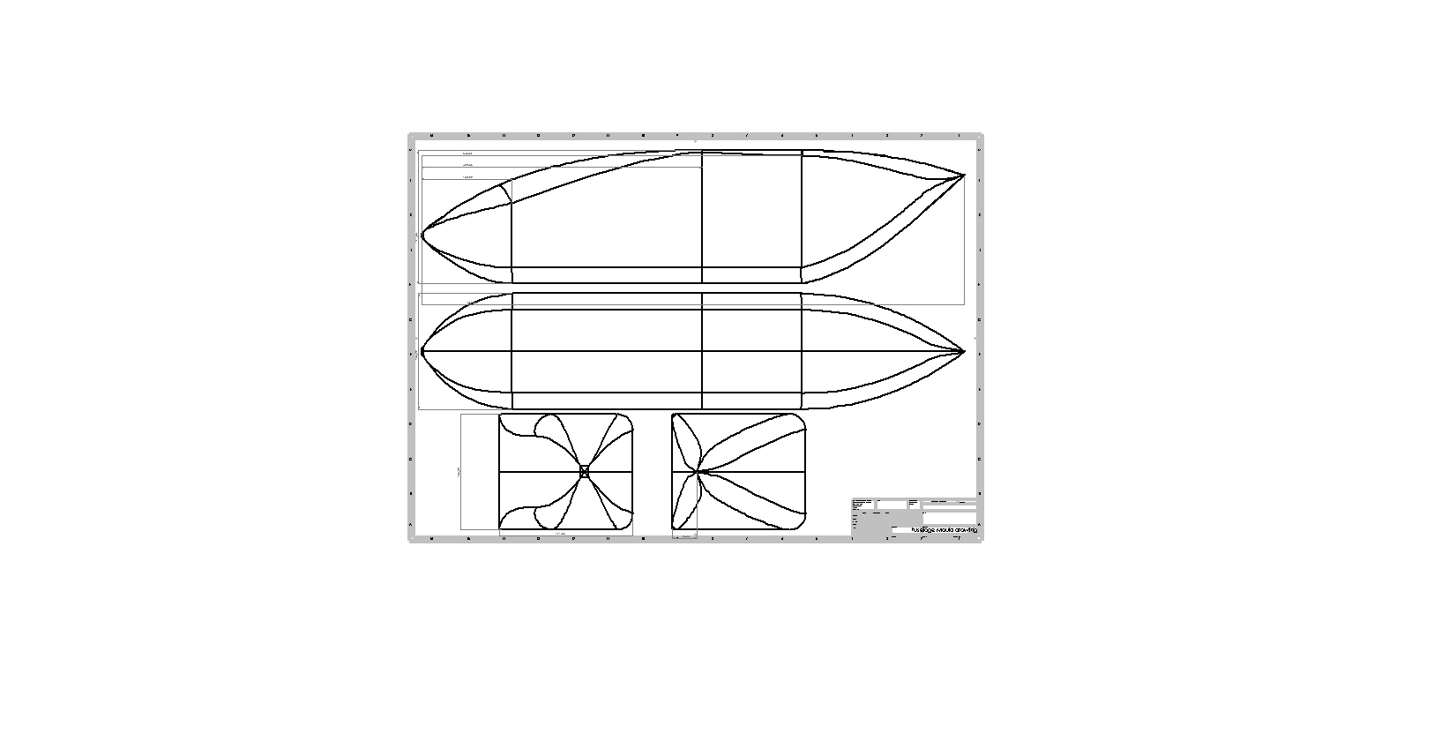
manufacturing/fuselage mold/fuselage Mould drawing for print A1.JPG
