haggis-aerospace/HaggisAero2021-22/manufacturing/fuselage mold/mould cutouts.JPG

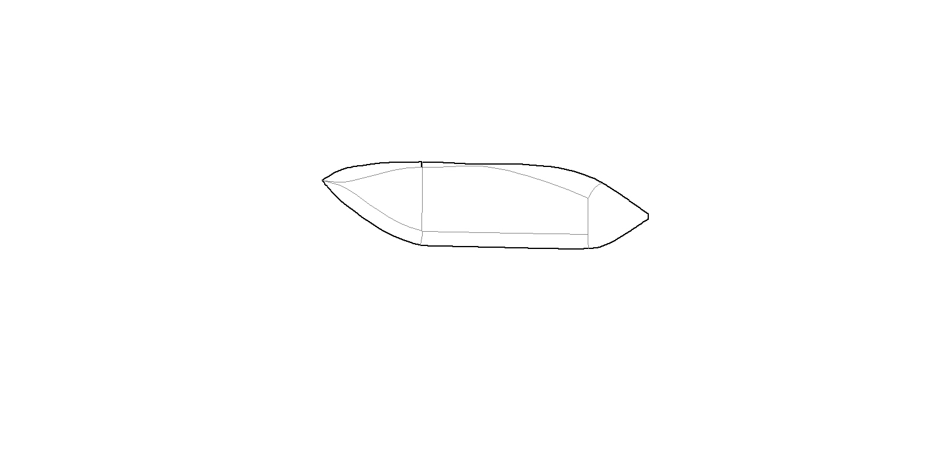
manufacturing/fuselage mold/mould cutouts.JPG
