haggis-aerospace/HaggisAero2021-22/CAD/landing gear/v2 front gear drawing.pdf

E E

F F

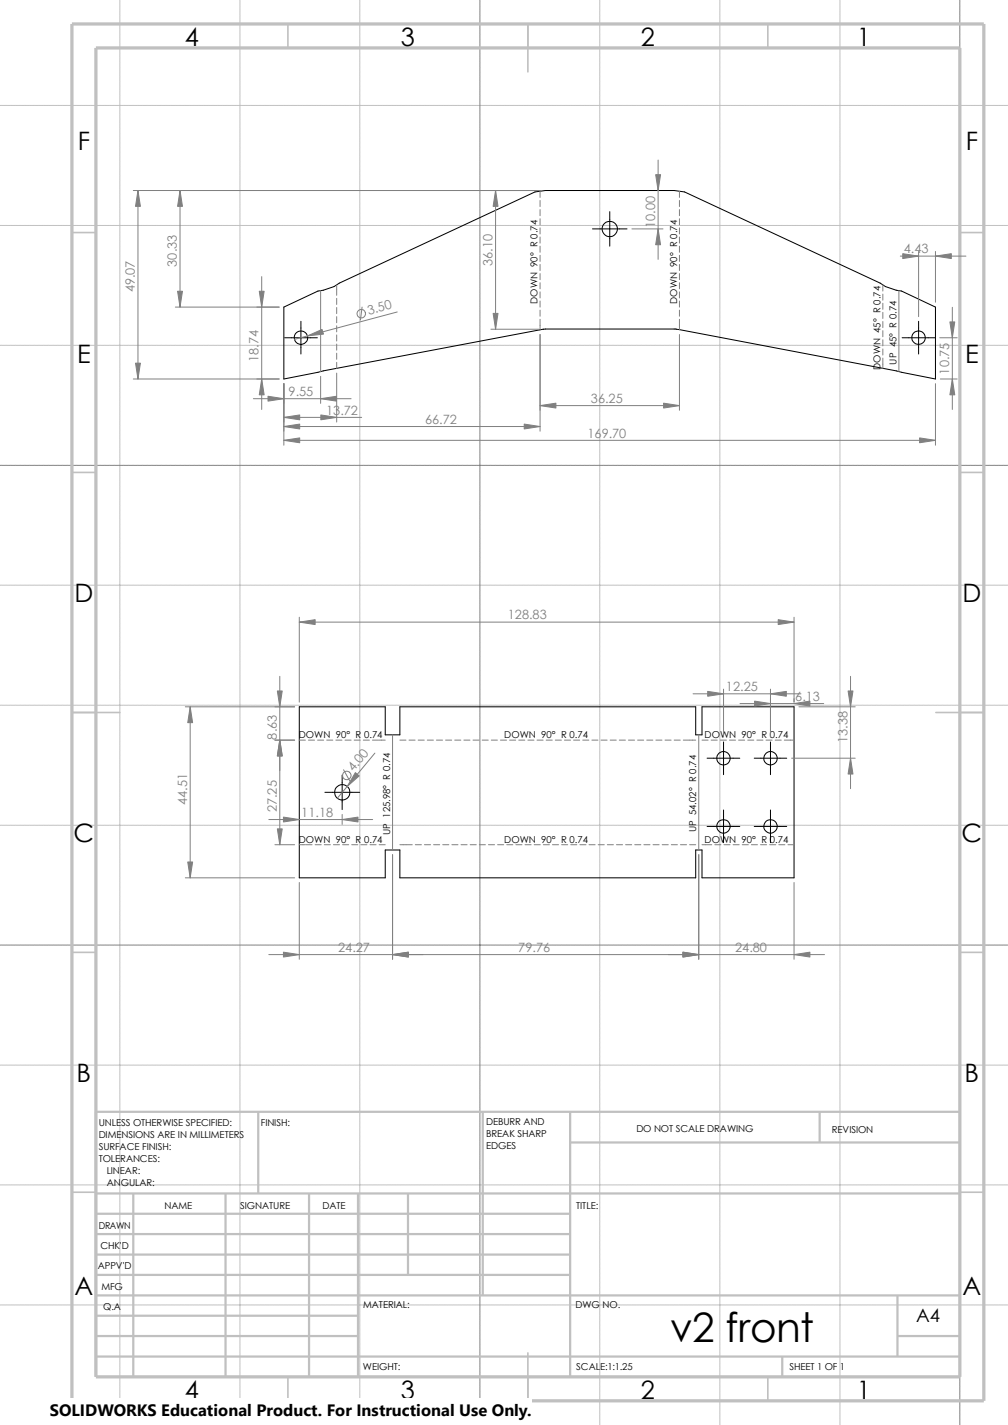
[picture p130: page 1]
DWG NO.; DO NOT SCALE DRAWING; REVISION; MFG; FINISH:; EDGES; MATERIAL:; DEBURR AND BREAK SHARP; v2 front DOWN ⁹⁰° R 0.74; DOWN ⁴⁵° R 0.74 DOWN ⁹⁰° R 0.74 18.74; DOWN 90° R 0.74; DOWN 90° R 0.74 UP 125.98° R 0.74 8.63

UNLESS OTHERWISE SPECIFIED:
DIMENSIONS ARE IN MILLIMETERS
SURFACE FINISH:
TOLERANCES:
LINEAR:
ANGULAR:

NAME | SIGNATURE | DATE | TITLE:

DRAWN
CHK'D
APPV'D

WEIGHT: | SCALE:1:1.25 | SHEET 1 OF 1

SOLIDWORKS Educational Product. For Instructional Use Only.
