haggis-aerospace/HaggisAero2021-22/manufacturing/fuselage mold/mould cutouts bottom a0.PDF

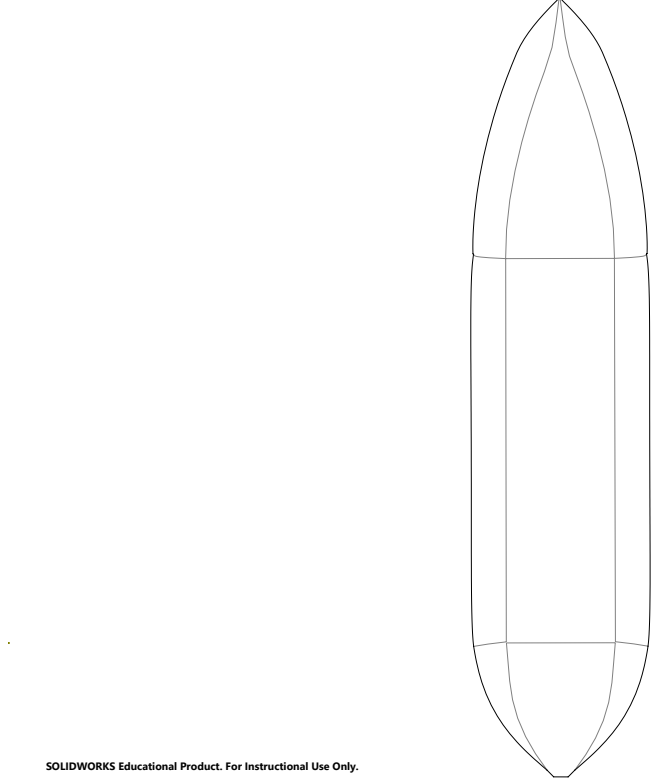
[picture p131: page 1]

SOLIDWORKS Educational Product. For Instructional Use Only.
