haggis-aerospace/HaggisAero2021-22/manufacturing/fuselage mold/mould cutouts bottom.PDF

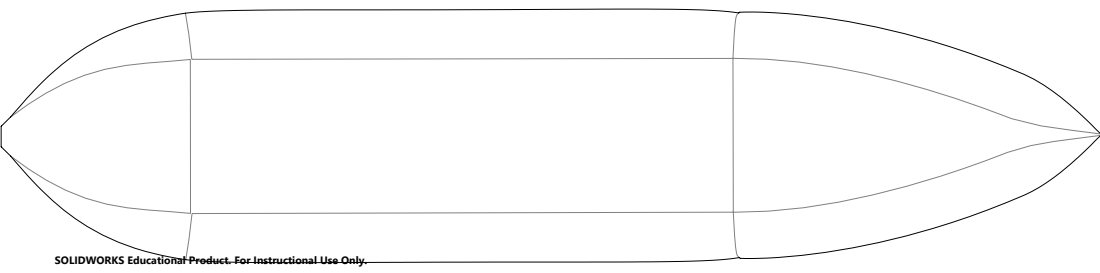
[picture p132: page 1]

SOLIDWORKS Educational Product. For Instructional Use Only.
