haggis-aerospace/HaggisAero2021-22/manufacturing/fuselage mold/mould cutouts side a0.PDF

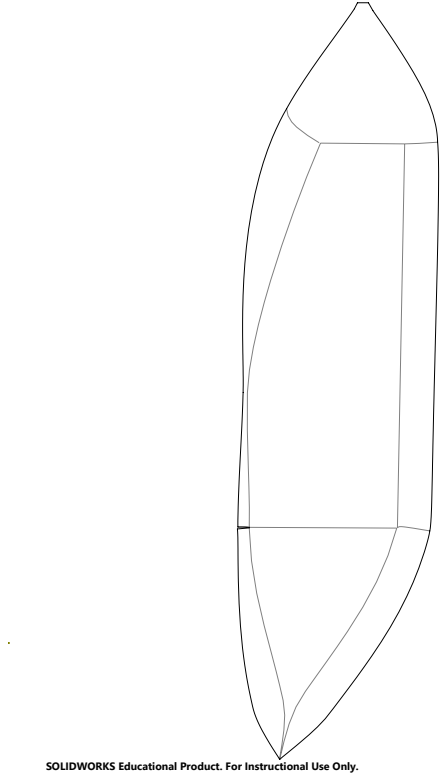
[picture p133: page 1]

SOLIDWORKS Educational Product. For Instructional Use Only.
