haggis-aerospace/HaggisAero2021-22/manufacturing/fuselage mold/mould cutouts top a0.pdf

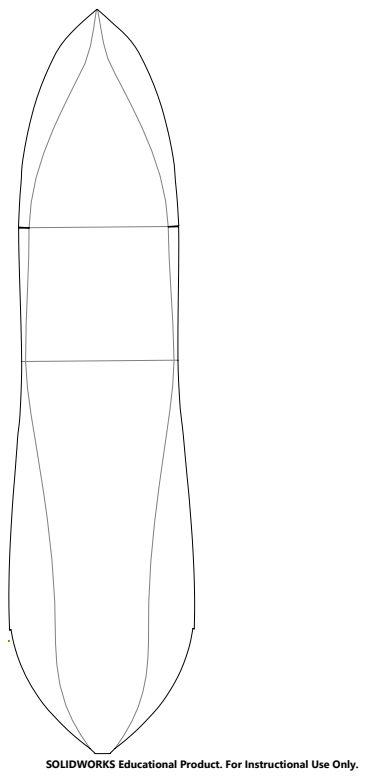
[picture p134: page 1]

SOLIDWORKS Educational Product. For Instructional Use Only.
