haggis-aerospace/HaggisAero2021-22/manufacturing/fuselage mold/mould cutouts top.PDF

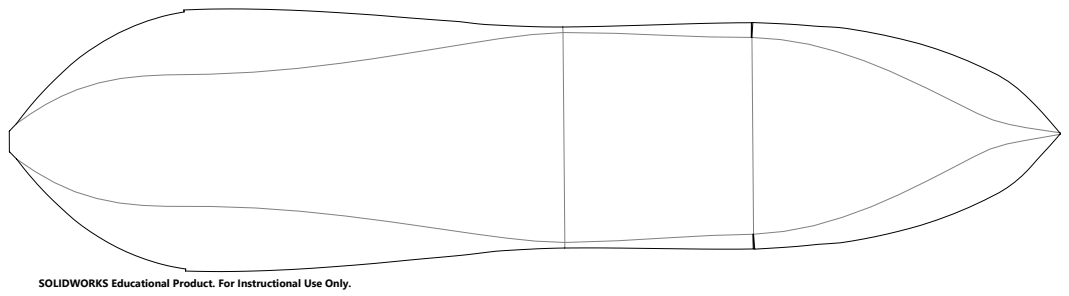
[picture p135: page 1]

SOLIDWORKS Educational Product. For Instructional Use Only.
