haggis-aerospace/HaggisAero2021-22/manufacturing/fuselage mold/mould cutouts.pdf

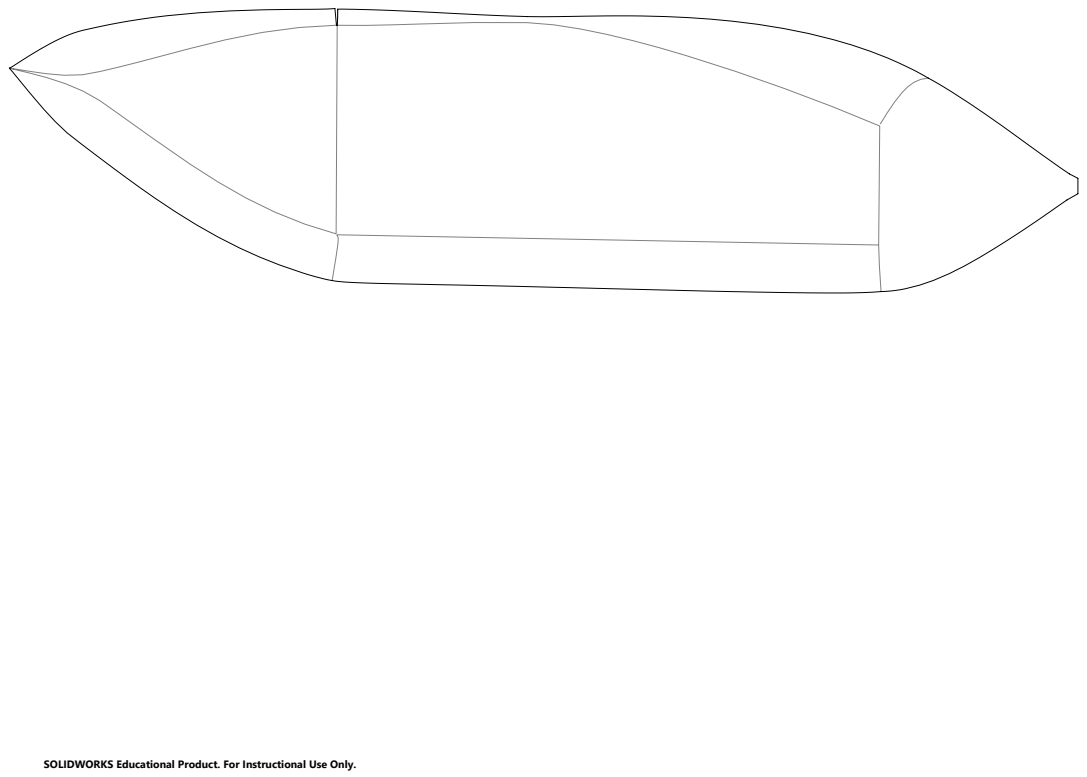
[picture p136: page 1]

SOLIDWORKS Educational Product. For Instructional Use Only.
