haggis-aerospace/HaggisAero2021-22/renders/drawingsss.pdf

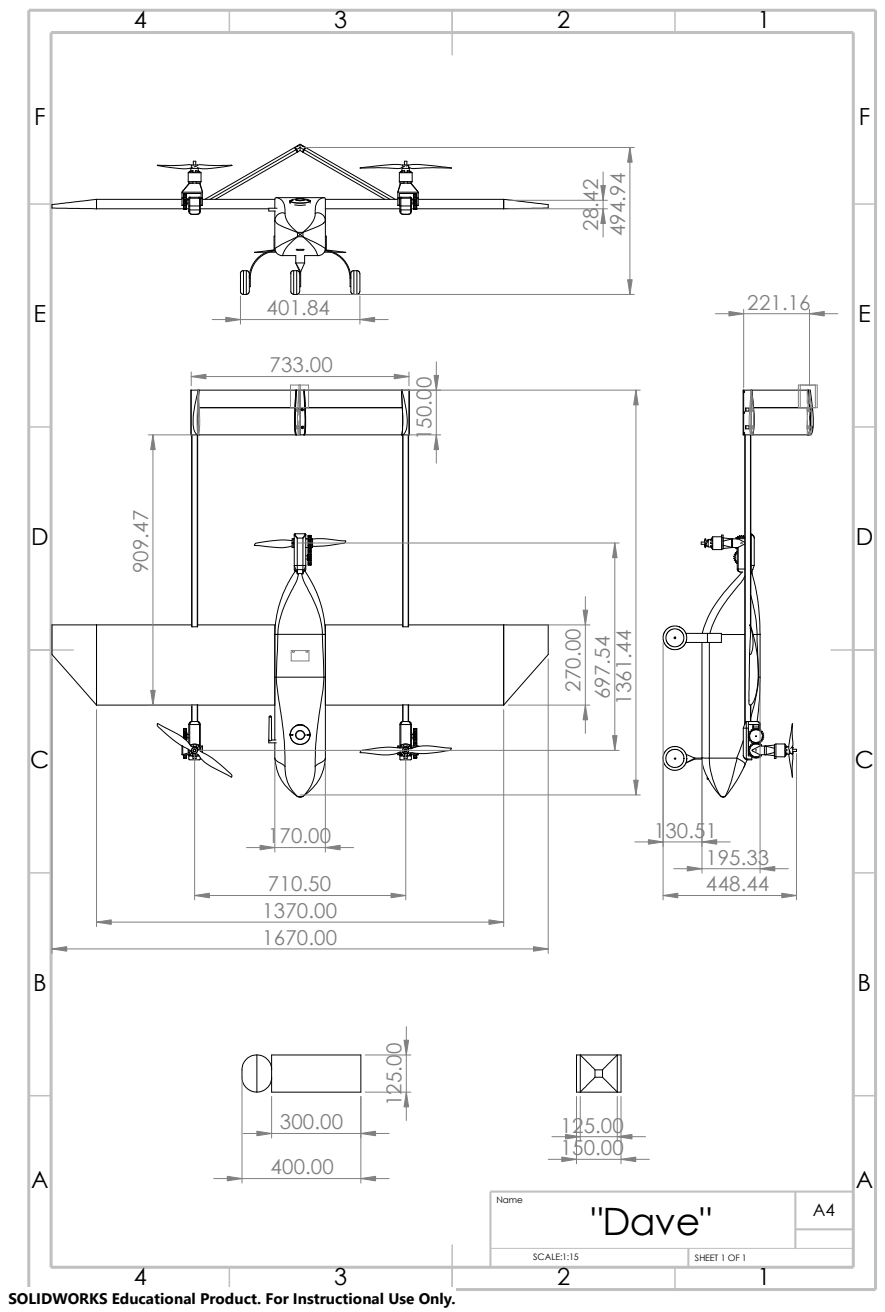
[picture p137: page 1]

Name | A4 "Dave"

SCALE:1:15 | SHEET 1 OF 1

SOLIDWORKS Educational Product. For Instructional Use Only.
