haggis-aerospace/HaggisAero2021-22/(commit log)

2021-11-09 Fuselage
    Body and payload
    [Parachute.SLDPRT, Payload.SLDPRT, Payload_ASM.SLDPRT.SLDASM, fuselage.SLDPRT]
2021-12-28 Set up main assemblies
    set up the main assemblies and subassemblies as well as the master assy, making sure to keep everything in the centre of the coordinate system and defined well. people can start working in their own assemblies now
    [Fuselage assy.SLDASM, Masterr assembly.SLDASM, Mirrorwing assembly.SLDASM, Mirrorwing spar large.SLDPRT, Mirrorwing spar small.SLDPRT, PParachute.SLDPRT, Payload assy.SLDASM, Payload_ASM.SLDPRT.SLDASM]
2022-01-03 small change to main assy and added the concept file
    also added the aeolus simulation file, which seems to be producing really weird results. with the motors working it shows the lift being lower than without them
    [Fuselage assy.SLDASM, Masterr assembly.SLDASM, Payload assy.SLDASM, drone concept.SLDPRT]
2022-01-27 Minor fuselage update, aerodynamic simulations of the fuselgae
    [Fuselage assy.SLDASM, Masterr assembly.SLDASM, Payload assy.SLDASM, Top plate fuselgaee v2.SLDPRT, cargo door V2.SLDPRT, cargo door wood V2.SLDPRT, door assemblyV2.SLDASM, drag estimate.SLDPRT]
2022-01-27 Main foil
    add main wing
    [MainFoil.SLDPRT, Masterr assembly.SLDASM, Payload assy.SLDASM, wing assembly.SLDASM]
2022-01-27 Cutout for spar
    Cutout for spar
    [MainFoil.SLDPRT, Masterr assembly.SLDASM, wing assembly.SLDASM]
2022-01-28 Misc changes
    [FoilInsert.SLDPRT, makeProjectedPlanarWire.x_t]
2022-02-02 need to check another branch real quick
    not much changed, added a plate and moved center connectors from wing assembly to fuselage assembly
    [Fuselage assy.SLDASM, Inner space of fuselage.SLDPRT, Masterr assembly.SLDASM, PParachute.SLDPRT, Payload assy.SLDASM, Top plate fuselgaee v2.SLDPRT, Top plate.SLDPRT, drag estimate.SLDPRT]
2022-02-02 added the fuselage carbon fiber shell and insides
    added the basic structure of the fuselgae with the carbon fiber shell. Separate file called "Fuselage body" can be used to make the Foam mold. technically the shell could be manufactured already. if anyone sees why not, lmk. gonna try to combine with wings now
    [9g servo.SLDPRT, CameraAssembly.sldprt, Enclosure Base - 10MSW.sldprt, Enclosure Base.sldprt, Enclosure Top - 10MSW.sldprt, Enclosure Top .sldprt, GPIO.sldprt, GPU.sldprt]
2022-02-02 Finished fuselage and successfully merged with wings
    added molds for manufacturing fuselage, placed spars in to correct positions.
    [APC 12x6 EP Prop.SLDPRT, Inner space of fuselage.SLDPRT, MainFoil.SLDPRT, Payload assy.SLDASM, Tail motor spar.SLDPRT, Top plate.SLDPRT, center spar connector.SLDPRT, door assemblyV2.SLDASM]
2022-02-09 Updated fuselage, 1 3d printed part, added fasteners for reference,
    now this should be the final shape of the fuselage hopefully, started adding little bits as well like fasteners that we will likely use (for reference) and bits and bobs
    [MainFoil.SLDPRT, Mould die.SLDPRT, Payload assy.SLDASM, Top plate.SLDPRT, bolt m3 16mm.SLDPRT, bolt m3 30mm.SLDPRT, door assemblyV2.SLDASM, front left 1of4.SLDPRT]
2022-02-20 tail bracketry added (soz for pushing to main)
2022-02-24 Actually fixed tail stuff
    [MirrorTail_Mount_M3_Recessions_Added.SLDPRT, Tail_Mount_M3_Recessions_Added.SLDPRT, Tail_Top_Piece_V2.SLDPRT]
2022-03-09 version 1 of motor rotator
    [Fork.SLDPRT, Mock Prop.SLDPRT, Motor Rotator Assembly.SLDASM, Rotator Base.SLDPRT, Rotator Lid.SLDPRT]
2022-03-09 some more parts + tail part for josh
    [MirrorTail.SLDASM, MirrorTail_Mount_M3_Recessions_Added.SLDPRT, Mould die.SLDPRT, Part1.SLDPRT, Tail plus Secondary spar midle holder.SLDPRT, Tail.SLDASM, Tail_Mount_M3_Recessions_Added.SLDPRT, front left 1of4.SLDPRT]
2022-03-10 Tail update
    Tail update
    [Spar_inserts.SLDPRT, Tail Spar.SLDPRT, Tail airfoil cutout.SLDPRT, Tail airfoil.SLDPRT, Tail_Top_Piece_V2.SLDPRT]
2022-03-11 prototype of motor rotator attached to main assembly
    [Fork 3.SLDPRT, Motor Tmotor mn3520-11 400kv.SLDPRT, Motor rotator assembly 2.SLDASM, Motor rotator assembly 3.SLDASM, Rotator Base 2.SLDPRT, Rotator bottom.SLDPRT, Servo futaba.SLDPRT, Spar.SLDPRT]
2022-03-13 Changed wing and added battery
    Battery has correct mass
    Wing battery cut out
    [Battery.SLDPRT, MainFoil.SLDPRT, Motor rotator assembly 3.SLDASM, makeProjectedPlanarWire.x_t, wing assembly.SLDASM]
2022-03-15 Added a latch and electric connectors to side of fuselage
    just for reference
    [Fork 3.SLDPRT, MainFoil.SLDPRT, MirrorAPC 12x6 EP Prop.SLDPRT, MirrorBattery.SLDPRT, MirrorFork 3.SLDPRT, MirrorMainFoil.SLDPRT, MirrorMotor Tmotor mn3520-11 400kv.SLDPRT, MirrorMotor rotator assembly 3.SLDASM]
2022-04-01 STL Files
    Uncut stl files in CAD folder
    [Fork 3.STL, MirrorTail_Mount_M3_Recessions_Added.STL, Rotator Base 2.STL, Rotator bottom.STL, Tail_Top_Piece_V2.STL, main spar side holder - Copy.STL, main spar side holder.STL, secondary spar side holder.STL]
2022-04-07 Finished the wood parts and added drawing for making fuselage mold
    Added the stuff for laser cutting. Since the workshop is likely not making our shit on time we might have to make the foam bit of the fuselage ourseves
    [1st sheet.DXF, 1st sheet.SLDDRW, 2nd sheet.DXF, 2nd sheet.SLDDRW, Top plate.SLDPRT, back stencil.SLDPRT, battery 2s 4p llooong.SLDPRT, battery 2s 4p.SLDPRT]
2022-04-14 Added weight parameters
    Added rough weight parameters to estimate the weight, so far its 9kg
    [Fork 3.SLDPRT, MainFoil.SLDPRT, MirrorFork 3.SLDPRT, MirrorMainFoil.SLDPRT, MirrorMotor rotator assembly 3.SLDASM, MirrorRotator Base 2.SLDPRT, MirrorRotator bottom.SLDPRT, MirrorTail.SLDASM]
2022-06-06 Static motor mounts
    cum
    [FAT back stencil.SLDPRT, FAT main and back wing stencils.DXF, FAT main wing stencil.SLDDRW, FAT main wing stencil.SLDPRT, FAT main wing stencilS 3.DXF, base.SLDPRT, base.STL, main wing stencil x1.DXF]
2022-06-07 slightly changed the static mount
    added another clamp hole and made it longer
    [base.SLDPRT, base.STL, motor plate.SLDPRT, static motor mount assembly.SLDASM]
2022-06-10 added the mission part of the tail-wing connector
    super idol do she ru dome ni to tien
    [4-PRONG SERVO ARM ONYX.stp.SLDPRT, APC 12x6 EP Prop.SLDPRT, MirrorAPC 12x6 EP Prop.SLDPRT, Mirrored MainFoil.SLDPRT, Mirrored main wing stencil.SLDPRT, Mirrored tail wing conector.SLDPRT, Mirrored wing assembly.SLDASM, MirroredMotor rotator assembly 3.SLDASM]
2022-06-14 made the fuselage CF cutouts
    yup
    [Mirrored tail wing conector.SLDPRT, Mirrored wing assembly.SLDASM, fuselage Mould.SLDPRT, mould cutouts.SLDDRW, tail wing conector top.STL, tail wing conector.SLDPRT, tail-wing connector bottom.STL, tail-wing connector lower.SLDPRT]
2022-06-18 Wing face plate
    [Assem1.SLDASM, Main Wing Endplate.SLDPRT, Main Wing Endplate.STL, Tail wing endplate.SLDPRT, Tail wing endplate.STL, UMS5_Wing face plate.3mf]
2022-06-19 Wing-tip connector
    [Wing-Tip connector.SLDPRT, Wing-Tip connector.STL]
2022-06-20 More 3d printed parts
    [Wing plates.3mf, release mech hook.STL]
2022-06-21 merged chads and max's, Added more wing to tail connectors
    more 3d printed parts for tail to wing
    [MainFoil.SLDPRT, Mirrored MainFoil.SLDPRT, Mirrored wing assembly.SLDASM, Part3.SLDPRT, Small spar tail connector.SLDPRT, small spar tail-wing connector lower.SLDPRT, wing assembly.SLDASM]
2022-06-21 fixed the part last added (tail to wing connector small)
    Yo, Big Shaq, the one and only
    Man's not hot, never hot
    Skrrat (GottiOnEm), skidi-kat-kat
    Boom
    Two plus two is four
    Minus one that's three, quick maths
    Everyday man's on the block
    Smoke trees (Ah)
    See your girl in the park
    That girl is a uckers
    When the ting went quack-quack-quack
    You man were ducking (You man ducked)
    Hold tight, Asznee (My brudda)
    He's got the pumpy (Big ting)
    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
    [Small spar tail connector.SLDPRT, small spar tail-wing connector insert upper.SLDPRT, small spar tail-wing connector lower.SLDPRT, small spar tail-wing connector upper.SLDPRT]
2022-06-28 tail mount m3 change
    [MirrorTail_Mount_M3_Recessions_Added.SLDPRT, Tail_Mount_M3_Recessions_Added.SLDPRT]
2022-06-29 added the landing gear designs
    [assy lg v2.SLDASM, assy of LG.SLDASM, base v2.SLDPRT, base.SLDPRT, front landing gear frame.SLDDRW, front landing gear frame.SLDPRT, front landing gear.SLDPRT, lower part.SLDDRW]
2023-02-27 added tail to main
    [TAIL2023.SLDASM, tail assy.SLDASM, tail spar.SLDPRT]
